ebe542/hexaroam/firmware/README.md

# Firmware

Current protocol status (2026-11-03): version 2 uses ACK/NACK, with 82 protocol tests, 75 register tests and all 21 no-servo UART scenarios confirmed by the owner. Full local verification passed 462 tests and all 17 checks; CI for this revision has not yet been reported. The dated implementation notes below retain earlier milestones. For current behavior, see the [protocol contract](../docs/servo-register-protocol.md).

Rust firmware for the central Pico and optional future servo-output expansion modules. The current program blinks the onboard LED and generates fixed servo pulses on GP0 and GP1 through one PIO state machine and DMA of Raspberry Pi Pico with RP2040, targeting `thumbv6m-none-eabi`. Operation with an attached servo is not verified.

See [development setup](../docs/development-setup.md) for prerequisites and [hardware references](../hardware/references/README.md) for archived datasheets.

## Firmware applications

Applications are independent Cargo packages under `apps/`; reusable libraries remain directly under `firmware/`.

| Application | Current scope |
| --- | --- |
| `apps/servo-controller` | Existing Pico servo-output application and manual hardware-test examples |
| [apps/calibration-station](apps/calibration-station/README.md) | Startup firmware, application-owned command/control library and a manual single-channel PIO/DMA test |

Station-specific request decoding and pulse-control policy live in `apps/calibration-station/src/command.rs` and `control.rs`. Its `src/lib.rs` exposes these modules for host tests, while `main.rs` owns Pico initialization. Shared protocol framing remains in `servo-protocol`. The station library tests run with an explicit host target through the shared tooling.

Use `python tools/dev.py build --app calibration-station` or `python tools/dev.py uf2 --app calibration-station` from the repository root. Without `--app`, these commands select `servo-controller`. Shared checks and documentation include both applications; see [development tools](../tools/README.md#application-selection).

The owner confirmed the station's UF2 upload, blinking LED and UART1 output. Local verification passed 854 tests and all 23 checks; hardware builds passed all 63 checks. The station now also has a [manual single-channel output test](apps/calibration-station/hardware_tests/README.md), confirmed on unloaded GP0 with UART1 phase messages; the main application still only performs startup logging and LED heartbeat. PC command handling and EEPROM access remain pending.

The calibration-station command/control library now includes a [request handler and protocol contract](apps/calibration-station/protocol.md), with 40 station host tests. The owner reported full local verification of 895 tests and all 24 checks passing. CI was subsequently reported green for this command/control revision. The application-owned PioPulseBackend adapter was then verified through the [controlled single-channel example](apps/calibration-station/hardware_tests/README.md#controlled-single-channel-output): the owner confirmed 1500/1700 us pulses, stop behavior, all five station hardware-build checks and 895 tests with all 24 verify checks passing. Normal-loop UART/PIO integration and CI for the adapter/test addition remain pending.

## EEPROM calibration storage

The [24xx256 EEPROM driver](eeprom/README.md) provides byte reads and page writes. The [shared storage layer](servo-storage/README.md) provides format validation, incremental scanning, write planning and bounded verified rotation. The [EEPROM adapters](servo-eeprom/README.md) expose a read-only controller path and a writable station path through CalibrationRead and CalibrationStorage.

The owner reported 186 storage tests, 46 adapter tests and full local verification of 837 tests with all 21 checks passing. CI was green for the preceding reader revision; CI for this writer revision is pending. Physical EEPROM tests, boot/protocol integration and station EEPROM integration remain pending. The normal Pico firmware has not been connected to this storage path.

## EEPROM hardware-test firmware

Separate [write/read and write-protection examples](../docs/eeprom-hardware-tests.md) are built for I2C1 GP18/GP19 at 400kHz and debug UART1 GP20. They use a configurable WP test setup and the final 128 EEPROM bytes. The owner reported all 63 hardware-build checks and full local verification of 837 tests with all 21 checks passing on 2026-11-08. Actual EEPROM execution remains pending; the normal Pico application is not connected to this storage path.

## Pico LED blink firmware

The onboard LED on GPIO25 alternates between on and off approximately every 500 ms. GPIO and clocks are initialized through the Pico board support package. The hardware timer supplies timestamps for nonblocking LED updates, allowing the main loop to service DMA continuously. The normal firmware now initializes UART1 logging and selects the bounded UART panic handler; see [logging](logging/README.md). Its main loop services servo DMA before the logger. The periodic alive message belongs to this demo, not a general runtime logging policy.

### Files

| File | Purpose |
| --- | --- |
| apps/servo-controller/Cargo.toml | Package metadata and dependencies |
| apps/servo-controller/Cargo.lock | Resolved dependency versions; commit this file |
| apps/servo-controller/.cargo/config.toml | Embedded target and linker flags |
| apps/servo-controller/memory.x | Flash, bootloader, and RAM layout |
| apps/servo-controller/build.rs | Makes the memory layout available to the linker |
| apps/servo-controller/src/main.rs | Board clock, GPIO, and timer initialization; starts the demo |
| apps/servo-controller/src/uart_logging.rs | Nonblocking HAL UART backend for the shared logger |
| apps/servo-controller/src/panic_uart.rs | Bounded direct UART1 panic output; selected only by uart_panic |
| logging/src/lib.rs | Hardware-independent buffered logging |
| logging/src/bounded_writer.rs | Direct formatted output with a shared attempt budget |
| apps/servo-controller/src/servo_demo.rs | Fixed plan construction, static buffer allocation, DMA servicing, and LED updates |
| servo-pio/src/output.rs | Prepared PIO output, fixed DMA transfer, and polling service |
| servo-pio/src/program.rs | Checked multi-channel PIO assembly |
| servo-pio/src/encoding.rs | Internal mask/counter encoding |
| servo-pio/src/buffer.rs | Complete encoded-plan storage |
| apps/servo-controller/src/drivers/servo_pio.rs | Historical per-channel driver; no longer compiled by main.rs |
| servo-signal/src/lib.rs | Hardware-independent limits and submission logic |
| servo-signal/src/tests.rs | Host unit tests using a test transport |
| ../rustfmt.toml | Repository-wide Rust formatting rules |

### Build

From the repository root:

```bash
cd firmware/apps/servo-controller
cargo check
cargo build
```

Run Cargo from this directory so its local `.cargo/config.toml` is loaded. `cargo check` checks code without producing a linked firmware image. `cargo build` produces the ELF executable at `target/thumbv6m-none-eabi/debug/servo-controller`, without a filename extension.

### Convert to UF2

Install the converter once on the development host, using the version exercised in this project:

```bash
cargo install elf2uf2-rs --version 2.2.0 --locked
elf2uf2-rs --help
```

This tool is installed for the host, separately from firmware dependencies. See its [versioned documentation](https://docs.rs/crate/elf2uf2-rs/2.2.0).

From `firmware/apps/servo-controller`:

```bash
elf2uf2-rs \
  target/thumbv6m-none-eabi/debug/servo-controller \
  target/thumbv6m-none-eabi/debug/servo-controller.uf2
```

### Transfer over USB

1. Disconnect the Pico.
2. Hold BOOTSEL while connecting it with a USB data cable.
3. Release BOOTSEL; the RPI-RP2 drive appears.
4. Copy the generated UF2 file onto that drive.
5. The Pico restarts automatically and the drive disappears.

On Windows, use File Explorer to copy the file. On Ubuntu, use the file manager to copy it to the mounted RPI-RP2 volume; the Ubuntu workflow has not yet been verified in this project.

The configured Cargo runner is `elf2uf2-rs`. From `firmware/apps/servo-controller`, run:

```bash
cargo run --locked
```

Cargo builds successfully before invoking the converter with the ELF path. The resulting UF2 is placed beside the ELF file. This command converts only; copying to RPI-RP2 remains manual. `cargo build` alone does not run the converter. A failed build can leave an older UF2 file present; transfer only after a successful build and conversion. No debug probe is configured.

### Verification record

On 2026-10-12, the project owner reported successful `cargo check`, `cargo build`, UF2 conversion, and USB transfer on Windows using Git Bash. The onboard LED was observed blinking on the physical Pico.

This confirms the basic build and hardware execution path. Exact signal timing, Ubuntu execution, and servo functionality are not verified. Clippy and formatter check results have not been reported.

### Version control

Commit source files, linker configuration, and Cargo.lock. Generated ELF and UF2 files remain under the ignored `target/` directory.

## Current fixed-plan PIO/DMA demo

`servo_demo::run()` uses PIO0 SM0 and DMA channel 0 for both GP0 (physical pin 1) and GP1 (physical pin 2). The configured plan has a 20,000-us period, a 1000-us High pulse on GP0, and a 2000-us High pulse on GP1. Both rising edges share one GPIO-mask update. This demo uses pulse widths directly; the angle library and ServoBank are not in its active command path.

PreparedOutput validates GPIO assignments and the integer divider for a 25 MHz PIO clock, installs the program, and sets the selected pins Low before enabling their output directions. start_fixed encodes the entire plan into a statically allocated OutputBuffer<6>. It writes the first complete entry into the FIFO, starts DMA for the remaining words, and then starts PIO. A static read-only slice keeps the encoded payload valid for all subsequent transfers. It cannot be updated in this fixed-plan experiment.

FixedOutput::service() polls DMA completion. Once complete, it retrieves the channel and TX handle and starts another transfer of the full plan. FIFO ordering keeps plans consecutive. There is no DMA completion interrupt yet. Call service frequently; blocking delays would risk underflow. The long final Low interval of the test plan provides rearm time, but a general worst-case latency guarantee has not yet been established.

The PIO program checks both words before applying each GPIO state. A missing word forces outputs Low, sets PIO IRQ flag 0, and enters a persistent loop. The demo does not yet expose fault status or implement controlled recovery. Dynamic plan updates, double-buffer switching, and application-level angle integration remain pending.

On 2026-10-17, the owner reported firmware execution and approximately 1 ms and 2 ms High durations with synchronous rising edges on the analog oscilloscope. The preceding full local check passed 114 tests, formatting checks, and the Pico build. A new period measurement, deliberate underflow tests, recovery, 18-channel timing, and attached-servo operation were not reported. Remote CI for this DMA integration is pending.

See the [PIO driver guide](servo-pio/README.md) for encoding and timing details. To reproduce the signal check, probe GP0 and GP1 against Pico GND, with servos disconnected.

## Separate hardware tests

The [hardware-test guide](apps/servo-controller/hardware_tests/README.md) describes independently selectable firmware for continuous fixed output and both underflow cases. Build all ELF and UF2 files with python tools/dev.py hardware-build from the repository root. Upload and evaluation remain manual. Tests are stored under hardware_tests and registered as Cargo example targets; the normal application does not need editing to select a fault experiment.

The owner reported a successful missing-entry experiment and immediate fault behavior in the missing-counter experiment, with no visible startup edges. The local check passed 121 unit tests and all hardware-test UF2 files were created. Exact period/fault timing and controlled recovery remain unverified. CI for this revision is pending.

## Two-buffer switching experiment

SwitchingOutput is a separate public driver that accepts complete replacement SignalPlan values with the startup period and output set. It uses one DMA channel and two exclusive static buffers. A prepared plan is selected after the current transfer completes; FIFO ordering keeps complete plans consecutive. submit_plan confirms acceptance only, not GPIO activation. The normal servo_demo remains fixed-plan.

The switching_signal_plans hardware test alternates the GP0/GP1 pulse assignments and checks Busy on an immediate second submission. On 2026-10-17 the owner reported expected operation, synchronous rising edges, and alternating High durations. Full verification passed 128 unit tests. See the [driver guide](servo-pio/README.md#two-buffer-signal-plan-replacement) and [hardware-test guide](apps/servo-controller/hardware_tests/README.md). Exact period/update timing, fault recovery, and 18-channel verification remain open; CI for this revision is pending.

## Persistent switching-output fault

SwitchingOutput detects and latches the reserved PIO underflow flag through is_faulted, submit_plan, and service. Once detected, new submissions return Faulted before Busy or validation, and service does not rearm DMA. Clearing the hardware flag does not resume PIO or clear the driver state. Existing DMA resources remain bound until an explicit restart safely aborts the transfer; service alone does not recover output. See [controlled restart](servo-pio/README.md#explicit-restart-after-a-fault).

On 2026-10-17 the owner reported all checks passing and faulted_signal_output running as expected. It checks fault precedence with a ready plan, persistence after hardware-flag clearing, and continued Low outputs during subsequent servicing. See the [hardware-test guide](apps/servo-controller/hardware_tests/README.md#persistent-driver-fault-test). The unit-test total remains 128; remote CI for this revision is pending.

## Historical per-channel PIO driver

The following sections describe the previous implementation retained in src/drivers. They are not the active DMA demo.

The application uses PIO0 state machine 0 with GP0 (physical Pico pin 1) and state machine 1 with GP1 (physical pin 2). ServoPio is generic over the PIO block, state machine index, and pin identifier. The associated P::PinFunction ties the GPIO function to the selected PIO block at compile time. Each channel owns its running state machine, private PioTransport adapter, limits, and pin. The PIO manager remains in main. This two-channel implementation is a learning step, not a finalized 18-channel design.

The module-level install_program function loads the eight-instruction program once. main creates a second handle with unsafe InstalledProgram::share before passing the handles to the two channel constructors. Sharing does not duplicate instructions in PIO memory. The safety condition is that the program must be uninstalled only once and only after all state machines using it have been uninitialized. This firmware never uninstalls it. Each constructor starts its channel separately; rising edges are not synchronized.

### Responsibilities

- `servo-signal` is a hardware-independent `no_std` library. PulseLimits validates inclusive application limits; submit_pulse validates requests and enforces a single pending update through PulseTransport.
- The private PioTransport implements the transport with the actual TX FIFO and converts microseconds to the PIO data word.
- The servo_pio module contains the PIO program and timing calculations. ServoPio initializes a channel from an installed program handle and owns its hardware resources.
- main selects the current experiment limits of 1000–2000 us and the initial pulse of 1500 us. These are test settings, not calibrated MZ996 limits.

The Pico package depends on the shared library through `path = "../servo-signal"`. See the [shared library guide](servo-signal/README.md) for API contracts and host test commands.

### Update semantics

A valid request is accepted only when the TX FIFO is empty. Exactly one complete 32-bit word is written. A pending request yields Busy without another write; requests outside the configured inclusive limits yield OutOfRange before the FIFO is accessed.

Ok means queued, not already active. At each period boundary, PIO uses PULL NOBLOCK and MOV X, OSR to adopt a pending word or retain the previous word. X retains the full last command; Y is the countdown register. No interrupt or DMA is required.

The policy requires a single writer through the private adapter. It prevents a backlog beyond one pending update, but does not overwrite that update. The application should retry its current desired target rather than queue rejected historical targets.

### PIO data and timing

The state machine runs at 1 MHz, using an integer divider derived from the system clock. The period is nominally 20,000 us. The low 16 bits contain the high-phase count and the high 16 bits contain the low-phase count; OUT shifts right.

The program occupies eight instructions (16 bytes). Labels and wrap directives occupy no instruction slots. There is no extra cycle for wrapping.

| Phase | Instructions accounted for | Cycles |
| --- | --- | --- |
| High | SET high; JMP Y-- loop | high count + 2 |
| Low | SET low; OUT; JMP Y-- loop; next PULL, MOV, OUT | low count + 6 |

Therefore high count = pulse width - 2 and low count = 20,000 - pulse width - 6. At 1500 us, the counts are 1498 and 18494. Encoding remains private to the PIO driver and must be reviewed with any program change.

The representable pulse range is 2–19,994 us for this program. This is a technical encoding range, not a servo operating range. Before configuring the state machine, the constructor rejects unsupported application limits with UnsupportedPulseLimits and an initial pulse outside those limits with InitialPulseOutOfRange. Clock-divider checks and the separate program installation can still panic; the constructor is not a fully fallible hardware initialization API.

GPIO is set low before enabling output direction. A validated initial data word is queued before starting PIO. Both channels initially output 1500 us for approximately one second. The application then requests -45, 0, and +45 degrees on GP0 and +45, 0, and -45 degrees on GP1 through separate Servo instances and synthetic calibrations. These map to 1000/1500/2000 us and 2000/1500/1000 us respectively. Commands cycle approximately once per second while the LED keeps blinking. Its demonstration loop uses expect on submission errors. Angle conversion and two-point calibration are implemented in servo-control. Physical servo calibration, output-disable controls, and multi-channel coordination are not implemented.

The dependencies remain rp-pico 0.9, rp2040-hal 0.10.2, and pio/pio-proc 0.2, with resolved versions recorded in Cargo.lock.

### Bench observations

2026-10-15, two-channel integration: the owner reported a successful local check with 68 passing tests, firmware execution with a blinking LED, and both pulse outputs following the agreed sequences. Rising edges were observed to be unsynchronized, as expected from separate state-machine starts. No new numerical timing or amplitude measurements were reported. Remote CI for this firmware revision has not yet been reported.

2026-10-13, initial fixed-pulse program: the owner observed approximately 19.8 ms period and 1.4 ms high time versus nominal 20 ms and 1.5 ms. That earlier program used separate startup counts and a different loop; its count corrections are not the current encoding.

2026-10-14, shared-library integration: the owner reported six passing host unit tests, a successful Pico build, and physical execution with apparently unchanged behavior of the three alternating pulse widths. The three widths had already been visually distinguished before extraction.

Instrument: Leader 1041, 40 MHz, two-channel analog oscilloscope. No servo was attached. Measurement uncertainty was not quantified and no measured amplitude was reported. These observations confirm basic operation, not precise timing accuracy, absence of short update glitches, or servo compatibility. Unit tests do not verify hardware FIFO behavior or ASM cycle timing. Initial configuration error paths and Clippy have not been specifically verified. The two-channel local check includes Rust formatting checks and the Pico build; Ubuntu hardware execution remains unverified.

For reproducing the signal check, connect the probes to GP0 and GP1 through the planned 180-ohm series resistors and their ground clips to Pico GND (for example physical pin 3). Keep the servo disconnected. Exact wiring and power details of the reported observations were not recorded.

## Angle library and historical integration

The library remains available, but the current fixed-plan DMA demo does not issue angle commands. The integration history below describes earlier firmware.

The [servo-control library](servo-control/README.md) provides an i32 centidegree Angle type, two-point calibration, and Servo angle commands through PulseOutput. On 2026-10-14 the owner reported a successful full local check with 21 control tests, 6 signal tests, 3 Python tests, formatting, and the existing Pico build. The library is now integrated into the Pico firmware: ServoPio implements PulseOutput and main owns a Servo configured with synthetic -45-degree / 1000-us and +45-degree / 2000-us calibration points. ServoPio still starts with an initial 1500-us pulse before the wrapper is constructed. Constructing Servo itself emits no command.

On 2026-10-14 the owner reported a successful full check, UF2 generation/upload, and firmware behavior as expected after integration. No servo was attached. This verifies the integrated command path without establishing physical joint angles, a measured servo calibration, or new precise timing measurements. The previous wrapper revision passed CI; a remote result for this integration is pending.

## UART logging and panic diagnostics

The [logging guide](logging/README.md) describes nonblocking Info, Debug, and Error output, whole-message rejection when the buffer is full, and bounded direct panic output. The [hardware-test guide](apps/servo-controller/hardware_tests/README.md#uart-connection-and-terminal) documents UART1 on GP20, the Waveshare TTL adapter, HTerm settings, and separate uart_diagnostics and uart_panic programs.

On 2026-10-17 the owner reported 17 passing logging tests and 145 passing tests in the full runner. Buffered output with LF-only line endings was received in HTerm. In uart_panic, the panic message appeared after approximately five seconds and the LED stayed on. These manual checks are additional to the unit tests. The owner subsequently confirmed simultaneous UART output and servo pulses in the regular demo, which now selects the UART panic handler. Early panic without UART initialization and a stalled UART have not been separately tested. The owner reported green CI for the earlier logging revision.

## Controlled signal-output restart

SwitchingOutput now offers explicit restart with a validated complete SignalPlan after a latched fault. It rejects healthy-state restart and invalid replacement plans, aborts its owned DMA channel with bounded polling, discards old FIFO contents, and starts the supplied plan from the beginning. An abort timeout leaves resources bound and the driver faulted. The normal application continues to use FixedOutput; its logging integration does not automatically switch it to this driver.

On 2026-10-17 the owner reported 149 passing unit tests and successful execution of restart_signal_output and restart_active_dma. Both showed initial pulses, a Low interval, successful restart, and expected LED phases. The second test additionally asserts that DMA is still active immediately before restart. See the [driver contract](servo-pio/README.md#explicit-restart-after-a-fault) and [hardware procedures](apps/servo-controller/hardware_tests/README.md#controlled-restart-tests). Forced abort-timeout verification remains pending, and CI for this recovery revision has not yet been reported.

## Calibration storage format

The [servo-storage library](servo-storage/README.md) provides hardware-independent calibration encoding/decoding, an interchangeable CRC-32 interface, journal-slot envelopes, newest-valid-record selection, and append/sector management through `JournalStorage`. On 2026-10-28 the owner reported 66 passing storage tests, followed by 238 passing tests and all 13 checks passing in the full local runner. The owner reported green CI for the combined journal-management revision. Selected read/write/erase failures and retries are simulated in host tests. The Pico linker now reserves the last 8 KiB for the journal; the flash backend, UART configuration and startup enforcement remain future work; no actual flash writes are performed. A valid record still requires completeness checks before normal operation.

### Reserved calibration flash

`apps/servo-controller/memory.x` excludes `0x101FE000..0x10200000` from firmware FLASH and exposes the journal boundaries as linker symbols. The two 4-KiB sectors contain no initialized firmware section. The owner reported the full 13-check verification passing after this change; read-only ELF inspection confirmed the boundaries and absence of overlapping segments. No hardware storage operation or upload was performed. See the [storage guide](servo-storage/README.md#pico-flash-reservation) for addresses, limits and the verification record.

### Read-only journal hardware test

The Pico now has a `JournalRead` backend in `apps/servo-controller/src/flash_journal.rs`; writing and erasing are not exposed by this reader. The [flash_journal_read procedure](apps/servo-controller/hardware_tests/README.md#read-only-calibration-journal-test) exercises the linker-reserved region separately from the normal servo demo. On 2026-10-28 the owner received `INFO Journal read OK: no valid record` and subsequently reported 244 passing tests and all 13 checks passing. This confirms the no-valid-record read path, not an erased-region check or persistence/write validation. The storage library has 72 host tests; the owner subsequently reported green CI for the read-only integration.

### RAM-execution preparation

The [RAM routine probe](apps/servo-controller/hardware_tests/README.md#ram-routine-probe) places a small non-inlined routine in `.data.ram_func`, using the existing startup copy into RAM. Debug ELF inspection verified its RAM execution address, flash load image and absence of helper calls in the probe body. On 2026-10-29 the owner received `INFO RAM routine OK` on the Pico and reported 244 passing tests and all 13 checks passing. XIP stayed enabled and flash contents were not modified by the running test. The owner subsequently reported green CI for the RAM probe. The next no-write XIP transition is recorded below; flash programming/erase tests remain future work.

### XIP transition preparation

The [flash_xip_cycle hardware test](apps/servo-controller/hardware_tests/README.md#xip-exit-and-restoration-test) prepares ROM function pointers and a RAM Boot2 copy, calls a RAM-resident transition with interrupts masked, leaves XIP and restores it before returning to normal flash execution. It performs no flash programming/erase, starts no second core or DMA and leaves servo output inactive. On 2026-10-29 the owner received `INFO XIP cycle OK` and reported 244 passing tests and all 13 checks passing. Debug ELF review found four indirect calls and no extra helper calls/flash literals in the 38-byte RAM routine. This verifies the standalone no-write transition; the storage writer, runtime exclusion and persistence remain future work. The owner subsequently reported green CI for the XIP-transition revision.

### Shared journal range validation

The [JournalLayout geometry helper](servo-storage/README.md#checked-journal-geometry) checks the journal extent and produces bounded whole-slot/whole-sector byte ranges. The Pico reader now uses it instead of its own slot arithmetic, while preserving linker-region validation and read-only access. On 2026-10-29 the owner reported 82 storage tests, 254 tests in total, all 13 checks passing and `INFO Journal read OK: no valid record` from the rebuilt hardware test. Flash programming and erase remain unimplemented. The owner subsequently reported green CI for this geometry/reader revision.

### Journal slot programming preparation

The standalone [flash_program_slot test](apps/servo-controller/hardware_tests/README.md#journal-slot-programming-test) writes a test pattern to an erased reserved slot through a RAM routine, restores XIP and checks every byte. On 2026-10-29 the owner received `INFO Journal slot program OK`, followed by `ERROR Journal slot 0 is not erased` after restarting. The owner reported 254 passing tests and all 13 checks passing. The pattern is not a valid calibration record; sector erasure, a Pico JournalStorage writer and runtime exclusion remain future work. The owner subsequently reported green CI for this programming revision. The preceding geometry/reader revision passed CI.

### Journal sector erase preparation

The [flash_erase_sector test](apps/servo-controller/hardware_tests/README.md#journal-sector-erase-test) erases reserved journal sector 0 from RAM, checks all 4096 bytes and verifies sector 1 is unchanged. The owner observed `INFO Journal sector erase OK` and `ERROR Journal sector 0 is already erased` after restart on 2026-10-29, with 269 passing tests, all 13 verification checks and all 33 hardware-build checks passing. The 58-byte RAM routine was reviewed using the generated map and disassembly. The test deliberately removes sector 0 contents; it is not the automatic journal writer. Backend integration and runtime exclusion remain future work. CI for this erase revision is pending.

### Pico calibration storage backend

[FlashJournalStorage](apps/servo-controller/src/flash_journal_storage.rs) now implements the existing JournalRead and JournalStorage contracts. It validates reserved ranges, requires program sources in RAM without an additional payload copy, checks erased slots, uses the reviewed RAM/ROM operations and verifies written/erased contents. The caller must uphold its unsafe exclusion contract; normal interrupt masking is internal.

On 2026-10-30 the owner confirmed backend read, program/repeat-rejection and erase hardware tests, followed by 275 passing tests and all 13 checks passing. All 37 hardware-build checks passed. See the [hardware procedures](apps/servo-controller/hardware_tests/README.md#flashjournalstorage-backend-tests) and updated [architecture maps](../docs/architecture/README.md). The normal fixed-plan servo demo is unchanged. Valid-record append/load across restart, sector rotation and service/startup integration remain future work. The owner subsequently reported green CI for this backend revision.

### Complete journal persistence test

On 2026-10-30 the owner confirmed [flash_journal_persistence](apps/servo-controller/hardware_tests/README.md#journal-persistence-test): append stored a valid synthetic eighteen-servo calibration record; load verified it immediately and after restart without rewriting. Both sequence 1 and all calibration values match the fixture. The owner reported 275 passing tests, all 13 verification checks and all 39 hardware-build checks passing. The normal servo demo remains unchanged, and the fixture is not a real robot calibration. Sector rotation, interrupted operations and runtime/service integration remain pending. CI for this persistence revision is pending; the preceding backend revision passed CI.

### Journal sector rotation on hardware

On 2026-10-30 the owner confirmed [flash_journal_rotation](apps/servo-controller/hardware_tests/README.md#journal-rotation-test): twenty-five records were appended/reloaded, both sectors were reclaimed through the existing journal policy, and previous-sector preservation was checked at every switch. Restart loaded sequence 25 and its complete fixture without further writes. The owner reported 275 passing tests, all 13 verification checks and all 41 hardware-build checks passing. The test deliberately clears both sectors during initial preparation. Interrupted-operation recovery, power-loss behavior and normal firmware/service integration remain future work. CI for this rotation revision is pending; the preceding persistence revision passed CI.

The rotation hardware test also reports sequence, sector and sector-local slot before each append and after verification. Its test-only automatic restart cycle verifies sequence 25 and appends marker 26, then prepares both sectors and reruns rotation on the following startup. The owner confirmed this behavior on 2026-10-30 and again reported 275 passing tests, all 13 verification checks and all 41 hardware-build checks passing. See the hardware-test guide for the current startup procedure. No manual repeat flag remains. CI for this combined rotation/progress/repeat revision is pending.

## Register-protocol framing

The [servo-protocol library](servo-protocol/README.md) implements hardware-independent header encoding, register-map plausibility checks, CRC-protected complete frames and incremental parsing with resynchronization and timeout events. On 2026-10-31 the owner reported 50 passing host tests after their expected failing phases. It is included in the development runner and combined Rustdoc task; the owner subsequently reported 326 passing tests and all 15 verification checks passing, plus all 8 documentation checks passing. CI for this protocol revision is pending. The register service, UART adapter and firmware-loop integration remain future work. See the [protocol draft](../docs/servo-register-protocol.md).

## Fixed register service and control

The [servo-registers library](servo-registers/README.md) implements protocol-version-2 ACK/NACK dispatch, Control WRITE/SET/CLR, target batches and backend-derived status. LastError was removed. The direct ServoBank backend and bounded FrameProcessor are host-tested; normal Pico application integration with real servo output and persisted calibration remains pending. See the package guide for the current 75-test breakdown.

## Register protocol integration tests

Seven [host integration tests](servo-registers/src/test_pipeline.rs) connect request bytes, parser, register service and encoded responses, including CRC rejection, resynchronization, timeout recovery and consecutive requests. The owner reported 48 package tests, 375 tests overall and all 17 verification checks passing on 2026-10-31. The owner subsequently confirmed green CI for this integration-test revision. These tests use a simulated output backend and do not exercise UART or change the normal Pico firmware.

## Target-angle register access

The [register service](servo-registers/README.md#target-angle-registers) now reads and writes consecutive i32 centidegree targets through OutputBackend. The shared test backend supports inactive preparation, active writes and atomic rejection; technical write failures latch Fault. On 2026-10-31 the owner reported 56 package tests, 383 tests overall and all 17 verification checks passing. The owner subsequently confirmed green CI for this target-register revision. The real ServoBank/PIO adapter and normal firmware integration remain future work.

## Target-register protocol tests

Four additional [byte-stream tests](servo-registers/src/test_pipeline.rs) verify full eighteen-target transfers, partial updates, atomic rejection of invalid batches and READ-boundary error recovery. The owner reported 60 package tests, 387 tests overall and all 17 verification checks passing on 2026-10-31. CI for this target-wire-test revision is pending. Tests retain the parser across requests and use a simulated output backend; ServoBank/PIO and UART integration remain future work.

## Preparing ServoBank targets

ServoBank now supports transactional prepare_targets without output and submit_prepared for a complete calibrated pulse batch. set_targets retains submission-before-commit behavior and can combine new targets with prepared values. The owner reported all 66 servo-control tests passing after observing ten new tests fail at their placeholders. The caller must ensure output is inactive during preparation; driver start/stop, automatic zero initialization and the register-service adapter remain future work. The owner subsequently confirmed 397 tests overall and all 17 verification checks passing for this combined revision; CI is pending. See the [servo-control guide](servo-control/README.md#preparing-targets-without-signal-output).

## Signal-plan lifecycle contract

The optional [SignalPlanLifecycle](servo-signal/src/signal_plan_lifecycle.rs) contract defines start with a complete initial plan, stop with confirmed Low outputs and no DMA buffer access, and logical output state. ServoSignalOutput forwards this contract with shared plan validation. The owner confirmed all 74 servo-control tests, 405 tests overall and all 17 verification checks passing on 2026-10-31 after observing eight new tests fail at placeholders. Only the simulated backend implements this lifecycle; regular PIO/DMA stop/start and the register-service adapter remain future work. No new hardware behavior is claimed. CI for this revision is pending.

## Regular PIO/DMA stop

SwitchingOutput now supports explicit stop with Low outputs, confirmed DMA abort and retained stopped resources. Repeated stop is harmless; servicing stopped output does nothing, pending replacements are discarded and ordinary submissions are rejected. Fault recovery remains explicit. On 2026-11-01 the owner confirmed the [stop hardware procedure](apps/servo-controller/hardware_tests/README.md#regular-output-stop-test), reran both restart_active_dma and restart_abort_timeout successfully, and reported 405 tests and all 17 verification checks passing. The internal hardware-test-only helper was subsequently feature-gated to remove a dead-code warning. Ordinary start after stop, a production SignalPlanLifecycle implementation and stop-specific timeout injection remain future work. CI for this revision is pending.

## Regular PIO/DMA startup after stop

SwitchingOutput now implements SignalPlanLifecycle and can start a complete validated plan from retained stopped resources. Invalid starts preserve stopped output; ordinary start rejects faults and does not clear them. On 2026-11-01 the owner confirmed [start_after_stop](apps/servo-controller/hardware_tests/README.md#regular-start-after-stop-test), including the Low pause and replacement signal widths, and reported 405 tests and all 17 verification checks passing. The preceding stop revision passed CI; CI for this startup revision is pending. The register-service adapter and normal firmware-loop integration remain future work.

## ServoBank lifecycle integration

ServoBank now conditionally exposes start_prepared, stop and state through PulseBankLifecycle. ServoSignalOutput implements the bridge to SignalPlanLifecycle, preserving target values and forwarding backend state/errors. On 2026-11-01 the owner confirmed 84 servo-control tests, 415 tests overall and all 17 verification checks passing after observing eight new tests fail at placeholders. These are PC results; the complete bank-to-PIO lifecycle hardware test was subsequently accepted as described below. The register-service backend adapter remains future work. The prior driver startup revision passed CI; The owner subsequently confirmed green CI for this bank-lifecycle revision. See the [servo-control guide](servo-control/README.md#servobank-lifecycle).

## ServoBank lifecycle hardware verification

On 2026-11-01 the owner accepted [servo_bank_lifecycle](apps/servo-controller/hardware_tests/README.md#servobank-lifecycle-hardware-test), confirming the principal Low -> 1/2 ms -> Low -> 1.5/2 ms sequence after all 47 hardware-build checks passed. The example uses unloaded GPIOs and a test-only running bootstrap followed by immediate stop. The owner subsequently reported 415 tests and all 17 verification checks passing for this hardware-example revision. CI is pending; no endurance-test result is claimed.

## Register service connected to ServoBank

The [direct bank backend](servo-registers/README.md#direct-servobank-backend) implements OutputBackend for ServoBank without another target store or state cache. It supports preparation while stopped, active batch submission, lifecycle operations and service forwarding through RegisterService. Uninitialized targets have an explicit state error. The owner confirmed 72 register-package tests, 427 tests overall and all 17 verification checks passing on 2026-11-01. These are PC integration tests with a recording output; UART, journal-driven calibration and the register-service-to-PIO hardware path remain future work. CI for this revision is pending.

## Byte transport and response buffering

ByteTransport and ResponseBuffer in servo-protocol provide nonblocking byte I/O contracts and bounded transmission of one owned encoded response. Backpressure/errors retain the unsent suffix; pending responses cannot be overwritten. On 2026-11-02 the owner reported all 62 protocol tests, 439 tests overall and all 17 verification checks passing after observing twelve new tests fail at placeholders. Only a simulated transport is tested; real UART reception/transmission and the application loop remain future work. CI for this revision is pending. See the [protocol transport guide](servo-protocol/README.md#nonblocking-byte-transport-and-response-buffer).

## Byte transport with register-frame processing

The combined revision includes ByteTransport, a bounded single-response buffer and FrameProcessor connecting transport bytes to the parser, register service and encoded replies. Output servicing continues during response backpressure; deferred timeouts retain complete requests. The owner reported 62 protocol-package tests, 84 register-package tests, 451 tests overall and all 17 checks passing on 2026-11-02. These are PC results with simulated transport/output; the Pico UART driver and physical end-to-end protocol path remain future work. CI for this combined revision is pending. See the [frame-processing guide](servo-registers/README.md#frame-processing-over-a-byte-transport).

## Protocol UART driver and loopback

The [UART byte transport](apps/servo-controller/src/uart_transport.rs) implements ByteTransport without blocking and reports receive errors explicitly. Shared hardware-test initialization now exposes UART0 separately from UART1 diagnostics. On 2026-11-02 the owner confirmed [uart_loopback](apps/servo-controller/hardware_tests/README.md#protocol-uart-byte-transport-loopback): the two expected messages prove the test verified all 1024 bytes over the GP16/GP17 jumper. Full verification reported 451 tests and all 17 checks passing. The FrameProcessor is not connected to UART yet; the normal Pico firmware is unchanged. CI for this revision is pending.

## UART register hardware verification

On 2026-11-03 the owner confirmed all 21 protocol-version-2 [UART register scenarios](apps/servo-controller/hardware_tests/README.md#uart-register-requestresponse-test) on real hardware. The no-servo example uses UART0 GP16/GP17 for binary ACK/NACK, with diagnostics on UART1 GP20. Full local verification passed 462 tests and all 17 checks. CI for the current revision has not yet been reported. Real protocol-driven servo output, calibration transfer and watchdog/restart integration remain future work.
## Calibration-station UART runtime

The normal station application now connects UART0 on GP16/GP17 at 115200 baud to COBS/CRC32 framing, the station handler and CalibrationControl/PioPulseBackend on GP0. UART1 GP20 remains debug-only. main.rs initializes board resources; app.rs assembles hardware and continuously services the bounded frame processor, logging and LED heartbeat. Startup leaves output inactive without a prepared pulse. Receive-idle timeout is initially 100 ms and is applied only after observing empty reception.

The owner confirmed all 13 [station UART scenarios](apps/calibration-station/hardware_tests/suites/README.md), then reported 909 tests with zero failures and all 24 verification checks passing. The 54 station host tests include 14 frame-processor tests. Earlier adapter examples confirmed pulses separately. The owner subsequently confirmed the slow full-chain UART scope suite: one scenario passed with correct observed pulses, including stop and restart. Physical servo operation and EEPROM integration remain pending. CI for this revision is pending.

## PC calibration-document model

The [JSON document guide](../docs/calibration-data.md) describes the PC-side model in tools/hexaroam_tools/calibration_data.py. It preserves the existing two-point angle/pulse representation, supports incomplete drafts and requires complete channel coverage before future export. This introduces no firmware or EEPROM write operation. The owner reported 933 passing tests and all 24 local verification checks; CI for the data-model addition is pending.

## PC calibration console

The [interactive console](../docs/calibration-console.md) now combines validated calibration documents, fresh two-point sessions and the synchronous station UART client in the installable hexaroam_tools package. The owner confirmed the six-operation hardware client check and the synthetic interactive capture/save procedure. Actual servo measurement and EEPROM export/programming remain pending. CI for this combined PC-tool revision is pending.
