ebe542/hexaroam/tools/README.md

# Development tools

Use Python 3.10 or newer. The development runner uses only the standard library; the optional UART hardware runner requires pySerial. From the repository root:

| Command | Task |
| --- | --- |
| `python tools/dev.py install` | Install Rust components, the Pico target and elf2uf2-rs for the active toolchain |
| `python tools/dev.py doc` | Generate combined HTML documentation for all eleven Rust packages |
| `python tools/dev.py test` | Python tooling tests and host tests for all registered Rust libraries |
| `python tools/dev.py fmt` | Format all registered Rust packages; modifies source files |
| `python tools/dev.py check` | Check formatting and run cargo check for all registered Rust packages; no unit tests or linked firmware image |
| `python tools/dev.py build` | Build servo-controller ELF by default; select another application with --app; no UF2 conversion |
| `python tools/dev.py verify` | Full verification: Python tests, registered Rust formatting/host tests, and builds of both firmware applications |
| `python tools/dev.py hardware-build` | Build all registered Pico hardware tests with ELF, UF2, linker map and disassembly; no execution or upload |
| `python tools/dev.py uf2` | Build and convert firmware with the Cargo runner; no automatic upload |

On Ubuntu use python3 if python is unavailable. Cargo must be on PATH. check and verify require rustfmt and thumbv6m-none-eabi. build requires the embedded target. uf2 additionally requires elf2uf2-rs.

## Application selection

Two independent Pico binaries live under `firmware/apps/`: `servo-controller` and [calibration-station](../firmware/apps/calibration-station/README.md). Shared libraries remain directly under `firmware/`.

From the repository root:

```bash
python tools/dev.py build --app calibration-station
python tools/dev.py uf2 --app calibration-station
python tools/dev.py hardware-build --app calibration-station
python tools/dev.py hardware-build --app servo-controller
```

`build` and `uf2` default to `servo-controller`. `hardware-build` defaults to both applications and skips those without hardware-test sources. The calibration station provides the [single-channel output test](../firmware/apps/calibration-station/hardware_tests/README.md). A detected source must also be registered as an example in the application's Cargo.toml, with the `hardware-tests` feature available; source detection does not validate Cargo registration.

`fmt`, `check`, `verify` and `doc` cover both applications and reject `--app`. Shared library tests run once per registered library. The calibration station also has an application-owned library: `test` and `verify` run its tests with `cargo test --lib --locked --target host-tuple`, so its local Pico target does not select the embedded architecture for PC tests. Board/runtime dependencies are target-specific. Station documentation is generated from its library, while the controller still documents its binary. `test` and `install` also reject `--app`; tool installation remains shared.

UF2 output for the station is `firmware/apps/calibration-station/target/thumbv6m-none-eabi/debug/calibration-station.uf2`. The runner converts firmware without uploading it.

The owner reported 854 tests with zero failures and all 23 verify checks passing, plus all 63 hardware-build checks passing. The station's upload, blinking LED and UART1 startup message were confirmed on the Pico. CI was subsequently reported green for this application/tooling revision. The later single-channel station hardware test has separate verification notes in its guide.

## Python package setup

Reusable PC modules live in the regular [hexaroam_tools package](hexaroam_tools/__init__.py). Install it in the selected environment before running project tests or tools:

```bash
python -m pip install -e .
```

For serial hardware tools and the calibration console use `python -m pip install -e ".[hardware]"`. The editor and terminal should use the same interpreter. Imports use the package name rather than runtime sys.path changes or editor-only path configuration. CI installs the local package before tests and includes pyproject.toml in its workflow path filters.

## Output and totals

The runner resolves directories from its own path and launches commands without a shell. It displays merged stdout/stderr line by line and captures the same text for summary parsing. Child Python output uses UTF-8 and unbuffered mode; child colors are enabled for interactive terminals and GitHub Actions. NO_COLOR explicitly disables colors; redirected non-CI output stays plain. Rust test-harness colors are explicitly enabled when appropriate. Captured text retains ANSI colors; only the parser input is stripped of ANSI control sequences.

All independent task steps run even after failures. The final overview lists each step and its process status. A nonzero child exit code causes a nonzero overall exit code, regardless of later successes or parsed test counts. Missing/unlaunchable commands are reported as failed steps.

Only Cargo test commands and Python unittest commands contribute test counts. Formatting, builds, and UF2 conversion do not. The total sums passed, failed, skipped/ignored, and filtered-out cases separately; filtered-out cases were not executed.

Each test process must contain exactly one recognizable summary. Compilation errors, unsupported categories, and ambiguous/missing summaries produce "Test count: unknown". If any group is unknown, only a "Known subtotal" is shown, explicitly marked incomplete. An unknown count alone does not override a successful process exit code.

The parser handles the currently used Rust libtest and Python unittest text formats. It does not use unstable Rust JSON output. New output formats require parser updates and tests. Benchmarks and unittest expected-failure categories are not supported. Counts are never hard-coded.

The uf2 task uses cargo run: conversion remains dependent on a successful build inside Cargo. The runner itself does not install tools or flash hardware.

## Tests

```bash
python -m unittest discover -s tools -p "test_*.py" -v
```

Python tests mock process execution, so they do not launch Cargo recursively. The runner's test/verify tasks discover both test_dev.py and test_result_parser.py. Coverage includes command capture, failure handling, aggregate process status, test totals, unknown summaries, and parser fixtures.

The owner previously reported the 15 parser tests passing and successful local/CI runs before this integration. The new runner integration and added tests have not been executed by the assistant; local and remote verification are pending.

## Workflow

```bash
python tools/dev.py verify
```

If formatting fails, run fmt, review git diff, then rerun verify. GitHub Actions calls the same test/verify tasks on its configured Windows/Ubuntu runners. No workflow modification is needed for the new test discovery.

See [development setup](../docs/development-setup.md) and [firmware instructions](../firmware/README.md).

The runner also colors its own step results and overall status: only PASS/PASSED is green and FAIL/FAILED is red; brackets, command text, counts, and headers stay plain. NO_COLOR and plain redirected output disable these colors. Numeric totals remain plain text.

The servo-pio encoder package is included in test, fmt, check, and verify. The owner reported 102 passing tests in the full local check after adding its nine encoding tests. CI uses the same task definitions; the workflow file requires no change for this package. The previous full check task is now named verify. check only checks Rust formatting and compilation; it does not run tests or link the Pico firmware. Cargo may still compile dependencies and execute build scripts as required by cargo check.

## Hardware-test builds

From the repository root:

```bash
python tools/dev.py hardware-build
```

By default this considers both firmware applications. For each application with a direct `hardware_tests/*.rs` source file, it runs `cargo build --locked --examples --features hardware-tests --message-format=json-render-diagnostics`. Applications without such sources are skipped before Cargo is invoked; the `[SKIP]` message appears immediately and again in the Summary, without adding a check or unit-test skip count. Cargo discovers the registered example targets in Cargo.toml, including those stored under hardware_tests. Adding another registered hardware test does not require listing its name in dev.py.

The task produces ELF executables under firmware/apps/servo-controller/target/thumbv6m-none-eabi/debug/examples. It requires the Pico Rust target, elf2uf2-rs and llvm-tools-preview in the active Rust toolchain. It does not execute tests or add them to unit-test totals. Hardware-test programs are not built or executed by test, check, or verify; hardware-build remains explicit.

To build and convert one selected hardware test to UF2, run from firmware/apps/servo-controller:

```bash
cargo run --locked --example underflow_missing_counter --features hardware-tests
```

The configured Cargo runner performs conversion only; transfer to the Pico and evaluation remain manual. hardware-build reads Cargo compiler-artifact messages and invokes elf2uf2-rs directly for each reported example executable, including unchanged/fresh artifacts. UF2 files are written beside their ELF files. A failed build skips all conversions; a conversion failure keeps the task failed even if later conversions succeed. No executable artifacts after a successful build are treated as an error. Existing UF2 files can remain after a failed run; use only results from a fully successful run.

The owner reported a full local check with 121 passing unit tests and successful creation of the hardware-test UF2 files. Seven runner tests cover Cargo artifact discovery, cached artifacts, build-failure conversion suppression, per-artifact conversion, conversion failure propagation, missing artifacts, and diagnostic display. See the [manual hardware-test guide](../firmware/apps/servo-controller/hardware_tests/README.md) for setup and expected signals. Remote CI for this revision is pending.

## Linker maps and disassembly

Install the additional Rust component once (Windows and Ubuntu):

```bash
rustup component add llvm-tools-preview
```

`python tools/dev.py hardware-build` now produces `<example>.map` and `<example>.disasm` beside each ELF and UF2 in the target examples directory. The map records linker placement; the disassembly contains section headers, symbols and disassembled executable sections, with demangled names. Generated files remain under ignored target directories. These files support manual review; their generation does not automatically validate RAM-only execution.

After the initial all-example build discovers Cargo artifacts, the runner invokes `cargo rustc` once per example with a separate linker map destination. Each uses a temporary unique map path to force relinking, including when previous reports have been removed. Dependencies still use Cargo's cache. LLVM is found under the active `rustc --print sysroot`; cargo-binutils is not required. Disassembly is written directly to a temporary file, not printed to the terminal. After successful generation, reports replace the previous files, then UF2 conversion uses the newly linked ELF.

Missing LLVM tools, failed relinking, unexpected ELF output, missing/empty maps or disassembly, and conversion errors fail the overall task. A failed report step skips UF2 conversion for that example; other examples are still processed. Existing outputs may remain after failure and must not be treated as current. Only use a fully successful run. Normal build/check/verify tasks retain their existing behavior and do not require LLVM tools. Automated tests mock Cargo and LLVM; the owner runs verification and real hardware builds.

## Install development tools

After the [Windows or Ubuntu prerequisites](../docs/development-setup.md) are available, run:

```bash
python tools/dev.py install
```

The command installs rustfmt, clippy and llvm-tools-preview for the active Rust toolchain, the thumbv6m-none-eabi target, and elf2uf2-rs version 2.2.0 with its packaged lockfile. Commands run from firmware/apps/servo-controller to respect the same rustup overrides as hardware builds. The converter explicitly targets the host architecture, not the Pico. Existing matching installations can be reused without forcing reinstallation. It does not install or update Rust itself or change the default toolchain.

Python 3.10+, Rustup with a working Rust/Cargo toolchain, and host build prerequisites must already be installed and available on PATH. Windows requires the MSVC C++ build tools and Windows SDK; Ubuntu requires the documented build-essential setup. Run as your normal user; the task does not invoke sudo or an OS package manager, modify PATH, install editor extensions, or flash hardware. Downloads require network access. Cargo's bin directory must be on PATH for later UF2 commands.

All three installation steps appear in the summary. Independent steps are attempted even after a failure, and any failure makes the overall task fail. Installation does not count as unit tests. The new tests mock all commands; actual installation and verification are performed by the owner.

## Combined Rust documentation

Run from the repository root:

```bash
python tools/dev.py doc
```

The task documents servo-signal, servo-control, servo-pio, logging, servo-storage, servo-protocol, servo-registers and the Pico binary using cargo doc --locked --no-deps --document-private-items. All packages use the thumbv6m-none-eabi target, so embedded-only PIO code is included. Cargo/Rustdoc and the embedded target are required; no extra Python package, cargo-modules or Graphviz installation is needed.

After all eight commands succeed, an overview links the generated crate pages at:

```text
target/rustdoc/thumbv6m-none-eabi/doc/index.html
```

Open this file manually in a browser. The task does not automatically open windows. The shared output contains the project's package documentation, with module navigation, types, trait implementations and implementors. Dependency documentation is omitted; some external links therefore lead outside the generated pages. This is navigable API documentation, not an automatically generated architecture graph. Only compiled library/binary modules for the selected target and default features are included; hardware-test examples and modules used only by those examples are excluded.

Commands run sequentially in their package directories with a shared target directory. Rustdoc output is cumulative. A failed package does not prevent the remaining commands, but suppresses overview generation and fails the task. Missing expected crate pages also fail overview generation. Old generated files may remain after a failure: use only a successful run and regenerate after changes. Generated output is ignored by Git. The task does not execute doctests, host tests, hardware programs or firmware uploads and is separate from verify. Tests mock Cargo; real generation and browser review remain with the owner.

## Protocol package integration

servo-protocol is included in test, fmt, check, verify and the shared doc output. Its 50 owner-reported host tests cover header, validation, complete-frame codec and incremental parsing without UART hardware. The protocol is not added to the normal Pico binary or hardware examples yet. The runner's package-inclusion test and documentation tests are updated for seven packages. The owner reported 326 passing tests and all 15 verification checks passing, plus all 8 documentation checks passing. No tests were run by the assistant; CI for this protocol revision is pending.

## Register-service integration

servo-registers is included in test/fmt/check/verify and shared Rustdoc output. Its 41 owner-reported host tests exercise fixed registers, ControlRegister and dispatch through a simulated output backend. The documentation task now includes eight Rust packages. Runner inclusion is covered by test_register_tasks.py and the documentation tests are updated accordingly. The owner confirmed all 17 verification checks and all 9 shared documentation checks passing, including the 41 register-service tests. No tests were run by the assistant; CI for this addition is pending. The normal Pico build and hardware examples do not use this service yet.

## UART hardware suites

Run these commands from the repository root. Create a virtual environment once:

```bash
python -m venv .venv
```

Activate it in Windows Git Bash:

```bash
source .venv/Scripts/activate
```

Or on Ubuntu:

```bash
source .venv/bin/activate
```

Install the optional hardware dependencies into the active environment:

```bash
python -m pip install -e ".[hardware]"
```

Flash the matching `uart_registers` hardware-test firmware first. Use a 3.3-V TTL adapter: Pico GP16 (TX) to adapter RX, GP17 (RX) to adapter TX, and common GND. Remove the GP16-to-GP17 loopback jumper. Close HTerm or any other application using the serial port before starting the runner.

Run all scenarios (replace the port with your actual device):

```bash
python tools/uart_test.py --port COM5 --suite uart_registers
```

On Ubuntu, for example:

```bash
python tools/uart_test.py --port /dev/ttyUSB0 --suite uart_registers
```

Bare suite names, with or without `.json`, resolve in `firmware/apps/servo-controller/hardware_tests/suites/`, independently of the working directory. Explicit relative paths resolve from the current working directory. Select a single scenario or supply a different suite path:

```bash
python tools/uart_test.py --port COM5 --suite uart_registers --case read_status
python tools/uart_test.py --port COM5 --suite ./other-tests/custom.json
```

For steps expecting a reply, `observe_ms` is the maximum wait for the complete expected bytes. After a correct complete reply the runner observes another 20 ms for trailing bytes, then proceeds. A response completing near the timeout still receives the full 20-ms settling window. Steps expecting no response retain their entire `observe_ms` observation period (currently 200 ms); those pauses also allow the firmware's receive-idle timeout to recover incomplete candidates. Bytes arriving after the settling window may be detected before a later step, but are not guaranteed to be attributed to their original response. This shorter observation policy has not yet been verified on hardware.

Repeat `--case` to select multiple scenarios. Execution stops at the first failure; the summary distinguishes passed, failed and not-completed scenarios. Exit codes are 0 for success, 1 for a failed hardware check, 2 for configuration or serial errors, and 130 for interruption.

These tests communicate with real hardware and are started manually; `dev.py verify` and CI do not execute them. See the [test vectors and verification record](../docs/uart-register-test-vectors.md).

## Bounded polling in UART suites

A step can optionally specify `retry_rx_hex` (one exact permitted intermediate response), `max_attempts` (at least 2) and `retry_delay_ms` (nonnegative). The final response remains `expected_rx_hex`; each attempt uses the same request and per-attempt response timeout. Only a complete permitted intermediate response triggers another request. Both final and intermediate replies receive the normal 20-ms settling window to detect extra bytes. Unknown replies, missing/incomplete replies, transport errors and attempt exhaustion fail the step. Ordinary steps default to one attempt. A no-reply step cannot enable retries.

The [calibration persistence suite](../docs/uart-calibration-persistence.md) uses this for READ Status: retry on exact Busy, finish on Success, fail on storage-error status. It does not automatically repeat calibration WRITEs. Run the matching flash-writing firmware and reset before the complete suite:

```bash
python tools/uart_test.py --port COM6 --suite uart_calibration_persistence
```

On 2026-11-04 the owner reported the complete three-case calibration suite passing on real hardware after restart, using COM6 and the five-second response timeout. This verifies the suite run but does not establish that a Busy intermediate reply was observed. No simulated serial tests have been added.

## UART throughput benchmark

See [benchmark setup, commands and limitations](../docs/uart-benchmark.md). The benchmark uses the COBS command protocol and an 18-servo bank with a simulated pulse sink on real Pico hardware. It measures no physical PIO/DMA output. The owner completed the documented sink18 COBS measurements at all three rates; the earlier register-protocol timeout remains unresolved. The new explicit `--fixture pio2` mode reuses uart_commands firmware for real two-channel PIO/DMA, with optional `--rate` and expected Busy counting; the owner verified a 60-second paced run (1486 ACK, no Busy) and a 60-second overload run (3000 ACK, 7021 expected Busy, no other errors) and confirmed correct pulses. See the benchmark guide for scope limits and pending CI.

## COBS command hardware suites

Use `python tools/uart_test.py --port COM6 --suite uart_commands` with the matching firmware. The optional suite field `"framing": "cobs_crc32"` selects COBS/CRC32; omitted framing retains the register protocol. See [setup, scenarios, limits and separate oscilloscope suite](../docs/uart-command-tests.md). The owner reported all 23 command-suite cases and the separate scope case passing on real hardware, including correct signal observations, on 2026-11-06. These are manual hardware checks, not CI tests.

## EEPROM driver integration

`firmware/eeprom` is included in test, fmt, check, verify and doc. Its Cargo.lock is committed so CI can use `--locked`. The existing workflow already invokes the shared test/verify tasks and needs no package-specific change. The documentation task's expected package inventory in `test_doc.py` includes the EEPROM crate.

The owner reported 697 passing tests and all 19 verification checks passing after adding the 32 EEPROM driver tests. These are PC tests; the driver has not been exercised against a physical EEPROM. See the [EEPROM guide](../firmware/eeprom/README.md) for API, write completion and verification limits. The owner subsequently reported CI green for the driver revision.

## EEPROM calibration storage integration

`firmware/servo-eeprom` is included in test, fmt, check, verify and doc with a committed Cargo.lock. The documentation inventory and its test include eleven Rust packages. Existing CI uses the shared test/verify tasks without a workflow change.

The owner reported CI green for the original reader revision. The current writer revision passed 837 tests and all 21 local verification checks, including 186 storage tests and 46 adapter tests. The [storage adapter guide](../firmware/servo-eeprom/README.md) explains the end-to-end PC coverage, retry behavior and remaining hardware checks. CI for this writer revision is pending.

## Calibration-station UART suite

The [station suite procedure](../firmware/apps/calibration-station/hardware_tests/suites/README.md) targets the normal calibration-station application. Use an explicit suite path from the repository root:

```bash
python tools/uart_test.py --port COM8 --suite firmware/apps/calibration-station/hardware_tests/suites/uart_calibration_station.json
```

A suite may define a nonempty fixture_checks list using the same step objects as its scenarios. This replaces the default fixed-layout fixture preflight and supports the station's ten-byte status response without adding an application-specific branch. Existing suites without that field retain their previous fixture checks. Bare suite-name lookup still defaults to servo-controller.

The owner confirmed all 13 station UART scenarios and full verification of 909 tests with all 24 checks. The separate scope suite was subsequently confirmed: one scenario passed and the owner observed correct pulses on unloaded GP0. Use the same suite path with filename uart_calibration_station_scope.json after restarting the Pico. The current Windows setup uses COM8 for UART0 protocol and COM7 for UART1 debug. No physical servo test is claimed. CI for this framing/runtime/suite revision is pending.

## Calibration data model

[calibration_data.py](hexaroam_tools/calibration_data.py) provides frozen ServoCalibration and CalibrationData models plus JSON/file loading and saving. It uses only the Python standard library and has no UART or hardware dependency. See the [format and bench workflow](../docs/calibration-data.md) for schema version 1, units, validation, drafts and completeness checks.

The data model's 24 tests are discovered automatically by the existing test/verify tasks. The owner reported 933 tests with zero failures and all 24 verification checks passing. These results cover the original data-model step. The subsequently implemented [interactive console](../docs/calibration-console.md) also includes measurement sessions and the UART client; binary export and EEPROM programming remain pending. CI for this data-model addition is pending.

## Interactive calibration console

The installed command `hexaroam-calibrate` connects the PC data model, two-point session and UART client. See the [complete console guide](../docs/calibration-console.md) for installation, arguments, commands, error handling and the synthetic hardware smoke check.

```bash
hexaroam-calibrate --port COM8 --file local-data/calibration/servos.json --servo-count 18 --servo-id 0
```

The owner confirmed the six-operation client hardware check and a successful interactive capture/save using fictional angles on an unloaded GPIO. Pure Python coverage comprises 24 document tests, 16 session tests and ten angle-conversion tests. The most recent separately quantified full verification was 949 tests and all 24 checks before the angle-conversion additions; the subsequent console procedure was reported successful. CI for the combined PC-tool revision is pending.
