ebe542/hexaroam/configs/README.md

# Robot configurations

Store versioned geometry, joint mappings, calibration, and motion limits. A schema will be chosen with the first implementation. Associate each configuration with its hardware revision; do not commit credentials here.
