ebe542/hexaroam/simulation/README.md

# Simulation

Add robot models and experiments as kinematics development begins. Use the same joint identities and target conventions as hardware. Record imported model provenance. Simulation does not verify power, signal timing, or actual servo feedback.
