ebe542/hexaroam/software/README.md

# Robot software

Implement motion, sensors, navigation, and behavior incrementally. Rust is planned for kinematics and motion; Python for later AI and experiments. Keep hardware access behind interfaces and ROS integration optional.
