ebe542/hexaroam/hardware/mechanics/README.md

# Mechanics

Store CAD sources, printable files, assembly instructions, and revision notes here. Identify imported designs and modified parts. Record print settings and fit checks for each built revision.
