ebe542/hexaroam/firmware/servo-storage/README.md

# Calibration data format

`hexaroam-servo-storage` is a hardware-independent, `no_std` library for encoding and decoding servo calibration records. It reuses `Calibration` from `hexaroam-servo-control`; it does not access flash, UART, DMA or servo outputs.

## Medium-independent calibration storage

`CalibrationRead<const N: usize>` and `CalibrationStorage<const N: usize>` in [calibration_storage.rs](src/calibration_storage.rs) define the application-facing storage boundary:

- `load()` returns `Result<Option<[Calibration; N]>, Error>`: a complete validated dataset, no valid complete dataset, or a storage error. Missing data must not authorize servo output.
- `save(&[Calibration; N])` saves a complete dataset and requires readback verification before success. Unchanged data must not cause another write.
- Servo IDs are array indices. The interface exposes no slot index, sequence number, sector, byte address or erase operation.
- The implementation owns encoding, integrity checks, sequence selection, rotation and any erasure required by its medium. A failed save may have partially modified storage.

The operating controller uses the read-only EepromCalibrationReader. The separate station uses EepromCalibrationStorage, which implements both CalibrationRead and CalibrationStorage. See the [EEPROM adapters](../servo-eeprom/README.md); both delegate to shared algorithms in this crate and the lower-level [EEPROM driver](../eeprom/README.md).

The existing JournalStorage, two-sector layout and journal functions below remain the earlier flash-oriented implementation. JournalRead itself only requires a complete slot read and is reused by the EEPROM adapter. These lower-level contracts are not the medium-independent application API. The binary format still permits missing entries; the application contract requires a complete array. No new active/validity flag was added.

## Slot layout and incremental loading

`SlotLayout` describes a nonempty region with a start address aligned to SLOT_SIZE, a configurable slot count and a checked storage capacity. It detects range arithmetic overflow and invalid indices without assuming erase sectors. The EEPROM adapter uses 64 slots of 512 bytes starting at zero; the older JournalLayout remains for the flash implementation.

`load_calibrations<N, SLOTS, S>()` accepts JournalRead and Checksum. It scans slots individually and records valid sequence numbers to reject duplicates, including duplicate older sequences. It retains one slot buffer and the newest decoded candidate instead of buffering all slot images. Storage errors abort; invalid records are skipped.

The newest format/CRC-valid record is selected before checking completeness. Missing entries in that record return IncompleteCalibration with the first missing Servo ID; no older complete record is substituted. No valid record returns None. Zero slots and zero servos are rejected before storage access. The loader returns only complete calibrations; physical slot and sequence metadata remain internal to the storage path.

The original reader revision passed 124 storage tests and CI. The owner now reports 186 storage tests, 46 adapter tests and full local verification of 837 tests with all 21 checks passing. Hardware verification and application integration remain pending; CI for the writer revision is pending.

## Verified writes and bounded rotation

scan_calibrations exposes LocatedRecord metadata for storage management; load_calibrations delegates scanning and separately checks completeness. plan_calibration_write compares complete datasets, handles unchanged data, and chooses the next slot/sequence without I/O.

SlotWrite extends JournalRead with byte-range overwrite, without an erase operation. Its backend validates the requested range, changes no bytes outside it and waits for write completion; errors may leave partial changes. write_calibration_slot performs one attempt: encode, invalidate identifier, verify invalidation, write body, restore identifier, then compare a complete readback. Format constants remain in journal_slot.rs.

save_calibrations requires at least two slots. It protects the original newest valid slot and permits at most three different targets. Only invalidation/readback mismatches permit retry; bus/encoding errors abort. Retry scans do not apply the unchanged-data shortcut, skip protected/attempted slots, and allocate a sequence greater than both the scan maximum and the previous attempt. The u64 sequence never wraps. An incomplete latest dataset may be replaced by a complete one.

A failed save can leave a new valid record, so it does not promise rollback or that the next load returns the original record. For example, padding is ignored by decoding but checked during exact write verification. The caller must treat save errors as errors and verify the medium before returning it to use. The EEPROM adapters expose the shared logic through CalibrationRead and CalibrationStorage.

The 62 new core tests comprise 14 incremental scan, 15 write-planning, 11 single-attempt and 22 save-management tests, increasing the package total from 124 to 186.

## Version 1 representation

All multibyte values are little endian. The record has no implicit padding.

| Field | Size | Representation |
| --- | --- | --- |
| Identifier and version | 2 bytes | `48 01` hexadecimal |
| Payload length | 2 bytes | `u16`, bytes occupied by entries |
| Entries | 20 bytes each | Servo ID `u32`, lower angle `i32`, lower pulse `u32`, upper angle `i32`, upper pulse `u32` |
| CRC | 4 bytes | CRC-32/ISO-HDLC over header and payload |

Angles are hundredths of a degree; pulse widths are microseconds. Eighteen entries occupy 368 bytes including header and CRC. An empty record occupies eight bytes. Flash-slot padding is outside the format and must not be passed to `decode()`.

## API and validation

`encode()` accepts an array of optional calibrations and an output byte slice. Array indices are Servo IDs. It writes present entries in ascending ID order and returns the encoded length; bytes beyond that length remain unchanged. Payloads exceeding the 16-bit length field and insufficient output space are rejected.

`decode()` accepts one exact record and returns an array of optional calibrations. Input entry order is arbitrary. It checks identifier/version, exact length, entry-size divisibility, CRC, unknown and duplicate IDs, and each entry through `Calibration::new()`. No partial result is returned on failure.

`None` means an absent or invalidated calibration. A partial or empty configuration is a valid storage record, but does not authorize robot operation. The later startup layer must require every configured servo to have a valid calibration. Format validation does not establish physical joint limits or compatibility with a particular signal backend.

## Checksum interface

`Checksum` allows interchangeable implementations. Each call starts a complete independent CRC-32/ISO-HDLC calculation: polynomial `0x04C11DB7`, initial value `0xFFFFFFFF`, reflected input/output, final XOR `0xFFFFFFFF`. The stored result is little endian. `SoftwareCrc32` is provided; a Pico hardware adapter is not yet implemented.

## Journal slot representation

`encode_slot()` and `decode_slot()` wrap the existing calibration record in a fixed 512-byte slot. All multibyte fields remain little endian and are serialized explicitly, without Rust structure padding.

| Offset | Field | Size |
| --- | --- | --- |
| 0 | Journal identifier/version: `4A 01` hexadecimal | 2 bytes |
| 2 | Length of embedded calibration record, including its header and CRC | 2 bytes, `u16` |
| 4 | Sequence number | 8 bytes, `u64` |
| 12 | Embedded calibration record | Variable |
| 12 + embedded length | Journal CRC over journal header and embedded record | 4 bytes |
| After journal CRC | Padding | Remaining bytes |

Eighteen calibrations occupy 384 bytes including both envelopes and CRCs. The maximum embedded record length is 496 bytes. The outer CRC protects the sequence number as well as the complete inner record; the inner format remains independently usable.

`encode_slot()` builds a local candidate, fills unused bytes with `0xFF`, and leaves the caller's buffer unchanged on error. `decode_slot()` reports a completely erased slot as `SlotError::Empty`. Other slots must pass identifier, length, outer CRC and inner-record validation. Padding is ignored when decoding; that does not make a partially programmed slot free for reuse.

`JournalRecord` returns the sequence and optional calibrations. An empty or partial calibration record remains valid journal content, so a later reader must not resurrect an older complete configuration after intentional invalidation. The slot codec can represent `u64::MAX`; the journal writer rejects sequence wraparound.

These functions encode and validate bytes only. They neither program flash pages nor establish an atomic write-completion mechanism. Newest-record selection and duplicate-sequence detection are implemented below. Slot selection and sector switching are implemented by the storage-independent writer below; actual flash operations remain future work.

## Journal search

`find_latest()` accepts a slice of fixed-size slot images and returns `Result<Option<LocatedRecord<N>>, ScanError>`. It examines all supplied slots and selects the valid record with the highest sequence number, regardless of physical address or sector. `LocatedRecord` includes the slot index and decoded record. Slot images are read-only; no storage driver is involved.

Erased and invalid slots are skipped. No valid record returns `Ok(None)`, which must not authorize normal operation. A found record returns `Ok(Some(...))`; the later startup layer still needs to require every configured calibration to be present. A newer empty or partial configuration remains authoritative and must not be replaced by an older complete one.

Any duplicate sequence number among valid records returns `ScanError::DuplicateSequence`, including duplicates older than the newest record. Invalid records do not participate in duplicate detection. `u64::MAX` can be selected without incrementing it; the writer rejects further appends after that sequence.

The current search re-decodes previous slots for duplicate detection rather than allocating a sequence-number table. Its work is quadratic in the slot count; the planned journal has only sixteen slots. CRC adapters must start an independent computation on every call.

Host tests cover both sector/address orders, missing and invalid records, duplicate sequences, partial/empty invalidation, corrupted sequence numbers, invalid inner records, maximum sequence and a simulated incomplete header write. Write-management tests below simulate selected interrupted operations. Actual interrupted flash-program/erase recovery still requires hardware checks.

## Journal storage and append

`JournalRead` provides complete-slot reading. `JournalStorage: JournalRead` adds programming an erased slot and erasing one sector; read-only backends need not expose writes. Geometry is two sectors with eight 512-byte slots each. Backend errors may leave a slot partially programmed or a sector partially erased. The real backend is responsible for the platform execution conditions; this trait alone does not make flash writes safe.

`append()` reads all sixteen slots before selecting a destination. A read error aborts the operation; it is not treated as an invalid record. The newest valid record determines the active sector and next sequence. With no valid record, initialization uses sector0 and sequence1; no claim of globally unique numbering after complete data loss is made. Duplicate valid sequences and sequence overflow prevent writes. The candidate is encoded before any erase/program call, so an oversized record cannot trigger a sector erase.

Within the active sector, the writer chooses the slot after the last occupied slot. Any byte other than `0xFF`, including padding-only changes, marks a slot occupied. Erased holes before the last occupied slot are not reused. If the active sector is full, the writer switches to the other sector and erases it only if it is not completely erased. The sector containing the latest valid record is retained; it is only reclaimed when a later switch needs it.

After programming, the writer reads back and compares all 512 bytes, including padding, against the encoded candidate. Only an exact match returns `LocatedRecord`. Read/write/erase errors are returned as `JournalError::Storage`; a mismatch returns `VerificationFailed`. Every retry starts from a fresh storage scan, so a partial failed write is not blindly overwritten. An error is not a rollback guarantee: a complete record may already be present if writing succeeded but readback failed. Future UART/service callers must treat that outcome as uncertain and reload before assuming which state is durable.

The implementation currently holds an 8-KiB journal image plus two 512-byte buffers in `append()`. Nested encoding and decoding use additional stack space; this is not a measured total stack bound. Embedded stack use must be reviewed before Pico integration.

The sixteen writer tests cover first append, sequence progression, occupied-slot skipping, active-sector selection, partial invalidation, both sector-switch directions, avoiding unnecessary erases, duplicate/overflow rejection, scan/readback errors, a partial write and retry, a partial erase failure, full-buffer readback mismatch including padding, oversized records and the final available sequence. These are simulations, not an exhaustive power-loss campaign or hardware verification. Startup/service-mode enforcement and Pico multicore/interrupt/DMA coordination are not implemented here. The Pico linker reservation is documented below.

## Save only changed calibrations

`save_if_changed()` loads the newest valid record and compares its decoded calibration array with the requested values. Identical data returns that LocatedRecord without writing, erasing or advancing the sequence, including at u64::MAX and when both sectors are full. A matching older record is insufficient if the newest record differs.

Changed or absent data delegates to `append()`, preserving its rotation, error handling and readback verification. `append()` continues to explicitly create a new record even for equal values. Read/scan failures abort `save_if_changed()` without modification. The equality path still reads storage; it avoids flash programming and erasure, not reads. For changed data, the current wrapper reads once through load and again inside append; no concurrent journal writer is supported.

On 2026-11-04 the owner reported all ten new save-if-changed host tests passing and full local verification with **499 tests and all 17 checks passing**. These tests inspect returned slot/sequence, unchanged slot bytes and the absence of write/erase calls for identical data. The register package now connects this function to FrameProcessor through its host-tested persistence coordinator; physical UART/flash retry behavior remains future work. CI for this step has not yet been reported.

## Verification and remaining work

On 2026-10-28 the owner reported 66 passing storage tests: five CRC/adapter tests, eighteen calibration-format tests, thirteen journal-slot tests, fourteen journal-search tests and sixteen writer tests. The full local runner subsequently reported 238 passing tests and all 13 checks passing. Envelope fixtures are constructed independently of the corresponding envelope encoder. The owner subsequently reported green CI for the combined search/write-management revision. These results describe the journal-management revision. The subsequent read-only Pico integration is recorded below; embedded writes and erases remain unimplemented.

From the repository root:

```bash
cargo fmt --manifest-path firmware/servo-storage/Cargo.toml
cargo test --manifest-path firmware/servo-storage/Cargo.toml --lib --locked
```

Next steps are additional recovery scenarios as needed and a separate Pico flash driver. The Pico linker now reserves two 4-KiB sectors with eight 512-byte slots each; a read-only Pico backend is available; flash programming and erase are not implemented. Service access, persistent invalidation and boot-mode enforcement are not implemented by this library.

## Pico flash reservation

The Pico [memory.x](../apps/servo-controller/memory.x) reserves the final 8 KiB of its 2-MiB flash for the journal. Firmware FLASH length excludes that region; the existing 256-byte BOOT2 area is unchanged.

| Region | Memory-mapped address | Flash-relative offset | Size |
| --- | --- | --- | --- |
| Journal sector0 | `0x101FE000` | `0x001FE000` | 4096 bytes |
| Journal sector1 | `0x101FF000` | `0x001FF000` | 4096 bytes |
| Journal end, exclusive | `0x10200000` | `0x00200000` | - |

Linker symbols `__calibration_start` and `__calibration_end` expose these boundaries. Assertions check adjacency to firmware, 4-KiB start alignment, two-sector size and the end of flash. No initialized data section is assigned to CALIBRATION. This reserves space against firmware growth at link time; it does not prevent a full-chip erase, programming other firmware, or explicit writes to those addresses.

On 2026-10-28 the owner reported 238 passing tests and all 13 checks passing after the linker change, including the Pico build. Read-only inspection of that debug ELF confirmed both boundary symbols and no load-image or runtime segment overlapping the journal. The highest flash load-image end was `0x10015C50` (exclusive); this is a build-specific observation, not a fixed firmware size. No UF2 upload, persistence check or flash operation was performed for this reservation. The owner subsequently reported green CI for the reservation change.

## Read-only loading and Pico integration

`load()` requires only `JournalRead`, reads all sixteen slots and calls `find_latest()`. A storage read error aborts loading instead of returning an earlier record. Six host tests cover a read-only backend, absent records, latest-record selection, intentional invalidation, corrupt records, duplicate sequences and a read failure after an earlier valid record.

The Pico [FlashJournalReader](../apps/servo-controller/src/flash_journal.rs) obtains addresses from the linker symbols, checks region size/alignment and flash bounds, rejects invalid slot indices, and copies each slot into caller-owned RAM. It implements `JournalRead` only. Its unsafe constructor requires normal readable 2-MiB XIP flash and no flash programming/erase or XIP reconfiguration by any core or handler for the reader's entire lifetime. Address checks do not establish synchronization; a future writer must account for the reader's lifetime.

The standalone [flash_journal_read hardware test](../apps/servo-controller/hardware_tests/flash_journal_read.rs) loads for eighteen configured servos using SoftwareCrc32, checks rejection of index SLOT_COUNT, and reports one result through UART1. It starts no servo output and performs no flash programming or erase. The normal fixed-plan demo is unchanged.

On 2026-10-28 the owner reported 72 passing storage tests, successful hardware-test execution with `INFO Journal read OK: no valid record`, and a full local verification of 244 passing tests and all 13 checks passing. The message confirms completed reading/search with no accepted record; it does not prove that all bytes are erased. LED state was not separately reported. The owner subsequently reported green CI for the read-only integration. Loading a known valid flash record, physical read-error handling, persistence, writes and erases have not been hardware-tested.

## Preparation for embedded writes

The separate [RAM-execution hardware probe](../apps/servo-controller/hardware_tests/README.md#ram-routine-probe) was verified on 2026-10-29 by ELF inspection and the owner-observed `INFO RAM routine OK`. The full local runner remained at 244 passing tests and 13/13 checks passing. This preparation does not implement JournalStorage on the Pico: XIP remained enabled, and no flash was erased or programmed. The subsequent standalone no-write XIP transition is recorded below. Embedded storage writes, general runtime exclusion and persistence tests remain to be implemented and checked.

The [XIP transition test](../apps/servo-controller/hardware_tests/README.md#xip-exit-and-restoration-test) subsequently passed on 2026-10-29 with owner-observed `INFO XIP cycle OK`, 244 passing tests and 13/13 local checks. The test prepares all ROM pointers and its Boot2 RAM copy before leaving XIP, restores XIP before returning, and checks a mapped flash word afterward. No flash programming/erase occurred and JournalStorage is still not implemented on the Pico. Multicore/DMA exclusion is a standalone-test condition, not an implemented service-mode policy. The owner subsequently reported green CI for the XIP-transition revision.

## Checked journal geometry

`JournalLayout` validates a sector-aligned journal start and the complete journal extent against a storage-device size, using checked addition to reject address overflow. It returns `StorageRange` values for complete slots and sectors. Constants derive a 4096-byte SECTOR_SIZE and 8192-byte JOURNAL_SIZE from the existing geometry. Offsets are relative to the storage device, not memory-mapped XIP addresses. A valid layout does not by itself prove a linker reservation or grant exclusive access.

`slot_range()` and `sector_range()` reject out-of-range indices before multiplication, including usize::MAX. Every returned slot is exactly 512 bytes and every returned sector exactly 4096 bytes. The constructor's checked region end bounds all valid index calculations. Ten host tests cover aligned regions, exact-end acceptance, misalignment, insufficient storage, region-end overflow, first/last slots and sectors, and invalid indices.

The Pico reader now constructs JournalLayout from the validated linker region and uses slot_range for reads. Only the Pico layer adds XIP base `0x10000000`; the layout retains flash-relative offsets. The existing UnknownSlot error contract and read-only lifetime restrictions are unchanged.

On 2026-10-29 the owner reported 82 passing storage tests, then 254 passing tests and all 13 checks passing in the full local runner. The rebuilt flash_journal_read program again produced `INFO Journal read OK: no valid record`. This confirms the integrated read path with checked geometry; no flash program/erase or persistent-write test was performed. The owner subsequently reported green CI for this geometry/reader revision.

## Pico slot programming preparation

The separate [flash_program_slot hardware test](../apps/servo-controller/hardware_tests/README.md#journal-slot-programming-test) now exercises a RAM-resident ROM programming sequence for one erased 512-byte slot in the reserved journal. The test checks the linker bounds, erased target, RAM buffers and function-pointer addresses before disabling XIP, then compares all 512 bytes after restoration. Its test pattern is not a valid journal record. No erase operation or Pico JournalStorage writer is implemented yet.

On 2026-10-29, the owner observed `INFO Journal slot program OK` and, after a restart, `ERROR Journal slot 0 is not erased`. This verifies one complete immediate readback and rejection of repeat programming after reset. It does not verify a valid calibration record across reset, sector erasure, interrupted programming, or safe integration with running IRQ/core1/DMA users. The owner reported 254 passing tests and all 13 checks passing; The owner subsequently reported green CI for this programming revision. The preceding geometry/reader revision passed CI.

## Pico sector erase preparation

The [flash_erase_sector hardware test](../apps/servo-controller/hardware_tests/README.md#journal-sector-erase-test) now exercises a RAM-resident ROM erase of reserved sector 0. It validates the target, skips already-erased sectors, restores XIP, checks all 4096 erased bytes and compares sector 1 against a complete RAM snapshot. It is explicitly destructive to sector 0 and is separate from the journal's automatic sector selection.

On 2026-10-29 the owner observed `INFO Journal sector erase OK` followed by `ERROR Journal sector 0 is already erased` after restart, and reported 269 passing tests, all 13 verification checks and all 33 hardware-build checks passing. Map/disassembly review confirmed the RAM-only wrapper with five prepared indirect calls. A Pico JournalStorage backend, valid-record persistence across restart, interrupted-write/erase recovery and runtime exclusion remain unimplemented or unverified. CI for this erase revision is pending.

## Pico JournalStorage backend

[FlashJournalStorage](../apps/servo-controller/src/flash_journal_storage.rs) now implements JournalRead and JournalStorage for the two reserved Pico sectors. JournalLayout and linker checks bound access. write_slot delegates to program_slot, which rejects flash/non-RAM sources, checks the entire slot is erased, prepares ROM pointers and a RAM Boot2 copy, programs under masked normal interrupts, and verifies all bytes after XIP restoration. It uses the existing source buffer without a second 512-byte payload copy. erase_sector delegates to a bounded, verified sector erase; an already-erased sector succeeds without another erase. Sector selection, records, CRC and sequence management remain in the storage-independent journal.

The unsafe constructor's lifetime/execution contract must be upheld by the application. FlashJournalReader cannot coexist with this backend. Its read path needs no RAM-resident code because XIP stays active. Write/erase critical routines execute in RAM/ROM. Safe runtime coordination with another core, active DMA or unmasked exception flash access is not implemented by this backend.

The [backend hardware procedures](../apps/servo-controller/hardware_tests/README.md#flashjournalstorage-backend-tests) record successful reading, programming/rejection and erase tests on 2026-10-30. The owner reported 275 passing tests, all 13 verification checks and all 37 hardware-build checks passing. These tests use raw patterns, not valid persisted calibration records; end-to-end append/load, journal rotation and failure recovery on real flash are still pending. The owner subsequently reported green CI for this backend revision.

## Valid-record persistence on Pico

The [flash_journal_persistence procedure](../apps/servo-controller/hardware_tests/README.md#journal-persistence-test) now exercises append and load through FlashJournalStorage with a complete synthetic eighteen-servo fixture. On 2026-10-30 the owner received `INFO Journal persistence OK: record written`, then `INFO Journal persistence OK: existing record` after an orderly restart without another upload. The test verifies sequence 1 and every calibration; the initial reload also verifies the located slot. When the expected valid record exists it does not write again, and an unexpected valid record aborts without modification.

The owner reported 275 passing tests, all 13 verification checks and all 39 hardware-build checks passing. This verifies normal end-to-end persistence and successful CRC validation, not hardware corruption injection, sector rotation, interrupted programming/erase or power-loss recovery. Normal firmware startup and service-mode enforcement remain separate integration work. The owner subsequently reported green CI for this persistence revision. The preceding backend revision was reported green in CI.

## Sector rotation on Pico

The [flash_journal_rotation procedure](../apps/servo-controller/hardware_tests/README.md#journal-rotation-test) now exercises twenty-five append/load operations through the Pico backend. At switches 9, 17 and 25 it verifies that the previous sector is unchanged and unused slots in the new target sector are erased. Reclaiming old records is exercised in both directions at 17 and 25. Sequence, located slot and all eighteen calibration values are checked after each append/reload.

On 2026-10-30 the owner observed `INFO Journal rotation OK: sequence 25 written`, followed by `INFO Journal rotation OK: existing sequence 25` after restart without another upload. The second path performs no writes. The owner reported 275 passing tests, all 13 verification checks and all 41 hardware-build checks passing. Test preparation deliberately clears both sectors, accepting only the known initial fixture or no valid record; unexpected valid records abort unchanged. This confirms normal rotation and restart persistence, not interrupted-operation or power-loss recovery. CI for this rotation revision is pending. The preceding persistence revision passed CI.

The rotation hardware test also reports sequence, sector and sector-local slot before each append and after verification. Its test-only automatic restart cycle verifies sequence 25 and appends marker 26, then prepares both sectors and reruns rotation on the following startup. The owner confirmed this behavior on 2026-10-30 and again reported 275 passing tests, all 13 verification checks and all 41 hardware-build checks passing. See the hardware-test guide for the current startup procedure. No manual repeat flag remains. CI for this combined rotation/progress/repeat revision is pending.

The owner subsequently confirmed the register-layer persistence coordinator with eight integration tests and full local verification of 515 tests and all 17 checks on 2026-11-04. It calls save_if_changed() only after response-buffer readiness and reports the result to the register service. These simulated integration results do not replace the later combined UART/flash hardware test.
