ebe542/hexaroam/hardware/ATTRIBUTION.md

# Hardware attribution

Initial mechanical reference: https://github.com/ggldnl/Hexapod-Hardware

Upstream license: CERN-OHL-W-2.0. No upstream Hexapod design files are included yet.

For each imported set, record the upstream commit, original paths, license files and notices, import date, and local modifications. Preserve applicable upstream licensing when distributing derived hardware files.

## Raspberry Pi documentation

The unmodified Pico and RP2040 reference PDFs are licensed under CC BY-ND 4.0, separately from HexaRoam's MIT License. See the [reference inventory](references/README.md) for copyright attribution, official sources, versions, and checksums.
