ebe542/hexaroam/docs/architecture/interfaces.md

# Traits and implementations

[Architecture maps](README.md) · [Software layers](software-layers.md)

Generic parameters are omitted from the diagrams for readability. A dashed triangle arrow points from an implementation to its trait. A labelled dashed arrow means a consumer uses a trait. The tables link to the exact definitions; test doubles and ordinary derived traits such as Debug are omitted.

## Multi-servo command path

```mermaid
classDiagram
    class PulseBankOutput {
        <<trait>>
        submit_pulses()
        service()
    }
    class SignalPlanOutput {
        <<trait>>
        submit_plan()
        service()
    }
    class ServoBank
    class ServoSignalOutput
    class SwitchingOutput
    PulseBankOutput <|.. ServoSignalOutput
    SignalPlanOutput <|.. SwitchingOutput
    ServoBank ..> PulseBankOutput : uses
    ServoSignalOutput ..> SignalPlanOutput : uses
```

| Trait | Defined in | Concrete implementation | Consumer |
| --- | --- | --- | --- |
| PulseBankOutput | [servo-control/servo_bank.rs](../../firmware/servo-control/src/servo_bank.rs) | [ServoSignalOutput](../../firmware/servo-control/src/servo_signal_output.rs) | ServoBank |
| SignalPlanOutput | [servo-signal/signal_plan_output.rs](../../firmware/servo-signal/src/signal_plan_output.rs) | [SwitchingOutput](../../firmware/servo-pio/src/switching_output.rs) | ServoSignalOutput |

PulseBankOutput receives a complete slice of pulse widths in ServoId order. SignalPlanOutput receives a reference to a complete SignalPlan. These contracts distinguish angle control from GPIO mapping and the hardware backend. FixedOutput has inherent start/service behavior but does not implement SignalPlanOutput. PreparedOutput prepares hardware resources; it is not another trait implementation in this chain.

## Storage and CRC

```mermaid
classDiagram
    class JournalRead {
        <<trait>>
        read_slot()
    }
    class JournalStorage {
        <<trait>>
        write_slot()
        erase_sector()
    }
    class Checksum {
        <<trait>>
        checksum()
    }
    class FlashJournalReader
    class FlashJournalStorage
    class SoftwareCrc32
    JournalRead <|-- JournalStorage : extends
    JournalRead <|.. FlashJournalReader
    JournalRead <|.. FlashJournalStorage
    JournalStorage <|.. FlashJournalStorage
    Checksum <|.. SoftwareCrc32
```

| Contract | Implementation and use | Source |
| --- | --- | --- |
| JournalRead | FlashJournalReader and FlashJournalStorage implement reading; load consumes a JournalRead backend | [storage.rs](../../firmware/servo-storage/src/storage.rs), [flash_journal.rs](../../firmware/apps/servo-controller/src/flash_journal.rs), [journal.rs](../../firmware/servo-storage/src/journal.rs) |
| JournalStorage extends JournalRead | FlashJournalStorage implements the Pico backend; append consumes this contract | [storage.rs](../../firmware/servo-storage/src/storage.rs), [flash_journal_storage.rs](../../firmware/apps/servo-controller/src/flash_journal_storage.rs), [journal.rs](../../firmware/servo-storage/src/journal.rs) |
| Checksum | SoftwareCrc32 implements independent CRC-32/ISO-HDLC calculations; format, slots and journal operations accept the abstraction | [crc32.rs](../../firmware/servo-storage/src/crc32.rs), [format.rs](../../firmware/servo-storage/src/format.rs), [journal_slot.rs](../../firmware/servo-storage/src/journal_slot.rs) |

The RAM programming/erase functions are unsafe free functions. They do not implement JournalStorage themselves; FlashJournalStorage implements the trait and invokes them after validation. JournalLayout is a concrete geometry helper, not a storage trait. A Pico hardware CRC implementation is not present.

## Logging and panic output

```mermaid
classDiagram
    class ByteOutput {
        <<trait>>
        try_write()
    }
    class Logger
    class BoundedWriter
    class UartLogOutput
    class PanicUartOutput
    ByteOutput <|.. UartLogOutput
    ByteOutput <|.. PanicUartOutput
    Logger ..> ByteOutput : uses
    BoundedWriter ..> ByteOutput : uses
```

| Contract or type | Role | Source |
| --- | --- | --- |
| ByteOutput | Immediately returns accepted/full/error for a byte | [logging/lib.rs](../../firmware/logging/src/lib.rs) |
| UartLogOutput implements ByteOutput | Pico UART backend for the normal buffered Logger path | [uart_logging.rs](../../firmware/apps/servo-controller/src/uart_logging.rs) |
| PanicUartOutput implements ByteOutput | Private direct UART backend used by the panic handler | [panic_uart.rs](../../firmware/apps/servo-controller/src/panic_uart.rs) |
| BoundedWriter implements core::fmt::Write | Formats diagnostic text with a bounded byte-output attempt budget | [bounded_writer.rs](../../firmware/logging/src/bounded_writer.rs) |

Logger queues whole messages and drains them through `service(byte_budget)`. Panic formatting uses a separate bounded direct-output path rather than relying on the application loop. The ByteOutput contract itself is nonblocking in both cases. Several isolated flash tests deliberately use panic_halt instead of the UART panic handler.

## Earlier single-servo path

```mermaid
classDiagram
    class ServoChannel {
        <<trait>>
    }
    class PulseOutput {
        <<trait>>
    }
    class PulseTransport {
        <<trait>>
    }
    class Servo
    class ServoPio
    class PioTransport
    ServoChannel <|.. Servo
    PulseOutput <|.. ServoPio
    PulseTransport <|.. PioTransport
    Servo ..> PulseOutput : uses
    ServoPio --> PioTransport : owns
```

[Servo and its traits](../../firmware/servo-control/src/servo.rs) remain in servo-control. The earlier [ServoPio/PioTransport driver](../../firmware/apps/servo-controller/src/drivers/servo_pio.rs) implements PulseOutput and PulseTransport respectively, using [submit_pulse](../../firmware/servo-signal/src/lib.rs). That driver file is retained in the repository but is not included by the current Pico main module tree. This is a historical single-output path, not the current multi-servo DMA backend. ServoBank does not contain a collection of Servo objects; it owns its own calibrations and a PulseBankOutput backend.

## HAL boundary

The private [SignalPlanDmaSource](../../firmware/servo-pio/src/signal_plan_dma_source.rs) implements the HAL's unsafe ReadTarget trait for a checked range in an owned static buffer. The transfer owns this source until completion or confirmed abort. This external trait boundary supports DMA memory safety; it is not an application command interface. Hardware types in servo-pio are compiled for ARM bare-metal targets, which is why the combined Rustdoc task selects thumbv6m-none-eabi.

## Register-service output backend

```mermaid
classDiagram
    class OutputBackend {
        <<trait>>
        start()
        stop()
        state()
        target(id)
        set_targets(targets)
    }
    class FakeOutput
    class ControlRegister
    class RegisterService
    class ServoBank
    OutputBackend <|.. FakeOutput
    OutputBackend <|.. ServoBank
    ControlRegister ..> OutputBackend : uses
    RegisterService --> ControlRegister : owns
```

[OutputBackend](../../firmware/servo-registers/src/output.rs) is the application-level start/stop/state and target-access contract consumed by [ControlRegister](../../firmware/servo-registers/src/control.rs). The shared [FakeOutput](../../firmware/servo-registers/src/test_support.rs) implements it in tests, and [servo_bank_backend.rs](../../firmware/servo-registers/src/servo_bank_backend.rs) implements it directly for lifecycle-capable ServoBank backends. It must report reliable Active/Inactive state after errors; invalid initial targets must leave output unchanged. ServoBank implements this trait without an additional wrapper; FixedOutput and SwitchingOutput remain lower-level drivers. [RegisterService](../../firmware/servo-registers/src/service.rs) owns ControlRegister and maps it to Control/Status and consecutive target-angle registers, returning ACK/NACK with the original register index. LastError was removed in protocol version 2. Target values use the existing Angle, ServoId and ServoTarget types from servo-control. Reads return backend-owned accepted targets; batch writes must preserve them on failure. Inactive writes prepare targets, while active writes submit them for later signal-plan activation. These host-tested types are not wired into the normal Pico binary.

## Optional signal-plan lifecycle

```mermaid
classDiagram
    class SignalPlanOutput {
        <<trait>>
        submit_plan()
        service()
    }
    class SignalPlanLifecycle {
        <<trait>>
        start_plan()
        stop()
        state()
    }
    class ServoSignalOutput {
        start_pulses()
        stop()
        state()
    }
    class SwitchingOutput
    SignalPlanOutput <|-- SignalPlanLifecycle : extends
    SignalPlanLifecycle <|.. SwitchingOutput
    ServoSignalOutput ..> SignalPlanLifecycle : optional backend bound
```

[SignalPlanLifecycle](../../firmware/servo-signal/src/signal_plan_lifecycle.rs) is an optional extension with a separate LifecycleError. [ServoSignalOutput](../../firmware/servo-control/src/servo_signal_output.rs) exposes lifecycle methods only for matching backends, sharing complete plan validation with ordinary submission. State is delegated rather than duplicated. SwitchingOutput now implements this extension with regular start after confirmed stop, bounded DMA shutdown and a separate OutputLifecycleError. Ordinary start rejects latched faults; explicit fault recovery remains separate. The owner confirmed the regular stop/start hardware procedures on 2026-11-01. PulseBankOutput and the register-service OutputBackend remain separate contracts, connected by the direct ServoBank implementation below.

## ServoBank lifecycle bridge

```mermaid
classDiagram
    class PulseBankOutput {
        <<trait>>
    }
    class PulseBankLifecycle {
        <<trait>>
        start_pulses()
        stop()
        state()
    }
    class ServoBank {
        start_prepared()
        stop()
        state()
    }
    class ServoSignalOutput
    class SignalPlanLifecycle {
        <<trait>>
    }
    class SwitchingOutput
    PulseBankOutput <|-- PulseBankLifecycle : extends
    PulseBankLifecycle <|.. ServoSignalOutput
    ServoBank ..> PulseBankLifecycle : optional backend bound
    ServoSignalOutput ..> SignalPlanLifecycle : uses
    SignalPlanLifecycle <|.. SwitchingOutput
```

[PulseBankLifecycle](../../firmware/servo-control/src/servo_bank.rs) connects complete calibrated startup batches to the lower signal-plan lifecycle. ServoBank validates all prepared targets before starting, preserves them on stop and delegates state without caching it. [ServoSignalOutput](../../firmware/servo-control/src/servo_signal_output.rs) implements the trait for lifecycle-capable signal-plan backends. Startup and stop retain a separate lifecycle error type; stop errors are wrapped at this trait boundary. ServoBank now also implements the register-service OutputBackend directly. The bank-to-PIO lifecycle hardware test was accepted separately; the path from the register service to real PIO remains unverified.

## Register-service bank ownership

RegisterService owns ControlRegister, which owns its OutputBackend. With ServoBank as that backend, target reads and writes use the existing bank storage and validation; stopped writes prepare targets and active writes submit complete batches. RegisterService::service forwards through every owner to the underlying output service. ServoBankBackendError distinguishes lifecycle failures from submission failures. No additional output state is cached, and uninitialized targets are reported as InvalidState rather than a technical Fault. The current PC tests use a recording pulse backend. UART, journal-driven calibration and asynchronous fault reporting remain separate integration work.

## Protocol byte transport

```mermaid
classDiagram
    class ByteTransport {
        <<trait>>
        try_read()
        try_write()
    }
    class ResponseBuffer {
        queue()
        service()
        remaining()
    }
    class UartTransport
    ResponseBuffer ..> ByteTransport : bounded transmit only
    ByteTransport <|.. UartTransport
```

[ByteTransport](../../firmware/servo-protocol/src/transport.rs) defines nonblocking byte operations. [ResponseBuffer](../../firmware/servo-protocol/src/response_buffer.rs) owns one copied encoded response and uses try_write to service its unsent suffix with a byte budget. It does not read, parse frames or access the register service. [UartTransport](../../firmware/apps/servo-controller/src/uart_transport.rs) now implements it over an exclusively owned, enabled HAL UART; UART0 loopback was confirmed on hardware. FrameProcessor integration with that UART is verified by the no-servo UART register hardware suite; normal-application integration remains pending. This is independent of the logging ByteOutput contract, whose message-drop policy is not used for protocol responses.

## Frame-processing ownership

```mermaid
classDiagram
    class FrameProcessor {
        poll()
        on_receive_timeout()
    }
    class RegisterService
    class StreamParser
    class ResponseBuffer
    class ByteTransport {
        <<trait>>
    }
    FrameProcessor --> RegisterService : owns and services
    FrameProcessor --> StreamParser : owns
    FrameProcessor --> ResponseBuffer : owns
    FrameProcessor ..> ByteTransport : borrowed per poll
```

[FrameProcessor](../../firmware/servo-registers/src/frame_processor.rs) coordinates the existing contracts without owning UART hardware. It services the register backend on every poll, transmits pending response bytes and processes requests only when response storage is available. Deferred receive timeouts preserve complete buffered requests. PC tests use a simulated transport and register backend. The uart_registers hardware example now connects the concrete Pico UART to FrameProcessor and RegisterService with a no-servo test backend; the owner verified all 21 version-2 UART scenarios on 2026-11-03, including ACK/NACK and discarded-header behavior.

UartTransport maps empty receive FIFO and full transmit FIFO to nonblocking results. It exposes Overrun, Break, Parity and Framing as receive errors instead of delivering the faulty entry to the parser. The application remains responsible for deciding how to recover an incomplete frame after such errors. The current hardware test does not inject these errors.

## Medium-independent calibration storage and EEPROM access

| Contract | Current implementation / role | Source |
| --- | --- | --- |
| `CalibrationRead<N>` | EepromCalibrationReader implements complete validated loading; an intact but incomplete newest record returns an error instead of falling back. | [calibration_storage.rs](../../firmware/servo-storage/src/calibration_storage.rs) |
| `CalibrationStorage<N>: CalibrationRead<N>` | EepromCalibrationStorage implements the station-side save contract with unchanged-data suppression and verified bounded rotation. | [calibration_storage.rs](../../firmware/servo-storage/src/calibration_storage.rs) |
| `embedded_hal::i2c::I2c` | Bus supplied to `Eeprom<I>`; no concrete Pico I2C integration yet. | [EEPROM driver](../../firmware/eeprom/src/lib.rs) |
| `embedded_hal::delay::DelayNs` | Caller-supplied delays between write-readiness retries. | [EEPROM driver](../../firmware/eeprom/src/lib.rs) |

The EEPROM driver accesses bytes, not calibration objects or journal slots. SlotLayout, scan_calibrations and load_calibrations provide checked addressing and incremental validation/selection. plan_calibration_write, write_calibration_slot and save_calibrations provide bounded verified persistence through SlotWrite. Existing flash-oriented JournalRead/JournalStorage contracts remain separate. The operating robot reads calibration only at startup; a separate station writes the detached EEPROM. See the [driver guide](../../firmware/eeprom/README.md) and [storage contracts](../../firmware/servo-storage/README.md#medium-independent-calibration-storage).

The [EEPROM reader adapter](../../firmware/servo-eeprom/README.md) owns an Eeprom and checksum implementation. Its internal EepromSlots implements JournalRead using SlotLayout; its public EepromCalibrationReader implements CalibrationRead by delegating to load_calibrations. The default is 64 slots of 512 bytes, starting at address zero. No additional validity flag was introduced.

EepromSlotWriter implements JournalRead and SlotWrite with an owned DelayNs implementation. EepromCalibrationStorage owns this writer and checksum and implements both CalibrationRead and CalibrationStorage for the separate station. Its load/save errors retain the shared algorithm errors and underlying device errors. The controller retains its read-only type. No runtime calibration protocol command was added.

The owner reported 837 passing tests and all 21 local verification checks passing, including 186 storage and 46 adapter tests. Hardware EEPROM access, boot integration and the station application remain pending. CI was green for the preceding reader revision; CI for this writer revision is pending.
