ebe542/hexaroam/docs/architecture/software-layers.md

# Software layers

[Architecture maps](README.md) · [Traits and implementations](interfaces.md)

## Angle command to servo signal

This path is implemented and exercised by the separate [servo_bank_angles hardware test](../../firmware/apps/servo-controller/hardware_tests/servo_bank_angles.rs). Its calibrations are synthetic; the signal test does not establish measured servo positions. The normal firmware follows the shorter fixed-plan path below.

```mermaid
flowchart TD
    Test["Hardware-test application: servo_bank_angles"]
    subgraph Control["servo-control: hardware-independent angle control"]
        Bank["ServoBank: validate the complete request"]
        Calibration["Calibration: Angle to pulse width"]
        Adapter["ServoSignalOutput: servo order to GPIO mapping"]
    end
    subgraph Signal["servo-signal: hardware-independent signal description"]
        Plan["SignalPlan: GPIO masks and interval durations"]
    end
    subgraph Backend["servo-pio: RP2040 output backend"]
        Switching["SwitchingOutput: accept and switch whole plans"]
        Encoding["PIO-specific encoding and owned RAM buffers"]
        DMA["DMA: transfer plan words to TX FIFO"]
        PIO["One PIO state machine: execute GPIO timing"]
    end
    Pins["Configured GPIOs: servo command signals"]
    Test -->|"ServoTarget slice: ID and Angle"| Bank
    Bank --> Calibration
    Calibration -->|"complete pulse-width batch"| Adapter
    Adapter --> Plan
    Plan -->|"SignalPlanOutput contract"| Switching
    Switching --> Encoding
    Encoding --> DMA
    DMA --> PIO
    PIO --> Pins
```

| Responsibility | Owner | Source |
| --- | --- | --- |
| Integer angle representation, in hundredths of a degree | Angle | [angle.rs](../../firmware/servo-control/src/angle.rs) |
| Two-point angle-to-pulse conversion and angle bounds | Calibration | [calibration.rs](../../firmware/servo-control/src/calibration.rs) |
| Servo IDs, complete-request validation, retained accepted targets | ServoBank | [servo_bank.rs](../../firmware/servo-control/src/servo_bank.rs) |
| GPIO assignment, signal limits and frame period | ServoSignalOutput | [servo_signal_output.rs](../../firmware/servo-control/src/servo_signal_output.rs) |
| Generic GPIO masks and durations, independent of PIO instructions | SignalPlan | [signal_plan.rs](../../firmware/servo-signal/src/signal_plan.rs) |
| PIO counter encoding and buffer representation | servo-pio internals | [encoding.rs](../../firmware/servo-pio/src/encoding.rs), [buffer.rs](../../firmware/servo-pio/src/buffer.rs) |
| Pending plan, DMA ownership, frame handover and persistent fault | SwitchingOutput | [switching_output.rs](../../firmware/servo-pio/src/switching_output.rs) |
| PIO assembly and timing | PIO program | [program.rs](../../firmware/servo-pio/src/program.rs) |

A nonempty ServoBank::set_targets request must produce a complete candidate, combining requested values with previously prepared or submitted targets. Without preparation, the first nonempty request must initialize every configured servo. prepare_targets allows incremental initialization without output; its caller must ensure output is inactive. submit_prepared converts and submits the complete stored target set without changing it. set_targets validates the whole candidate and commits it only if the backend accepts the complete pulse batch. These are software acceptance records, not position feedback or proof that a frame has already been activated.

The application must keep calling `bank.service()`. It delegates through ServoSignalOutput to SwitchingOutput; PIO provides timing while CPU servicing manages transfers and plan replacement. On underflow the PIO path goes Low, the driver latches the fault, and recovery requires an explicit restart. Protocol acknowledgement semantics are not implemented yet.

## What normal firmware currently runs

```mermaid
flowchart LR
    Main["Pico main"] --> Demo["servo_demo: construct one fixed SignalPlan"]
    Demo --> Prepared["PreparedOutput: configure pins and state machine"]
    Prepared --> Fixed["FixedOutput: service repeated DMA transfers"]
    Fixed --> HW["DMA to PIO to GP0 and GP1"]
    Demo --> Logger["Logger and UartLogOutput"]
    Logger --> UART["UART1 TX on GP20"]
```

[main.rs](../../firmware/apps/servo-controller/src/main.rs) starts [servo_demo.rs](../../firmware/apps/servo-controller/src/servo_demo.rs). The demo constructs a fixed two-channel pulse plan and starts FixedOutput. It does not construct ServoBank, load calibration from flash, or receive a command protocol. PreparedOutput is the resource-preparation step used before starting an output driver, not a new application control layer. FixedOutput is not an implementation of SignalPlanOutput.

## Calibration persistence

```mermaid
flowchart TD
    subgraph Storage["servo-storage: independent of the storage device"]
        Load["load and find_latest"]
        Append["append: sequence, slot selection and sector rotation"]
        Format["Calibration format, journal envelope and Checksum"]
        Layout["JournalLayout: bounded slot and sector ranges"]
    end
    Read["FlashJournalReader: JournalRead implementation"]
    RAM["Separate RAM program and erase routines"]
    ROM["RP2040 ROM calls and RAM Boot2 restoration"]
    Flash["Reserved QSPI flash: two 4-KiB sectors"]
    Backend["FlashJournalStorage: JournalRead and JournalStorage"]
    Load -->|"read_slot"| Backend
    Backend --> Layout
    Backend -->|"mapped reads with XIP enabled"| Flash
    Read --> Layout
    Read -->|"mapped reads with XIP enabled"| Flash
    Append --> Format
    Load --> Format
    Append -->|"append, reload and rotation verified in hardware tests"| Backend
    Backend -->|"checked program and erase"| RAM
    RAM --> ROM
    ROM -->|"program or erase"| Flash
```

The [storage library](../../firmware/servo-storage/README.md) already implements encoding, CRC validation, latest-record selection and append/sector rotation over storage traits. The [Pico reader](../../firmware/apps/servo-controller/src/flash_journal.rs) implements JournalRead. Separate [RAM routines](../../firmware/apps/servo-controller/src/flash_xip.rs) and manual hardware tests exercise slot programming and sector erasure. The [FlashJournalStorage backend](../../firmware/apps/servo-controller/src/flash_journal_storage.rs) now implements JournalRead and JournalStorage around those routines. Its isolated read/program/erase tests passed. The separate [flash_journal_persistence test](../../firmware/apps/servo-controller/hardware_tests/flash_journal_persistence.rs) now verifies append/load of a valid synthetic eighteen-servo record and loading it after restart without rewriting. The separate [flash_journal_rotation test](../../firmware/apps/servo-controller/hardware_tests/flash_journal_rotation.rs) verifies twenty-five appends, sector switches at sequences 9/17/25, preservation of the previous sector and loading sequence 25 after restart. Its updated test-only restart cycle appends completion marker 26 after verifying sequence 25; the next startup verifies marker 26 and repeats the destructive test preparation. The owner confirmed the automatic-repeat cycle and progress output on hardware on 2026-10-30. Interrupted-operation and power-loss recovery remain unverified on hardware. FlashJournalReader remains as a separate read-only type, but the flash_journal_read test now uses FlashJournalStorage.

A missing valid record is `Ok(None)`; that does not authorize normal operation. Loading a complete configuration, startup-mode enforcement, service invalidation and UART configuration transfer still need integration. A FlashJournalReader must not remain alive during program/erase or XIP reconfiguration.

## Package boundaries and future robot layers

| Cargo package | Architectural role |
| --- | --- |
| hexaroam-servo-control | Angle, calibration, single-servo commands, transactional bank and GPIO-mapping adapter |
| hexaroam-servo-signal | Generic pulse limits, signal plans and output contracts |
| hexaroam-servo-pio | RP2040-specific encoding, output resources, buffers, DMA/PIO and recovery |
| hexaroam-servo-storage | Calibration serialization, CRC abstraction, journal and storage geometry |
| hexaroam-logging | Buffered logging and bounded formatting over a byte-output contract |
| hexaroam-servo-protocol | Header/frame codec, register-map plausibility and stream parsing with CRC/resynchronization |
| hexaroam-servo-registers | Fixed and target register dispatch, ACK/NACK, control transitions and output-backend contract |
| servo-controller | Board setup, concrete UART/flash access, normal demo and separately registered hardware tests |

Behavior, navigation, gait generation, inverse kinematics remain future layers. Protocol framing and register handling are host-tested; UART integration passed the version-2 no-servo hardware suite. Protocol-to-real-PIO and normal-firmware integration remain pending. They are not additional implemented boxes in the current command path. The [project design](../architecture.md) describes their intended roles.

## Host-tested register-control path

```mermaid
flowchart TD
    Bytes["Bytes supplied by PC tests"] --> Parser["StreamParser: servo-protocol"]
    Parser --> Request["ParsedFrame: CRC-valid frame and header-validation result"]
    Request --> Service["RegisterService: servo-registers"]
    Service --> Control["ControlRegister: enable, target access and latched fault"]
    Control --> Backend["OutputBackend contract"]
    Backend --> Fake["Shared simulated output: host tests only"]
    Service --> Reply["ACK or NACK Frame"]
    Reply --> Codec["Frame encoder: servo-protocol"]
    Backend --> Bank["ServoBank adapter: host-tested"]
    Bank -.->|"protocol hardware integration pending"| Hardware["Real servo output"]
```

Eleven host integration tests now connect request bytes, the incremental parser, register handling and encoded ACK/NACK responses. They cover normal reads/control changes, NACK responses and discarded implausible headers, CRC rejection, resynchronization, timeout recovery and consecutive requests. The recovery tests retain the same parser instance; actual UART timing is not tested. The service consumes already checked frames and revalidates access/payload lengths. Status reflects the control component and its backend's current logical output state, not servo positions. Control preserves accepted requests on technical errors while Fault remains latched. The direct ServoBank adapter is host-tested separately; this pipeline uses FakeOutput. The normal Pico fixed-plan demo is unchanged. See the [register-service guide](../../firmware/servo-registers/README.md).

Target-register READ/WRITE uses the same backend boundary and the Angle/ServoId/ServoTarget types from servo-control. Eight target-register service tests use the simulated backend. Four additional byte-stream tests now cover complete eighteen-target transfers, partial updates, atomic rejection and discarded READ-boundary requests and recovery. The direct ServoBank adapter has separate host coverage. See the [target-register guide](../../firmware/servo-registers/README.md#target-angle-registers).

ServoBank preparation and submission are now separate host-tested operations (66 owner-reported servo-control tests). They do not implement output-driver start/stop or the OutputBackend adapter. Zero-degree initialization and real lifecycle integration remain future work. The owner subsequently reported 397 tests overall and all 17 verification checks passing for the combined revision; CI is pending.

## Optional lifecycle contract

SignalPlanLifecycle extends SignalPlanOutput with complete-plan startup, explicit stop and logical state. ServoSignalOutput conditionally exposes start_pulses/stop/state for such backends. Startup and ordinary submission share plan validation; lifecycle errors retain their own associated type. The owner confirmed 74 servo-control tests, 405 tests overall and all 17 verification checks passing. SwitchingOutput now also implements the lifecycle contract; its stop/start hardware tests are described below. The register-service backend adapter remains future work. See the [interface map](interfaces.md#optional-signal-plan-lifecycle).

## Confirmed hardware stop

SwitchingOutput now has inherent stop/state methods backed by exclusive running or stopped DMA resources. Successful stop leaves assigned pins Low, confirms DMA shutdown and discards pending replacements; timeout retains the transfer and its source buffer. service and submission explicitly handle stopped output. The owner confirmed the stop hardware test and both existing fault-restart tests on 2026-11-01, with 405 unit tests and all 17 verification checks passing. Regular start after stop and the production SignalPlanLifecycle trait implementation are now available and hardware-tested; the register-service adapter is not connected. See the [driver guide](../../firmware/servo-pio/README.md#regular-output-stop).

The owner confirmed start_after_stop on 2026-11-01: initial 1 ms/2 ms pulses, a Low pause and subsequent 2 ms/1 ms pulses with the expected success message. Complete plans are validated before stopped resources are moved; FIFO and DMA are prepared before PIO is enabled. The full verification reported 405 tests and all 17 checks passing. CI for this startup revision is pending. See the [startup procedure](../../firmware/apps/servo-controller/hardware_tests/README.md#regular-start-after-stop-test).

## ServoBank lifecycle integration

For PulseBankLifecycle backends, ServoBank now starts the complete prepared target set, stops without clearing targets and reports backend state directly. ServoSignalOutput implements the optional trait over SignalPlanLifecycle. Pulse conversion is shared across ordinary submission and startup while retaining distinct error types. The owner reported 84 servo-control tests, 415 tests overall and all 17 verification checks passing on 2026-11-01. The full bank/adapter/PIO lifecycle chain was subsequently accepted in the separate hardware test below; lower-level driver lifecycle tests were verified separately. The register-service OutputBackend adapter and zero-degree initialization remain future work. The owner subsequently confirmed green CI for this bank-lifecycle revision. See the [trait map](interfaces.md#servobank-lifecycle-bridge).

The owner accepted the [ServoBank lifecycle hardware test](../../firmware/apps/servo-controller/hardware_tests/README.md#servobank-lifecycle-hardware-test) on 2026-11-01 after all 47 hardware-build checks passed and further starts followed the expected signal sequence. The test uses unloaded GPIOs and synthetic calibration; no repeated-cycle endurance or inactive-from-boot behavior is established. The register-service backend adapter remains future work.

## Register service connected to ServoBank

The direct OutputBackend implementation in servo-registers now connects RegisterService -> ControlRegister -> ServoBank -> PulseBankOutput/PulseBankLifecycle. Inactive writes prepare targets; active writes submit calibrated complete batches. Startup validates all prepared targets, stop retains them and state is delegated. RegisterService::service reaches the bank-owned output independently of request handling. Twelve PC tests use the real bank with a recording output; the owner reported 72 register-package tests, 427 tests overall and all 17 verification checks passing on 2026-11-01. The register-service-to-PIO hardware path, UART, journal integration and asynchronous fault reporting remain pending. See the [backend guide](../../firmware/servo-registers/README.md#direct-servobank-backend).

## Byte transport and bounded response transmission

servo-protocol now exposes ByteTransport for nonblocking byte I/O and ResponseBuffer for one copied encoded response with retained transmission progress. These are independent of UART registers and of the register-service ownership chain. The owner reported 62 protocol-package tests, 439 tests overall and all 17 verification checks passing on 2026-11-02. Tests exercise a simulated transmitter, including backpressure and errors. The receive/scheduling layer, actual UART driver and timeout timing remain unimplemented. No receive-to-register-to-UART loop is claimed. See the [transport guide](../../firmware/servo-protocol/README.md#nonblocking-byte-transport-and-response-buffer).

## Integrated frame-processing loop

FrameProcessor in servo-registers owns StreamParser, RegisterService and ResponseBuffer while borrowing ByteTransport per poll. It services output before transport work, retains pending responses under backpressure and drains complete requests before clearing a timed-out incomplete remainder. Newly queued responses transmit on a later poll. The owner reported 84 register-package tests, 62 protocol-package tests, 451 tests overall and all 17 verification checks passing on 2026-11-02. Byte-level tests use a simulated register backend; direct ServoBank integration has separate coverage. Actual UART I/O, clock-based timeout detection and the normal Pico firmware loop remain future work. See the [processor guide](../../firmware/servo-registers/README.md#frame-processing-over-a-byte-transport).

## Concrete protocol UART transport

UartTransport in pico/src implements ByteTransport over an exclusively owned HAL UART. It maps empty/full FIFOs to nonblocking results and reports receive errors without delivering the faulty byte. A separate manual UART0 loopback uses GP16/GP17, with diagnostics on UART1/GP20. The owner confirmed both success messages after 1024 matching bytes and reported 451 tests and all 17 verification checks passing on 2026-11-02. FrameProcessor integration, physical request/response tests and runtime timeout/error policy remain future work. The normal Pico demo and final hardware pin map are unchanged.

## Physical UART register reads

The uart_registers manual example now connects UartTransport -> FrameProcessor -> RegisterService -> NoServoOutput, with binary replies returned over UART0. On 2026-11-02 the owner confirmed Version=1, Status=0 and ServoCount=0 responses with their exact CRC bytes in HTerm, then reported 451 tests and all 17 verification checks passing. The example has no calibrated servo backend; protocol-driven PIO output and journal integration remain separate work. Damaged-frame and timeout recovery have not yet been verified on this physical link. See the [procedure and wire vectors](../../firmware/apps/servo-controller/hardware_tests/README.md#uart-register-requestresponse-test).

## Current protocol verification (2026-11-03)

The owner reported protocol version 2 passing 82 protocol host tests, 75 register host tests and all 21 no-servo UART hardware scenarios. Full local verification passed 462 tests and all 17 checks. ACK/NACK replace READ replies and LastError; the master waits for each response. The older dated implementation notes above describe their respective earlier stages, not the current total or remaining UART work. CI for the current revision has not yet been reported. See the [current contract](../servo-register-protocol.md).
