ebe542/hexaroam/hardware/bom/README.md

# Bill of materials

Maintain a BOM per built revision, including quantity, part identifier, specification, and alternatives. Record verified requirements rather than assuming all reference components will be retained.
