ebe542/hexaroam/hardware/electronics/pico-servo-system/bom.csv

Reference | Quantity | Value | Assembly | Initial population | Footprint
D2 | 1 | 1N5819 | / | Fit
J1 | 1 | PICO 5V IN | / | Fit
J2 | 1 | PORT A: 0..5 | / | Fit | Connector_IDC:IDC-Header_2x06_P2.54mm_Vertical
J3 | 1 | PORT B: 6..11 | / | Fit | Connector_IDC:IDC-Header_2x06_P2.54mm_Vertical
J4 | 1 | PORT C: 12..17 | / | Fit | Connector_IDC:IDC-Header_2x06_P2.54mm_Vertical
J5 | 1 | UART 3V3 TTL | / | Fit
J6 | 1 | EXPANSION | / | Fit
TP1 | 1 | VSYS | / | Fit
TP2 | 1 | USB VBUS | / | Fit
TP3 | 1 | GP0 | / | Fit
TP4 | 1 | GP1 | / | Fit
TP5 | 1 | GND | / | Fit
U1 | 1 | Raspberry Pi Pico | / | Fit | Module:RaspberryPi_Pico_Common_Unspecified
C1 | 1 | 100nF | / | Fit | Capacitor_THT:C_Disc_D5.0mm_W2.5mm_P5.00mm
R1 | 1 | 2k | / | Fit | Resistor_THT:R_Axial_DIN0207_L6.3mm_D2.5mm_P7.62mm_Horizontal
R2 | 1 | 2k | / | Fit | Resistor_THT:R_Axial_DIN0207_L6.3mm_D2.5mm_P7.62mm_Horizontal
U2 | 1 | 24LC256-I/P | / | Fit | Package_DIP:DIP-8_W7.62mm
C100 | 1 | 470uF / 35V | /Six-channel output module/ | Fit
C101 | 1 | 100nF | /Six-channel output module/ | Fit
C102 | 1 | 100nF | /Six-channel output module/ | DNP - reserved
C103 | 1 | 100nF | /Six-channel output module/ | DNP - reserved
C104 | 1 | 100nF | /Six-channel output module/ | DNP - reserved
C105 | 1 | 100nF | /Six-channel output module/ | DNP - reserved
C106 | 1 | 100nF | /Six-channel output module/ | DNP - reserved
J101 | 1 | SIGNAL INPUT | /Six-channel output module/ | Fit | Connector_IDC:IDC-Header_2x06_P2.54mm_Vertical
J102 | 1 | SERVO POWER IN | /Six-channel output module/ | Fit
J110 | 1 | SERVO 0 | /Six-channel output module/ | Fit
J111 | 1 | SERVO 1 | /Six-channel output module/ | DNP - reserved
J112 | 1 | SERVO 2 | /Six-channel output module/ | DNP - reserved
J113 | 1 | SERVO 3 | /Six-channel output module/ | DNP - reserved
J114 | 1 | SERVO 4 | /Six-channel output module/ | DNP - reserved
J115 | 1 | SERVO 5 | /Six-channel output module/ | DNP - reserved
Q101 | 1 | BC547B | /Six-channel output module/ | Fit | Package_TO_SOT_THT:TO-92_Inline
Q102 | 1 | BC547B | /Six-channel output module/ | Fit | Package_TO_SOT_THT:TO-92_Inline
Q103 | 1 | BC547B | /Six-channel output module/ | DNP - reserved | Package_TO_SOT_THT:TO-92_Inline
Q104 | 1 | BC547B | /Six-channel output module/ | DNP - reserved | Package_TO_SOT_THT:TO-92_Inline
Q105 | 1 | BC547B | /Six-channel output module/ | DNP - reserved | Package_TO_SOT_THT:TO-92_Inline
Q106 | 1 | BC547B | /Six-channel output module/ | DNP - reserved | Package_TO_SOT_THT:TO-92_Inline
Q107 | 1 | BC547B | /Six-channel output module/ | DNP - reserved | Package_TO_SOT_THT:TO-92_Inline
Q108 | 1 | BC547B | /Six-channel output module/ | DNP - reserved | Package_TO_SOT_THT:TO-92_Inline
Q109 | 1 | BC547B | /Six-channel output module/ | DNP - reserved | Package_TO_SOT_THT:TO-92_Inline
Q110 | 1 | BC547B | /Six-channel output module/ | DNP - reserved | Package_TO_SOT_THT:TO-92_Inline
Q111 | 1 | BC547B | /Six-channel output module/ | DNP - reserved | Package_TO_SOT_THT:TO-92_Inline
Q112 | 1 | BC547B | /Six-channel output module/ | DNP - reserved | Package_TO_SOT_THT:TO-92_Inline
R101 | 1 | 4.7k | /Six-channel output module/ | Fit
R102 | 1 | 1k | /Six-channel output module/ | Fit
R103 | 1 | 4.7k | /Six-channel output module/ | Fit
R104 | 1 | 1k | /Six-channel output module/ | Fit
R105 | 1 | 100k | /Six-channel output module/ | Fit
R106 | 1 | 180 | /Six-channel output module/ | Fit
R107 | 1 | 100k | /Six-channel output module/ | Fit
R111 | 1 | 4.7k | /Six-channel output module/ | DNP - reserved
R112 | 1 | 1k | /Six-channel output module/ | DNP - reserved
R113 | 1 | 4.7k | /Six-channel output module/ | DNP - reserved
R114 | 1 | 1k | /Six-channel output module/ | DNP - reserved
R115 | 1 | 100k | /Six-channel output module/ | DNP - reserved
R116 | 1 | 180 | /Six-channel output module/ | DNP - reserved
R117 | 1 | 100k | /Six-channel output module/ | DNP - reserved
R121 | 1 | 4.7k | /Six-channel output module/ | DNP - reserved
R122 | 1 | 1k | /Six-channel output module/ | DNP - reserved
R123 | 1 | 4.7k | /Six-channel output module/ | DNP - reserved
R124 | 1 | 1k | /Six-channel output module/ | DNP - reserved
R125 | 1 | 100k | /Six-channel output module/ | DNP - reserved
R126 | 1 | 180 | /Six-channel output module/ | DNP - reserved
R127 | 1 | 100k | /Six-channel output module/ | DNP - reserved
R131 | 1 | 4.7k | /Six-channel output module/ | DNP - reserved
R132 | 1 | 1k | /Six-channel output module/ | DNP - reserved
R133 | 1 | 4.7k | /Six-channel output module/ | DNP - reserved
R134 | 1 | 1k | /Six-channel output module/ | DNP - reserved
R135 | 1 | 100k | /Six-channel output module/ | DNP - reserved
R136 | 1 | 180 | /Six-channel output module/ | DNP - reserved
R137 | 1 | 100k | /Six-channel output module/ | DNP - reserved
R141 | 1 | 4.7k | /Six-channel output module/ | DNP - reserved
R142 | 1 | 1k | /Six-channel output module/ | DNP - reserved
R143 | 1 | 4.7k | /Six-channel output module/ | DNP - reserved
R144 | 1 | 1k | /Six-channel output module/ | DNP - reserved
R145 | 1 | 100k | /Six-channel output module/ | DNP - reserved
R146 | 1 | 180 | /Six-channel output module/ | DNP - reserved
R147 | 1 | 100k | /Six-channel output module/ | DNP - reserved
R151 | 1 | 4.7k | /Six-channel output module/ | DNP - reserved
R152 | 1 | 1k | /Six-channel output module/ | DNP - reserved
R153 | 1 | 4.7k | /Six-channel output module/ | DNP - reserved
R154 | 1 | 1k | /Six-channel output module/ | DNP - reserved
R155 | 1 | 100k | /Six-channel output module/ | DNP - reserved
R156 | 1 | 180 | /Six-channel output module/ | DNP - reserved
R157 | 1 | 100k | /Six-channel output module/ | DNP - reserved
TP101 | 1 | SERVO 0 SIGNAL | /Six-channel output module/ | Fit
TP102 | 1 | LOCAL GND | /Six-channel output module/ | Fit
C201 | 1 | 1000uF / 25V | /ONE-SERVO protected supply/ | Fit
C202 | 1 | 100nF / >=25V | /ONE-SERVO protected supply/ | Fit
C203 | 1 | 100nF / >=25V | /ONE-SERVO protected supply/ | Fit
D201 | 1 | SR540 | /ONE-SERVO protected supply/ | Fit
D202 | 1 | 1N5822 | /ONE-SERVO protected supply/ | Fit
F201 | 1 | T2.5A provisional | /ONE-SERVO protected supply/ | Fit
J201 | 1 | SERVO PSU IN | /ONE-SERVO protected supply/ | Fit
J202 | 1 | POWER OUT | /ONE-SERVO protected supply/ | Fit
Q201 | 1 | IRLZ44NPBF | /ONE-SERVO protected supply/ | Fit | Package_TO_SOT_THT:TO-220-3_Vertical
R201 | 1 | 330 / 1% | /ONE-SERVO protected supply/ | Fit
R202 | 1 | 13.7k / 1% | /ONE-SERVO protected supply/ | Fit
R203 | 1 | 10k / 1% | /ONE-SERVO protected supply/ | Fit
R204 | 1 | 270k / 1% | /ONE-SERVO protected supply/ | Fit
R205 | 1 | 2.2k / 1% | /ONE-SERVO protected supply/ | Fit
R206 | 1 | 100 / 1% | /ONE-SERVO protected supply/ | Fit
R207 | 1 | 100k / 1% | /ONE-SERVO protected supply/ | Fit
R208 | 1 | 2.2 / HS25 25W 1% | /ONE-SERVO protected supply/ | Fit / off-board on heatsink
SW201 | 1 | 5A / 12V DC min. | /ONE-SERVO protected supply/ | Fit
TP201 | 1 | SERVO VS | /ONE-SERVO protected supply/ | Fit
TP202 | 1 | GND | /ONE-SERVO protected supply/ | Fit
TP203 | 1 | VREF | /ONE-SERVO protected supply/ | Fit
TP204 | 1 | SENSE | /ONE-SERVO protected supply/ | Fit
TP205 | 1 | GATE | /ONE-SERVO protected supply/ | Fit
TP206 | 1 | DRAIN | /ONE-SERVO protected supply/ | Fit
U201 | 1 | TL431CZ (ST) | /ONE-SERVO protected supply/ | Fit | Package_TO_SOT_THT:TO-92_Inline
U202 | 1 | LM393 DIP | /ONE-SERVO protected supply/ | Fit | Package_DIP:DIP-8_W7.62mm
MECH-SOCKETS | 2 | 1x20 female socket, 2.54mm, Pico mounting | Off-schematic | Fit / mechanical proposal
MECH-CABLE | 1 | 12-way 1:1 ribbon cable, initially short | Off-schematic | Fit / mechanical proposal
MECH-IDC-SOCKET | 2 | 2x6 keyed female IDC cable socket, mating to J2/J101 | Off-schematic | Fit / mechanical proposal
MECH-BASE | 1 | 100x160mm individual-pad perfboard, controller envelope | Off-schematic | Fit / mechanical proposal
MECH-OUTPUT | 1 | 100x160mm individual-pad perfboard, output-module envelope | Off-schematic | Fit / mechanical proposal
MECH-POWER | 1 | 100x160mm perfboard reserve; final placement TBD; external heatsink not included | Off-schematic | Fit / mechanical proposal
MECH-WIRE | 1 | Power wiring and strain relief, rating to be sized | Off-schematic | Fit / mechanical proposal
MECH-HEATSINK | 1 | <=1.5 K/W open-air heatsink candidate; e.g. SK 08 100 SA; mounting review required | Off-schematic | Required / mechanical qualification pending
MECH-THERMAL | 1 | Resistor mounting screws and thermal compound; keep wiring clear of hot parts | Off-schematic | Required / mechanical qualification pending
MECH-DIP8 | 1 | DIP-8 socket for U202 | Off-schematic | Optional
MECH-SETUP-R | 1 | 1k >=0.25W setup resistor; not fitted in normal circuit | Off-schematic | Required / commissioning tool
MECH-EEPROM-SOCKET | 1 | DIP-8 socket for removable U2; 7.62mm row spacing | Off-schematic | Fit / mechanical proposal
