ebe542/hexaroam/hardware/electronics/pico-baseboard-re200-lf/pin-map.csv

ref | pin | hole | column | row | x_mm | y_mm | net | drill_mm
D2 | 1 | C16-R08 | 16 | 8 | 41.99 | 20.85 | /PICO_VSYS | 1.0
D2 | 2 | C20-R08 | 20 | 8 | 52.15 | 20.85 | /PICO_EXT_5V | 1.0
J1 | 1 | C12-R04 | 12 | 4 | 31.83 | 10.69 | /PICO_EXT_5V | 1.3
J1 | 2 | C10-R04 | 10 | 4 | 26.75 | 10.69 | GND | 1.3
J2 | 1 | C53-R04 | 53 | 4 | 135.97 | 10.69 | /SERVO0_3V3 | 1.0
J2 | 2 | C54-R04 | 54 | 4 | 138.51 | 10.69 | GND | 1.0
J2 | 3 | C53-R05 | 53 | 5 | 135.97 | 13.23 | /SERVO1_3V3 | 1.0
J2 | 4 | C54-R05 | 54 | 5 | 138.51 | 13.23 | GND | 1.0
J2 | 5 | C53-R06 | 53 | 6 | 135.97 | 15.77 | /SERVO2_3V3 | 1.0
J2 | 6 | C54-R06 | 54 | 6 | 138.51 | 15.77 | GND | 1.0
J2 | 7 | C53-R07 | 53 | 7 | 135.97 | 18.31 | /SERVO3_3V3 | 1.0
J2 | 8 | C54-R07 | 54 | 7 | 138.51 | 18.31 | GND | 1.0
J2 | 9 | C53-R08 | 53 | 8 | 135.97 | 20.85 | /SERVO4_3V3 | 1.0
J2 | 10 | C54-R08 | 54 | 8 | 138.51 | 20.85 | GND | 1.0
J2 | 11 | C53-R09 | 53 | 9 | 135.97 | 23.39 | /SERVO5_3V3 | 1.0
J2 | 12 | C54-R09 | 54 | 9 | 138.51 | 23.39 | GND | 1.0
J3 | 1 | C53-R15 | 53 | 15 | 135.97 | 38.63 | /SERVO6_3V3 | 1.0
J3 | 2 | C54-R15 | 54 | 15 | 138.51 | 38.63 | GND | 1.0
J3 | 3 | C53-R16 | 53 | 16 | 135.97 | 41.17 | /SERVO7_3V3 | 1.0
J3 | 4 | C54-R16 | 54 | 16 | 138.51 | 41.17 | GND | 1.0
J3 | 5 | C53-R17 | 53 | 17 | 135.97 | 43.71 | /SERVO8_3V3 | 1.0
J3 | 6 | C54-R17 | 54 | 17 | 138.51 | 43.71 | GND | 1.0
J3 | 7 | C53-R18 | 53 | 18 | 135.97 | 46.25 | /SERVO9_3V3 | 1.0
J3 | 8 | C54-R18 | 54 | 18 | 138.51 | 46.25 | GND | 1.0
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
U1 | 36 | C05-R14 | 5 | 14 | 14.05 | 36.09 | /PICO_3V3 | 1.0
U1 | 37 | C04-R14 | 4 | 14 | 11.51 | 36.09 |  | 1.0
U1 | 38 | C03-R14 | 3 | 14 | 8.97 | 36.09 | GND | 1.0
U1 | 39 | C02-R14 | 2 | 14 | 6.43 | 36.09 | /PICO_VSYS | 1.0
U1 | 40 | C01-R14 | 1 | 14 | 3.89 | 36.09 | /USB_VBUS | 1.0
