ebe542/hexaroam/hardware/electronics/servo-power-re200-lf/pin-map.csv

ref | pin | hole | column | row | x_mm | y_mm | net | drill_mm | dnp | anchor | channel
J201 | 1 | C04-R06 | 4 | 6 | 11.51 | 15.77 | /ONE-SERVO protected supply/PSU_POS | 1.3 | False | False
J201 | 2 | C06-R06 | 6 | 6 | 16.59 | 15.77 | GND | 1.3 | False | False
SW201 | 1 | C24-R04 | 24 | 4 | 62.31 | 10.69 | /ONE-SERVO protected supply/FUSED_POS | 1.3 | False | False
SW201 | 2 | C26-R04 | 26 | 4 | 67.39 | 10.69 | /ONE-SERVO protected supply/SWITCHED_POS | 1.3 | False | False
J202 | 1 | C52-R05 | 52 | 5 | 133.43 | 13.23 | /SERVO_VS | 1.3 | False | False
J202 | 2 | C54-R05 | 54 | 5 | 138.51 | 13.23 | GND | 1.3 | False | False
R208 | 1 | C52-R13 | 52 | 13 | 133.43 | 33.55 | /SERVO_VS | 1.3 | False | False
R208 | 2 | C54-R13 | 54 | 13 | 138.51 | 33.55 | /ONE-SERVO protected supply/DUMP_DRAIN | 1.3 | False | False
F201 | 1 | C10-R07 | 10 | 7 | 26.75 | 18.31 | /ONE-SERVO protected supply/PSU_POS | 1.5 | False | False
F201 | 2 | C19-R07 | 19 | 7 | 49.61 | 18.31 | /ONE-SERVO protected supply/FUSED_POS | 1.5 | False | False
D201 | 1 | C35-R07 | 35 | 7 | 90.25 | 18.31 | /SERVO_VS | 1.5 | False | False
D201 | 2 | C29-R07 | 29 | 7 | 75.01 | 18.31 | /ONE-SERVO protected supply/SWITCHED_POS | 1.5 | False | False
D202 | 1 | C47-R15 | 47 | 15 | 120.73 | 38.63 | /SERVO_VS | 1.5 | False | False
D202 | 2 | C47-R21 | 47 | 21 | 120.73 | 53.87 | /ONE-SERVO protected supply/DUMP_DRAIN | 1.5 | False | False
C201 | 1 | C38-R09 | 38 | 9 | 97.87 | 23.39 | /SERVO_VS | 1.0 | False | False
C201 | 2 | C40-R09 | 40 | 9 | 102.95 | 23.39 | GND | 1.0 | False | False
C202 | 1 | C38-R13 | 38 | 13 | 97.87 | 33.55 | /SERVO_VS | 1.0 | False | False
C202 | 2 | C39-R13 | 39 | 13 | 100.41 | 33.55 | GND | 1.0 | False | False
C203 | 1 | C33-R16 | 33 | 16 | 85.17 | 41.17 | /SERVO_VS | 1.0 | False | False
C203 | 2 | C34-R16 | 34 | 16 | 87.71 | 41.17 | GND | 1.0 | False | False
U202 | 1 | C29-R18 | 29 | 18 | 75.01 | 46.25 | /ONE-SERVO protected supply/DUMP_OUT | 1.0 | False | False
U202 | 2 | C29-R19 | 29 | 19 | 75.01 | 48.79 | /ONE-SERVO protected supply/VREF | 1.0 | False | False
U202 | 3 | C29-R20 | 29 | 20 | 75.01 | 51.33 | /ONE-SERVO protected supply/SENSE | 1.0 | False | False
U202 | 4 | C29-R21 | 29 | 21 | 75.01 | 53.87 | GND | 1.0 | False | False
U202 | 5 | C32-R21 | 32 | 21 | 82.63 | 53.87 | GND | 1.0 | False | False
U202 | 6 | C32-R20 | 32 | 20 | 82.63 | 51.33 | /ONE-SERVO protected supply/VREF | 1.0 | False | False
U202 | 7 | C32-R19 | 32 | 19 | 82.63 | 48.79 |  | 1.0 | False | False
U202 | 8 | C32-R18 | 32 | 18 | 82.63 | 46.25 | /SERVO_VS | 1.0 | False | False
U201 | 1 | C20-R23 | 20 | 23 | 52.15 | 58.95 | /ONE-SERVO protected supply/VREF | 1.0 | False | False
U201 | 2 | C21-R23 | 21 | 23 | 54.69 | 58.95 | GND | 1.0 | False | False
U201 | 3 | C22-R23 | 22 | 23 | 57.23 | 58.95 | /ONE-SERVO protected supply/VREF | 1.0 | False | False
Q201 | 1 | C41-R19 | 41 | 19 | 105.49 | 48.79 | /ONE-SERVO protected supply/DUMP_GATE | 1.3 | False | False
Q201 | 2 | C42-R19 | 42 | 19 | 108.03 | 48.79 | /ONE-SERVO protected supply/DUMP_DRAIN | 1.3 | False | False
Q201 | 3 | C43-R19 | 43 | 19 | 110.57 | 48.79 | GND | 1.3 | False | False
R201 | 1 | C22-R16 | 22 | 16 | 57.23 | 41.17 | /SERVO_VS | 1.0 | False | False
R201 | 2 | C22-R20 | 22 | 20 | 57.23 | 51.33 | /ONE-SERVO protected supply/VREF | 1.0 | False | False
R202 | 1 | C26-R25 | 26 | 25 | 67.39 | 64.03 | /SERVO_VS | 1.0 | False | False
R202 | 2 | C26-R29 | 26 | 29 | 67.39 | 74.19 | /ONE-SERVO protected supply/SENSE | 1.0 | False | False
R203 | 1 | C26-R33 | 26 | 33 | 67.39 | 84.35 | /ONE-SERVO protected supply/SENSE | 1.0 | False | False
R203 | 2 | C26-R37 | 26 | 37 | 67.39 | 94.51 | GND | 1.0 | False | False
R204 | 1 | C29-R26 | 29 | 26 | 75.01 | 66.57 | /ONE-SERVO protected supply/SENSE | 1.0 | False | False
R204 | 2 | C33-R26 | 33 | 26 | 85.17 | 66.57 | /ONE-SERVO protected supply/DUMP_OUT | 1.0 | False | False
R205 | 1 | C29-R11 | 29 | 11 | 75.01 | 28.47 | /SERVO_VS | 1.0 | False | False
R205 | 2 | C29-R15 | 29 | 15 | 75.01 | 38.63 | /ONE-SERVO protected supply/DUMP_OUT | 1.0 | False | False
R206 | 1 | C35-R19 | 35 | 19 | 90.25 | 48.79 | /ONE-SERVO protected supply/DUMP_OUT | 1.0 | False | False
R206 | 2 | C39-R19 | 39 | 19 | 100.41 | 48.79 | /ONE-SERVO protected supply/DUMP_GATE | 1.0 | False | False
R207 | 1 | C41-R24 | 41 | 24 | 105.49 | 61.49 | /ONE-SERVO protected supply/DUMP_GATE | 1.0 | False | False
R207 | 2 | C41-R28 | 41 | 28 | 105.49 | 71.65 | GND | 1.0 | False | False
TP201 | 1 | C41-R05 | 41 | 5 | 105.49 | 13.23 | /SERVO_VS | 1.0 | False | False
TP202 | 1 | C43-R10 | 43 | 10 | 110.57 | 25.93 | GND | 1.0 | False | False
TP203 | 1 | C18-R25 | 18 | 25 | 47.07 | 64.03 | /ONE-SERVO protected supply/VREF | 1.0 | False | False
TP204 | 1 | C28-R30 | 28 | 30 | 72.47 | 76.73 | /ONE-SERVO protected supply/SENSE | 1.0 | False | False
TP205 | 1 | C39-R22 | 39 | 22 | 100.41 | 56.41 | /ONE-SERVO protected supply/DUMP_GATE | 1.0 | False | False
TP206 | 1 | C49-R24 | 49 | 24 | 125.81 | 61.49 | /ONE-SERVO protected supply/DUMP_DRAIN | 1.0 | False | False
BV | 1 | C43-R08 | 43 | 8 | 110.57 | 20.85 | /SERVO_VS | 1.0 | False | True
BG | 1 | C43-R12 | 43 | 12 | 110.57 | 31.01 | GND | 1.0 | False | True
BD | 1 | C45-R20 | 45 | 20 | 115.65 | 51.33 | /ONE-SERVO protected supply/DUMP_DRAIN | 1.0 | False | True
GS | 1 | C43-R23 | 43 | 23 | 110.57 | 58.95 | GND | 1.0 | False | True
