ebe542/hexaroam/docs/development-setup.md

# Development setup

This guide covers Windows with Git Bash and Ubuntu with Bash. The selected board is Raspberry Pi Pico with RP2040. It documents the development environment. The initial Pico dependencies, linker configuration, and USB transfer workflow are documented in the [firmware guide](../firmware/README.md); debugging remains a later step.

## Verification status

As of 2026-10-12:

- The project owner confirmed Rust and Cargo are available on Windows, with stable MSVC active, rustfmt and Clippy installed, and rust-analyzer installed in VS Code.
- The owner confirmed that Rust formatting settings were added.
- The owner confirmed installation of `thumbv6m-none-eabi` alongside the Windows host target.
- The owner reported successful firmware checks, a linked build, UF2 conversion, and physical LED blinking on the Pico.
- elf2uf2-rs 2.2.0 was installed and used for conversion.
- On 2026-10-13, the owner confirmed execution of the fixed PIO pulse firmware and an analog oscilloscope observation. See the firmware guide for readings and limitations.
- Cargo now has `runner = "elf2uf2-rs"`; `cargo run --locked` builds and converts to UF2 without automatically flashing the board.
- Host-side build scripts and installation of the UF2 converter succeeded. No separate Windows application test has been performed.
- Ubuntu instructions have not been executed for this project.

Reported Windows versions (an observation, not a project version requirement):

```text
rustc 1.99.0 (b940084d7 2026-09-28)
cargo 1.99.0 (5f94df478 2026-08-27)
```

No project toolchain version is pinned yet. Record the versions used when reporting build results.

## Windows: Git Bash

### Install Rust

1. Install Git for Windows and VS Code if needed.
2. Download the appropriate `rustup-init.exe` from the [official Rust installation page](https://rust-lang.org/tools/install/).
3. Run the installer and select the standard installation using the stable MSVC toolchain. On an x64 Windows host the toolchain is `stable-x86_64-pc-windows-msvc`.
4. If prerequisites are missing, follow the installer prompts or the [MSVC prerequisites guide](https://rust-lang.github.io/rustup/installation/windows-msvc.html). Windows host executables require the MSVC C++ build tools and Windows SDK. The Visual Studio installer workload is “Desktop development with C++”.
5. Restart Git Bash. If VS Code still uses the old PATH, close all VS Code windows and reopen it.

Git Bash is the shell; it does not require switching Rust to the GNU toolchain.

Check availability in a new Git Bash terminal:

```bash
rustup --version
rustc --version
cargo --version
rustup show
```

Expect stable MSVC to be active. These commands confirm tool availability, not successful linking.

### VS Code terminal

Select Git Bash as the default terminal profile, or merge this entry into the existing workspace settings:

```json
{
  "terminal.integrated.defaultProfile.windows": "Git Bash"
}
```

## Ubuntu: Bash

Install basic host build and download tools:

```bash
sudo apt update
sudo apt install build-essential curl ca-certificates git
```

Install Rust using the command from the [official installation page](https://rust-lang.org/tools/install/):

```bash
curl --proto '=https' --tlsv1.2 -sSf https://sh.rustup.rs | sh
```

Select the standard installation. Run rustup as your normal user, not with sudo.

Open a new terminal, or load the environment into the current Bash session:

```bash
source "$HOME/.cargo/env"
```

Check availability:

```bash
rustup --version
rustc --version
cargo --version
rustup show
```

Expect an active stable Linux toolchain matching the machine architecture. On an x64 machine the host is `x86_64-unknown-linux-gnu`; ARM64 hosts use a different target.

Install VS Code using its [official Linux installation instructions](https://code.visualstudio.com/docs/setup/linux). Use Bash on Ubuntu; the Windows terminal-profile setting does not select an Ubuntu shell.

This guide does not configure WSL USB access or Linux debug-probe permissions. Those depend on the later flashing/debugging workflow.

## Shared Rust components

Check what is installed:

```bash
rustup component list --installed
```

If rustfmt or Clippy is missing:

```bash
rustup component add rustfmt clippy
```

- rustup manages toolchains, components, and targets.
- rustc compiles Rust.
- Cargo manages packages, dependencies, and builds.
- rustfmt formats source code.
- Clippy provides additional code diagnostics.

## VS Code: rust-analyzer and formatting

Install the extension with ID `rust-lang.rust-analyzer` from the Extensions view. See the [rust-analyzer editor installation guide](https://rust-analyzer.github.io/book/editor_features.html#vs-code).

Merge this language block into the existing `.vscode/settings.json`; do not replace unrelated settings:

```json
{
  "[rust]": {
    "editor.defaultFormatter": "rust-lang.rust-analyzer",
    "editor.formatOnSave": true
  }
}
```

The surrounding braces illustrate a settings object. When merging, keep only one top-level object and separate entries with commas.

The existing TOML formatter may be retained for future Cargo.toml files. Workspace settings are currently ignored by Git and must be configured locally on each machine.

The firmware Cargo package is nested under `firmware/apps/servo-controller`. When opening the repository root in VS Code, merge these top-level settings into the local workspace settings:

```json
{
  "rust-analyzer.linkedProjects": ["firmware/apps/servo-controller/Cargo.toml"],
  "rust-analyzer.cargo.allTargets": false
}
```

The explicit manifest path resolves workspace discovery. Disabling all-target checks avoids checking test targets for this bare-metal binary. After saving, run "rust-analyzer: Restart server" from the Command Palette. Alternatively, open `firmware/apps/servo-controller` directly; the linkedProjects path above is intended for opening the repository root.

The repository `rustfmt.toml` sets `max_width = 80`, `fn_call_width = 40`, and `chain_width = 40`. These settings also apply to formatting on save.

## Raspberry Pi Pico target

For the RP2040 Cortex-M0+ cores, install:

```bash
rustup target add thumbv6m-none-eabi
rustup target list --installed
```

Expect `thumbv6m-none-eabi` plus the host target. The host target remains installed.

The embedded target supplies the Rust target libraries; it does not create firmware, install a board support package, or configure flashing. Bare-metal firmware will use `no_std`, with the runtime, memory layout, and hardware access discussed before implementation. See [rustup cross-compilation](https://rust-lang.github.io/rustup/cross-compilation.html).

No C/C++ Pico SDK is required for the Rust HAL approach. See the [firmware guide](../firmware/README.md) and `firmware/apps/servo-controller/Cargo.lock` for the implemented workflow and resolved dependency versions.

## Shared signal library tests

From the repository root:

```bash
cd firmware/servo-signal
cargo test --lib
```

Run the sibling library tests from its own directory to use the host target, separately from the Pico configuration. The owner reported six passing tests on Windows on 2026-10-14, a successful embedded build, and apparently unchanged output on the Pico. Ubuntu execution remains unverified. See the [library guide](../firmware/servo-signal/README.md) for coverage and the [firmware guide](../firmware/README.md) for hardware limitations.

## Next steps

1. Review and commit the shared signal library, its six host tests, and the Pico integration.
2. Select a servo and document its electrical requirements.
3. Agree on wiring and signal parameters before implementing servo control.

The project owner performs implementation, builds, tests, and commits. Setup command output and hardware results should be reported separately from documentation review.

## Shared development commands

Use Python 3.10 or newer to run `python tools/dev.py verify` from the repository root. On Ubuntu the interpreter may be named python3. No additional Python packages are needed. This checks formatting for the Rust packages registered in tools/dev.py, runs Python and Rust host unit tests, and builds the Pico firmware. `python tools/dev.py check` only checks Rust formatting and runs cargo check; `python tools/dev.py build` builds the Pico ELF. GitHub Actions uses test and verify. See the [task runner guide](../tools/README.md) for formatting, UF2 conversion, and separate hardware-test builds. Verification of this task split is pending.

## Combined project-tool installation

Once Python 3.10+, Rustup/Rust/Cargo and the operating-system build prerequisites above are installed, run from the repository root:

```bash
python tools/dev.py install
```

On Ubuntu use python3 if needed. This installs the project's Rust components (rustfmt, clippy, llvm-tools-preview), the Pico target and the pinned host elf2uf2-rs converter. It uses the active toolchain without updating Rust or changing the default. See the [installation task](../tools/README.md#install-development-tools) for scope and failure handling. Then run `python tools/dev.py verify` and, for the manual firmware programs, `python tools/dev.py hardware-build`. Neither command uploads firmware.
