ebe542/hexaroam/hardware/electronics/pico-baseboard-re200-lf/assembly-guide.pdf

# Pico baseboard: component placement

Component side; uncoated face toward you; USB to the left. Coordinates are C(column)-R(row).

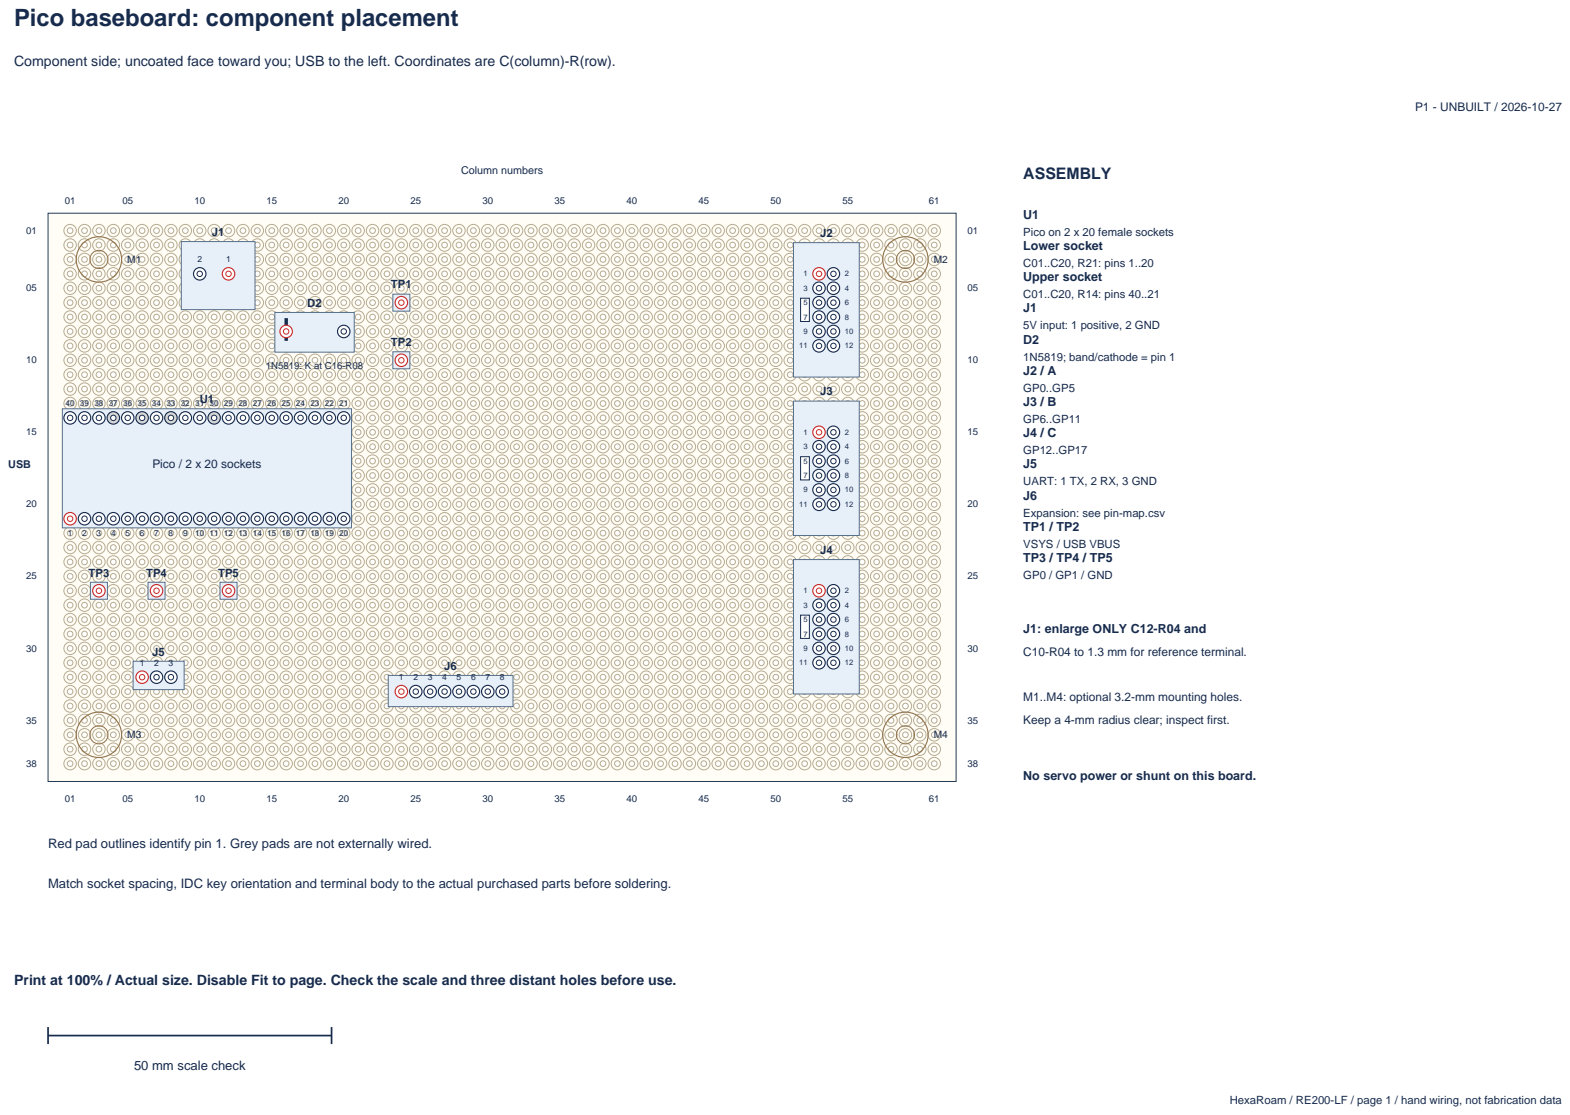
[picture p1: page 1]

J1: enlarge ONLY C12-R04 and
C10-R04 to 1.3 mm for reference terminal.

M1..M4: optional 3.2-mm mounting holes.
Keep a 4-mm radius clear; inspect first.

No servo power or shunt on this board.

Red pad outlines identify pin 1. Grey pads are not externally wired.

Match socket spacing, IDC key orientation and terminal body to the actual purchased parts before soldering.

Print at 100% / Actual size. Disable Fit to page. Check the scale and three distant holes before use.

HexaRoam / RE200-LF / page 1 / hand wiring, not fabrication data

# Pico baseboard: solder-side reference

MIRRORED horizontally from component view. USB is now on the right. Hole IDs do not change.

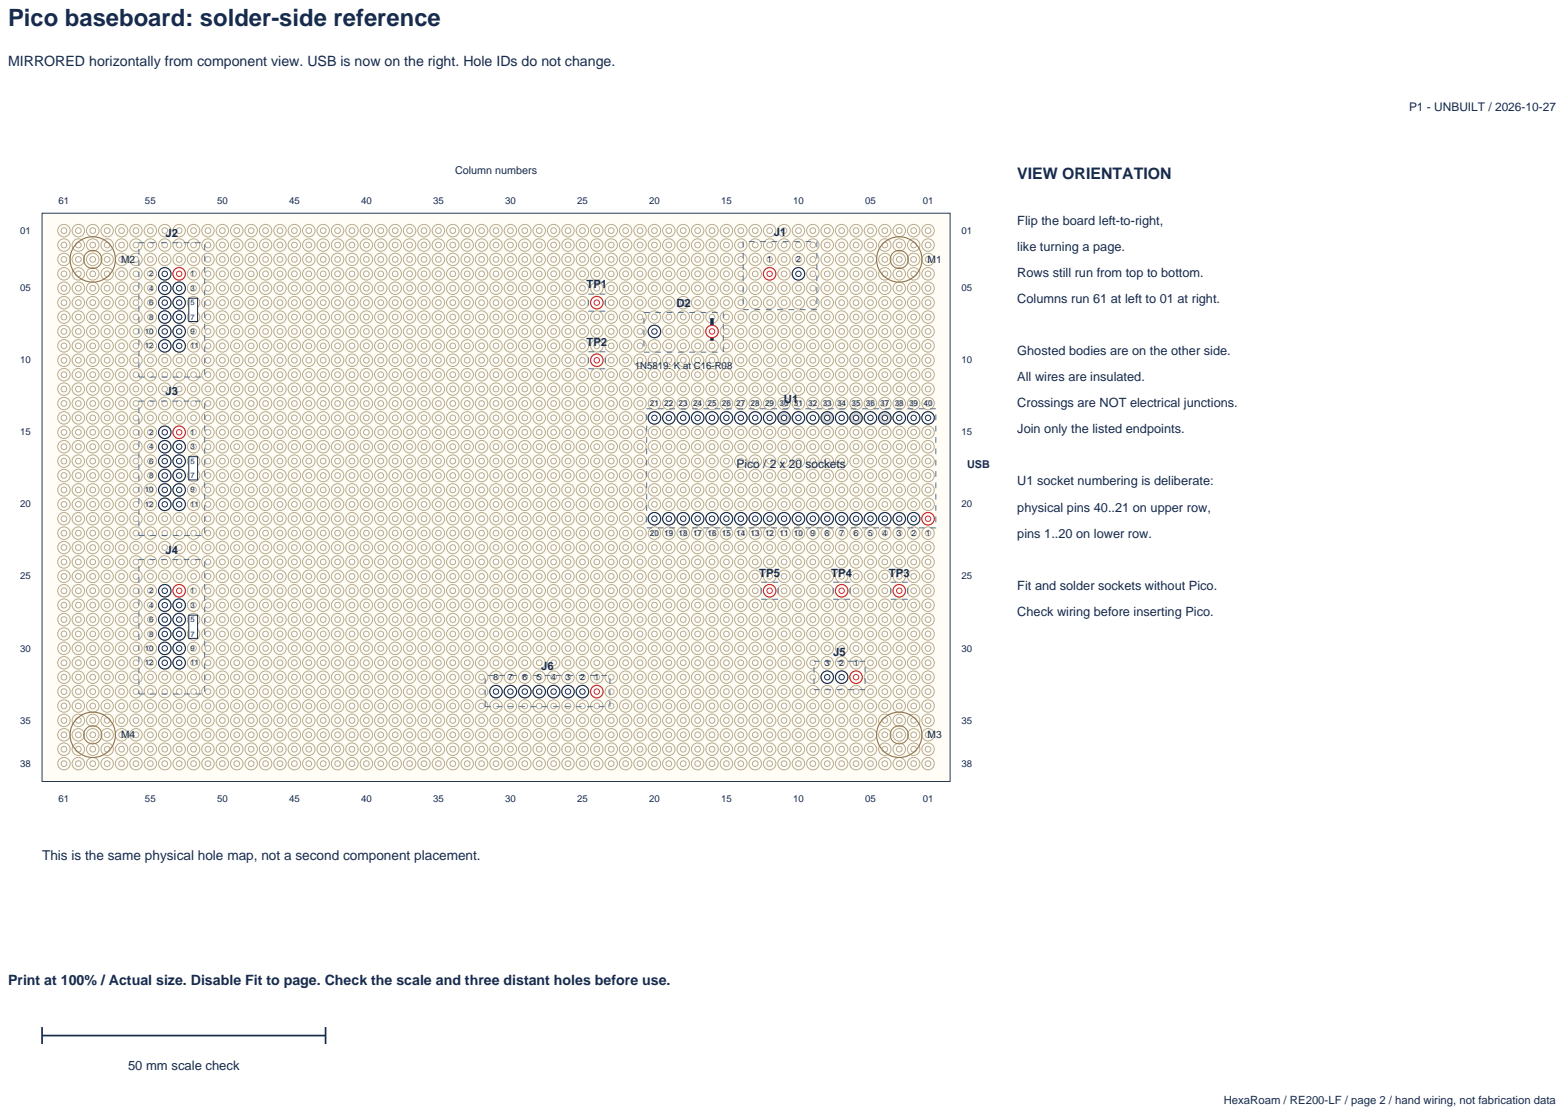
[picture p2: page 2]

Flip the board left-to-right,
like turning a page.
Rows still run from top to bottom.
Columns run 61 at left to 01 at right.

Ghosted bodies are on the other side.
All wires are insulated.
Crossings are NOT electrical junctions.
Join only the listed endpoints.

U1 socket numbering is deliberate:
physical pins 40..21 on upper row,
pins 1..20 on lower row.

Fit and solder sockets without Pico.
Check wiring before inserting Pico.

This is the same physical hole map, not a second component placement.

Print at 100% / Actual size. Disable Fit to page. Check the scale and three distant holes before use.

HexaRoam / RE200-LF / page 2 / hand wiring, not fabrication data

# Solder-side wiring: Ground and Pico supply

Mirrored view. Lines show endpoint connections; choose a practical insulated-wire route on the real board.

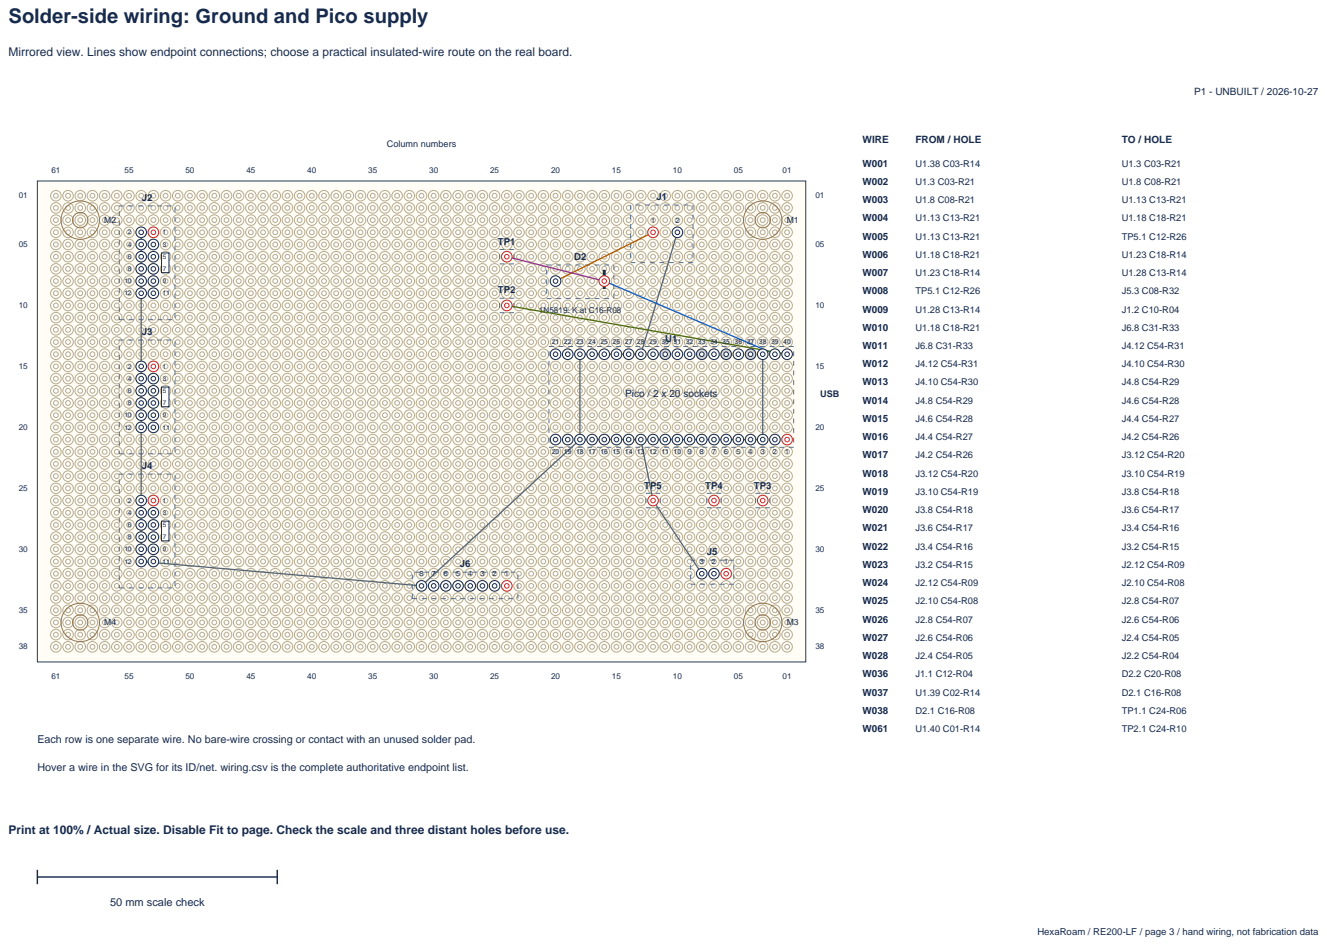
[picture p3: page 3]

Each row is one separate wire. No bare-wire crossing or contact with an unused solder pad.

Hover a wire in the SVG for its ID/net. wiring.csv is the complete authoritative endpoint list.

Print at 100% / Actual size. Disable Fit to page. Check the scale and three distant holes before use.

HexaRoam / RE200-LF / page 3 / hand wiring, not fabrication data

# Solder-side wiring: Port A / GP0..GP5

Mirrored view. Lines show endpoint connections; choose a practical insulated-wire route on the real board.

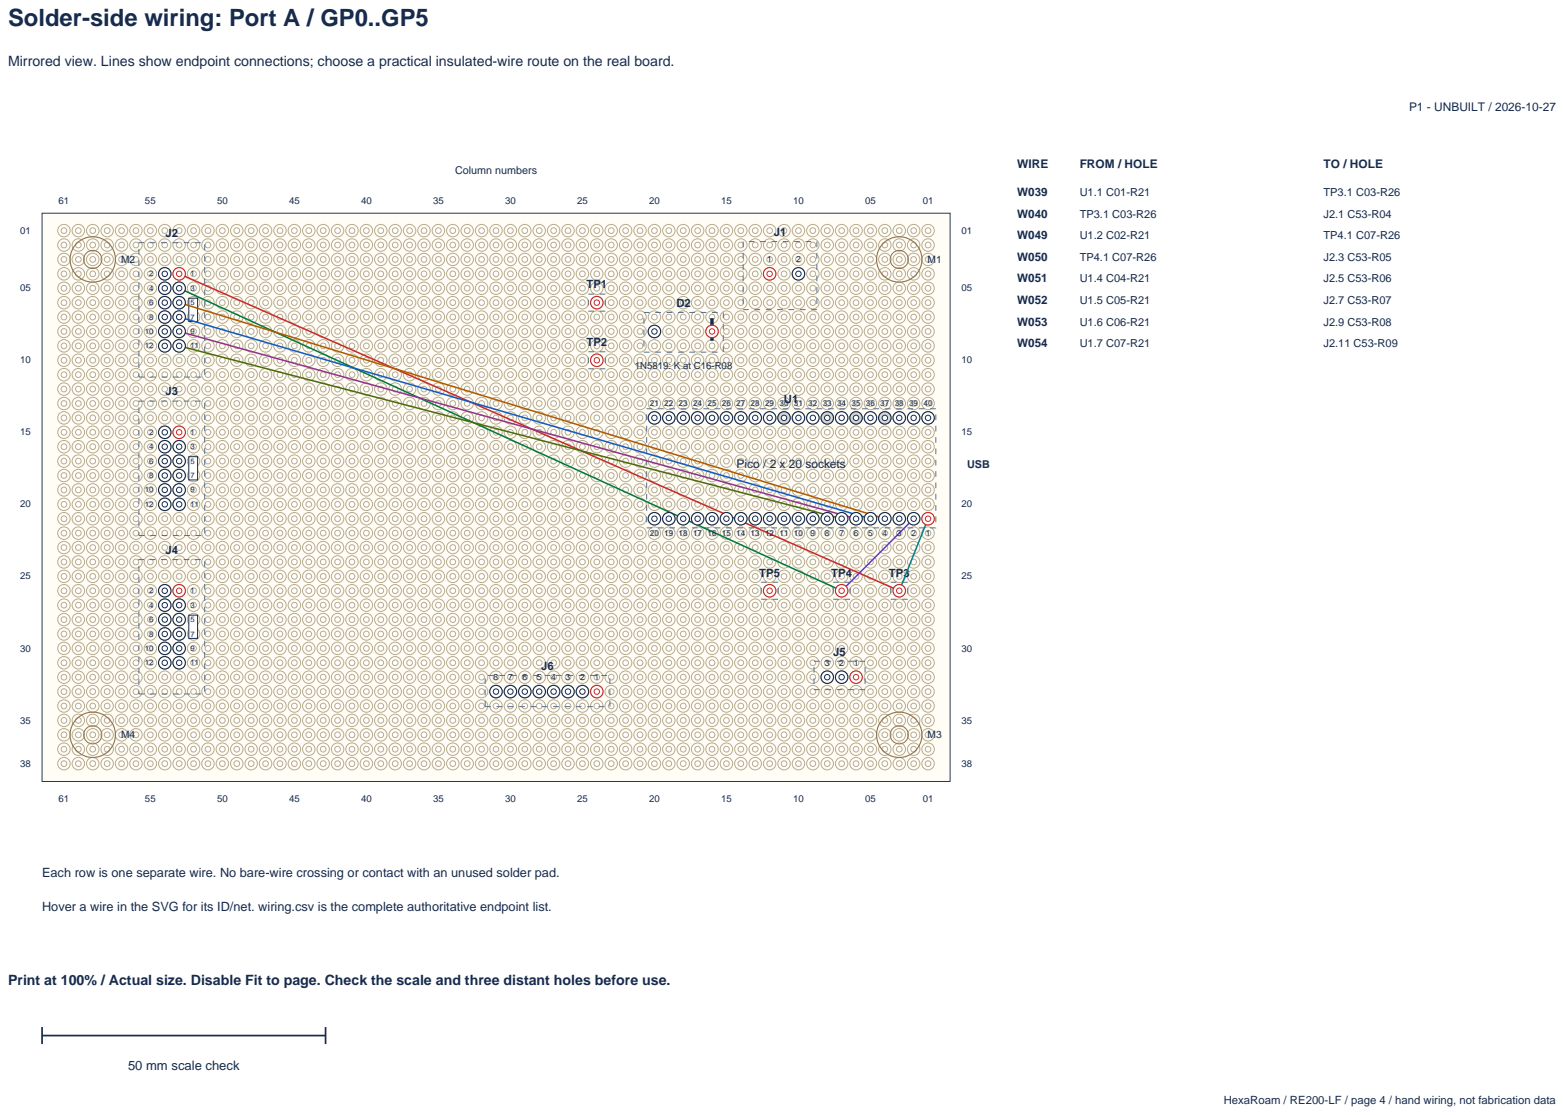
[picture p4: page 4]

Each row is one separate wire. No bare-wire crossing or contact with an unused solder pad.

Hover a wire in the SVG for its ID/net. wiring.csv is the complete authoritative endpoint list.

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

HexaRoam / RE200-LF / page 4 / hand wiring, not fabrication data

# Solder-side wiring: Port B / GP6..GP11

Mirrored view. Lines show endpoint connections; choose a practical insulated-wire route on the real board.

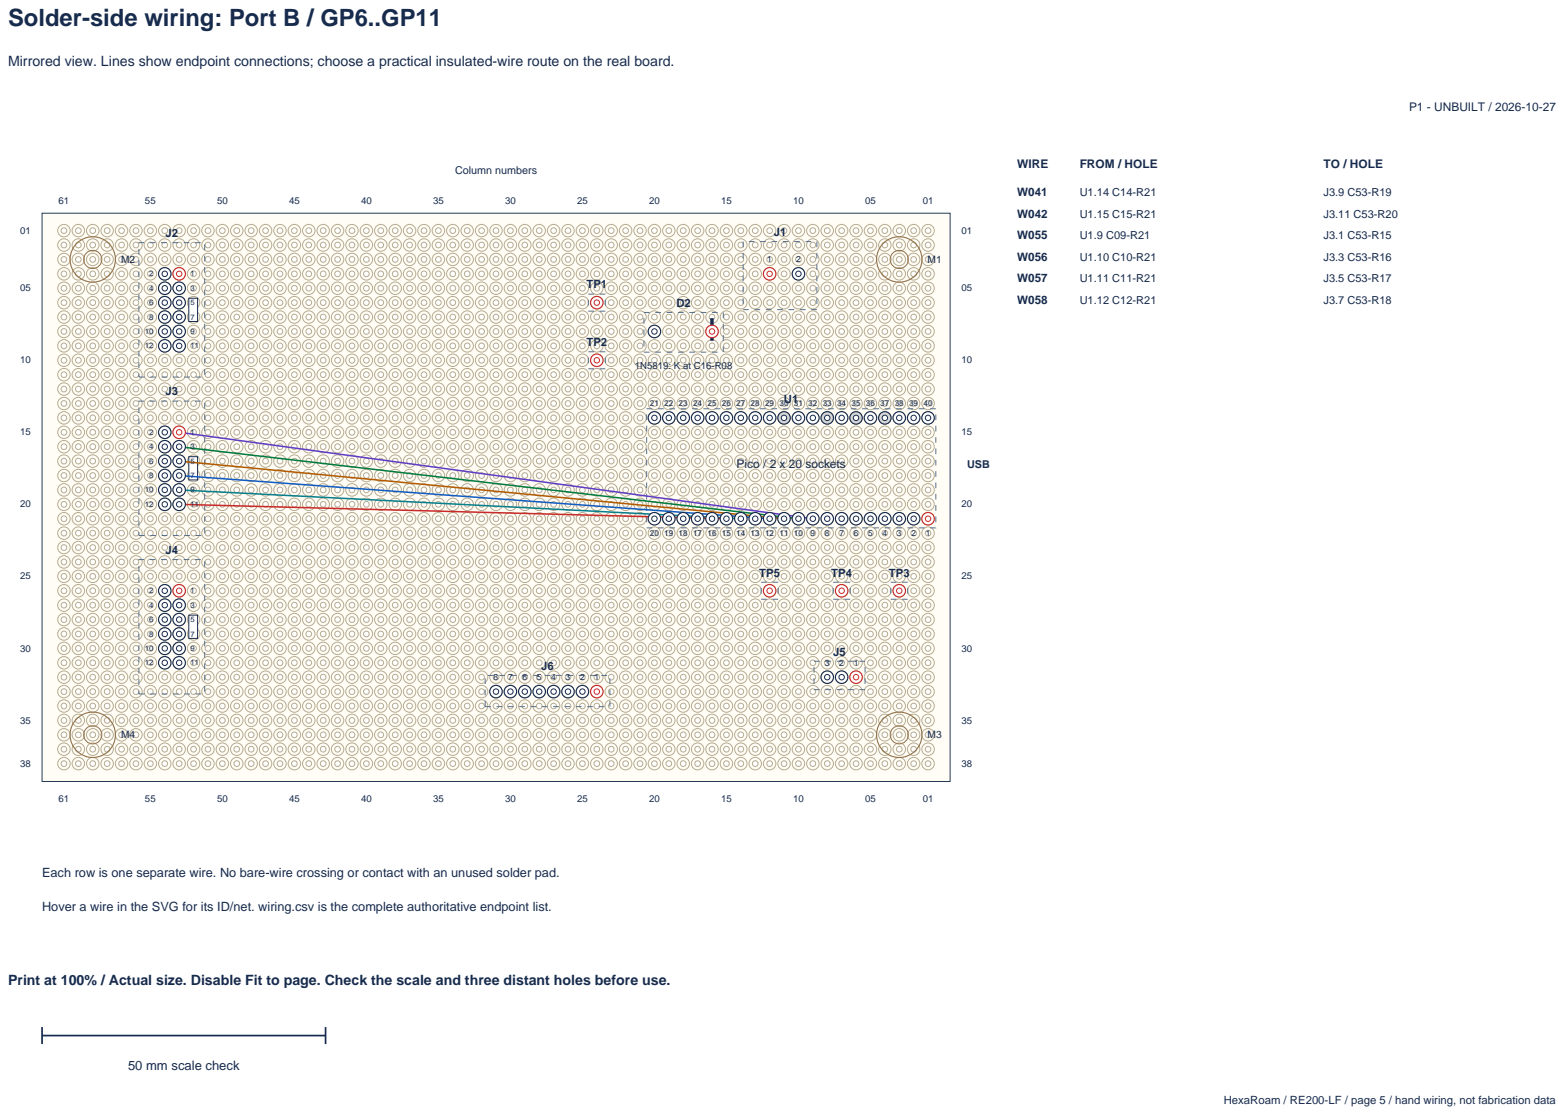
[picture p5: page 5]

Each row is one separate wire. No bare-wire crossing or contact with an unused solder pad.

Hover a wire in the SVG for its ID/net. wiring.csv is the complete authoritative endpoint list.

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

HexaRoam / RE200-LF / page 5 / hand wiring, not fabrication data

# Solder-side wiring: Port C / GP12..GP17

Mirrored view. Lines show endpoint connections; choose a practical insulated-wire route on the real board.

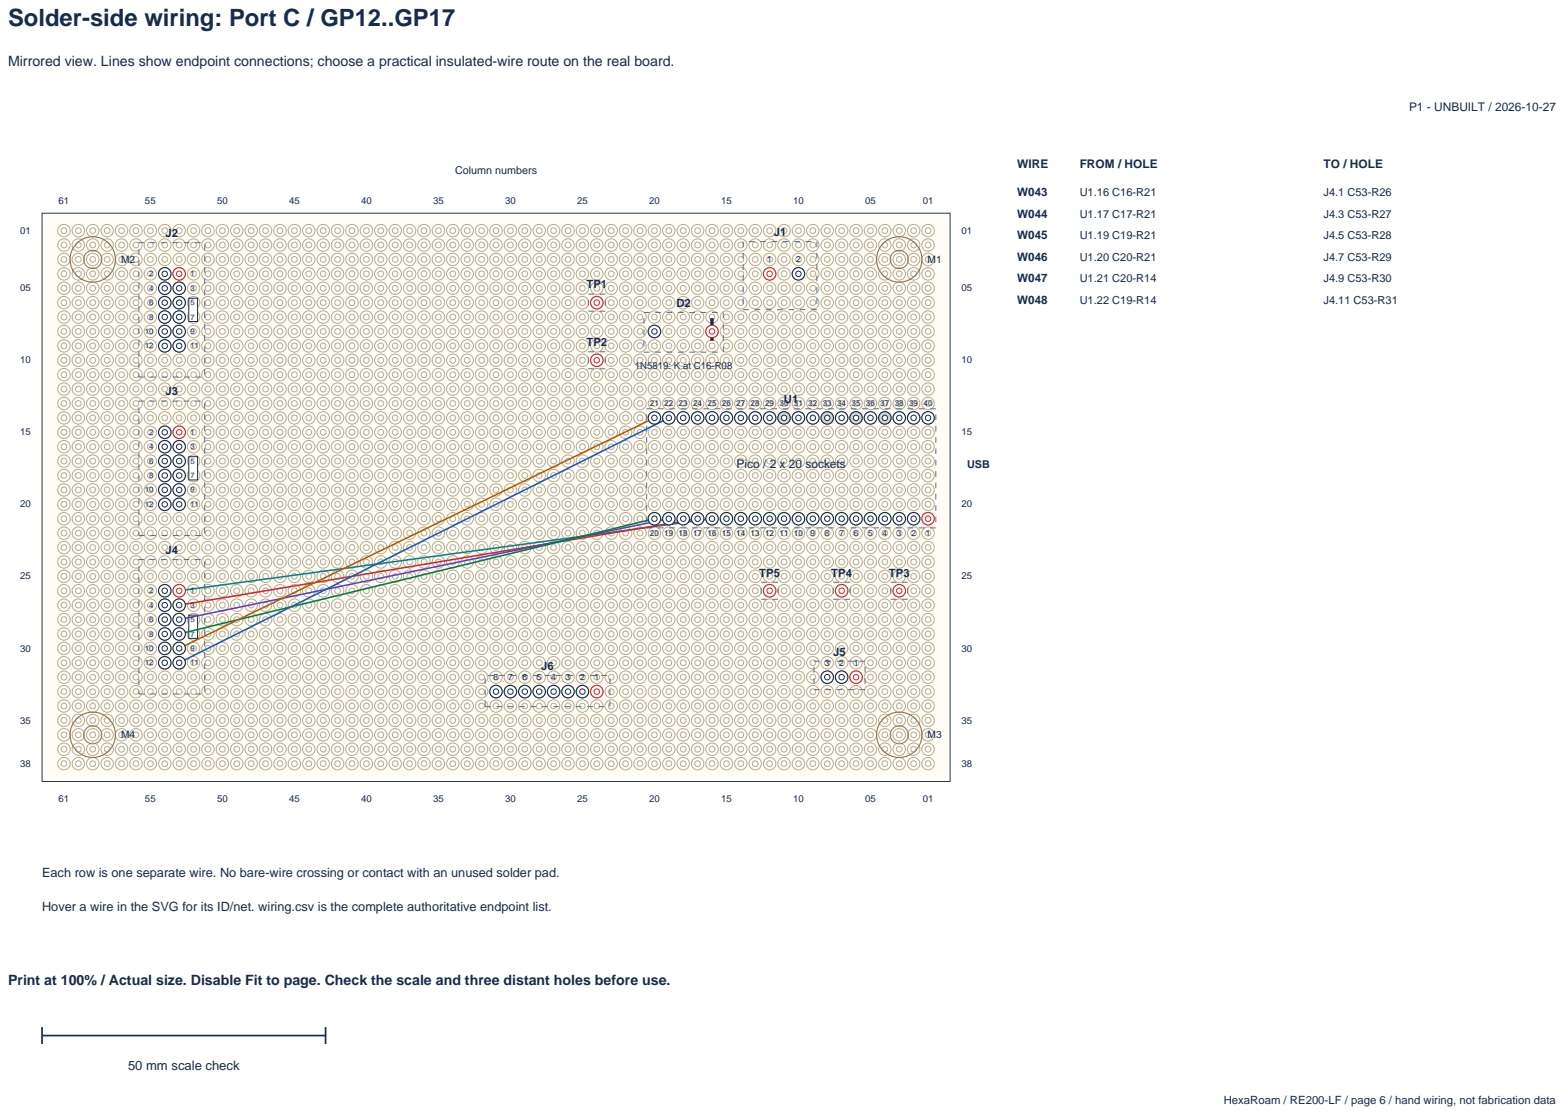
[picture p6: page 6]
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

HexaRoam / RE200-LF / page 6 / hand wiring, not fabrication data

# Solder-side wiring: UART and expansion

Mirrored view. Lines show endpoint connections; choose a practical insulated-wire route on the real board.

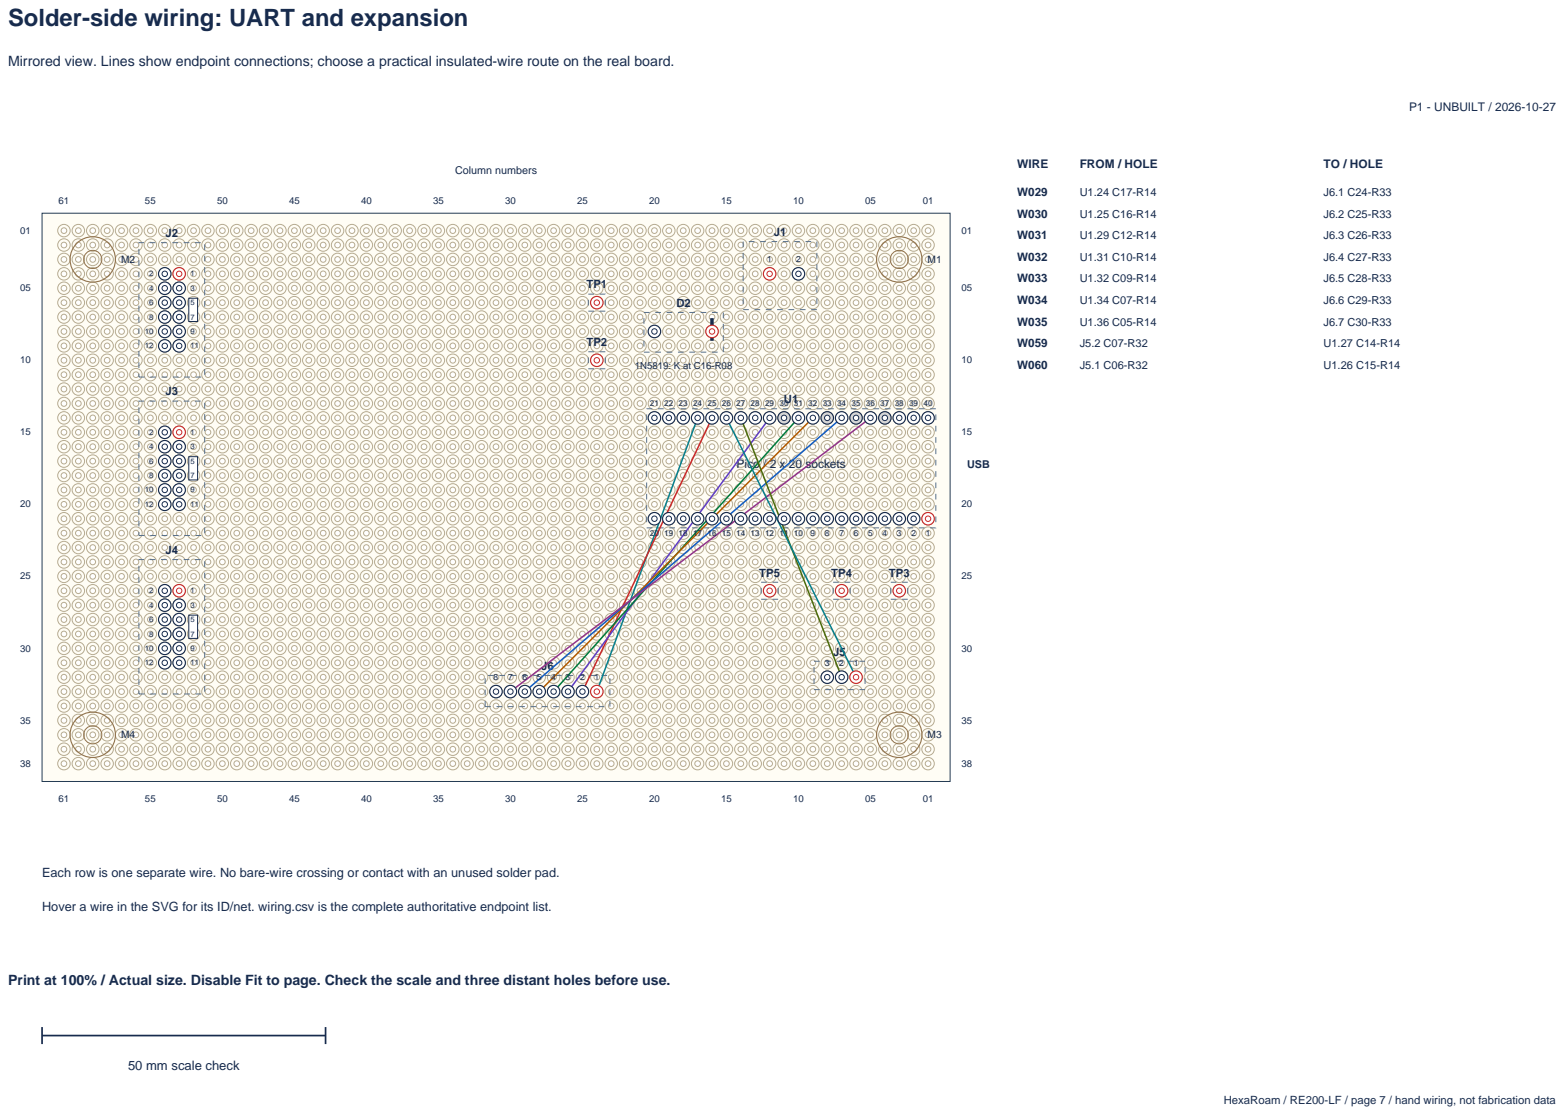
[picture p7: page 7]
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

HexaRoam / RE200-LF / page 7 / hand wiring, not fabrication data
