ebe542/hexaroam/hardware/electronics/servo-output-re200-lf/assembly-guide.pdf

# Servo-output module: component placement

Component side; copper underneath. Green = first assembly. Grey = reserved/DNP. Hole IDs: C(column)-R(row).

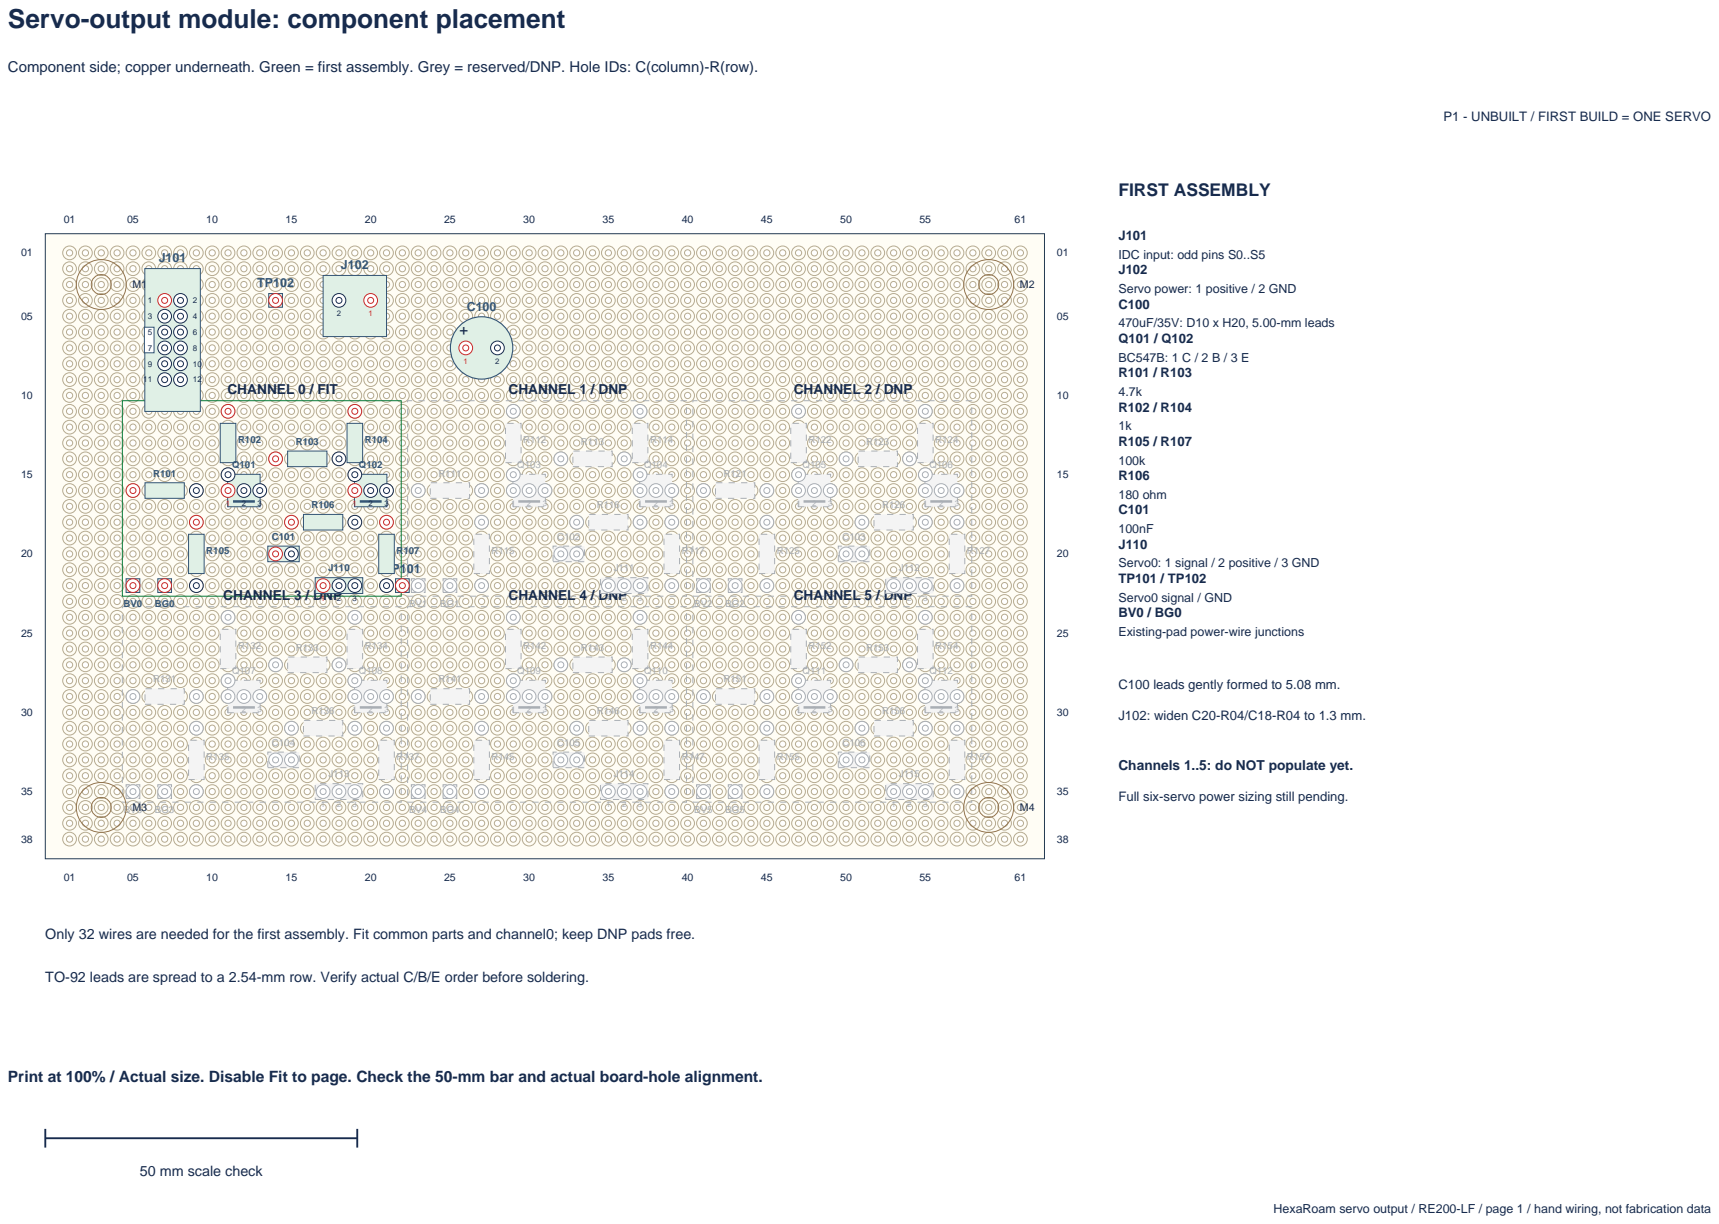
[picture p8: page 1]

P1 - UNBUILT / FIRST BUILD = ONE SERVO

Servo0: 1 signal / 2 positive / 3 GND
Servo0 signal / GND
Existing-pad power-wire junctions

C100 leads gently formed to 5.08 mm.

Channels 1..5: do NOT populate yet.

Full six-servo power sizing still pending.

Only 32 wires are needed for the first assembly. Fit common parts and channel0; keep DNP pads free.

TO-92 leads are spread to a 2.54-mm row. Verify actual C/B/E order before soldering.

Print at 100% / Actual size. Disable Fit to page. Check the 50-mm bar and actual board-hole alignment.

HexaRoam servo output / RE200-LF / page 1 / hand wiring, not fabrication data

# Servo-output module: solder-side reference

Mirrored horizontally. Column61 is at left, column01 at right. Physical hole IDs do not change.

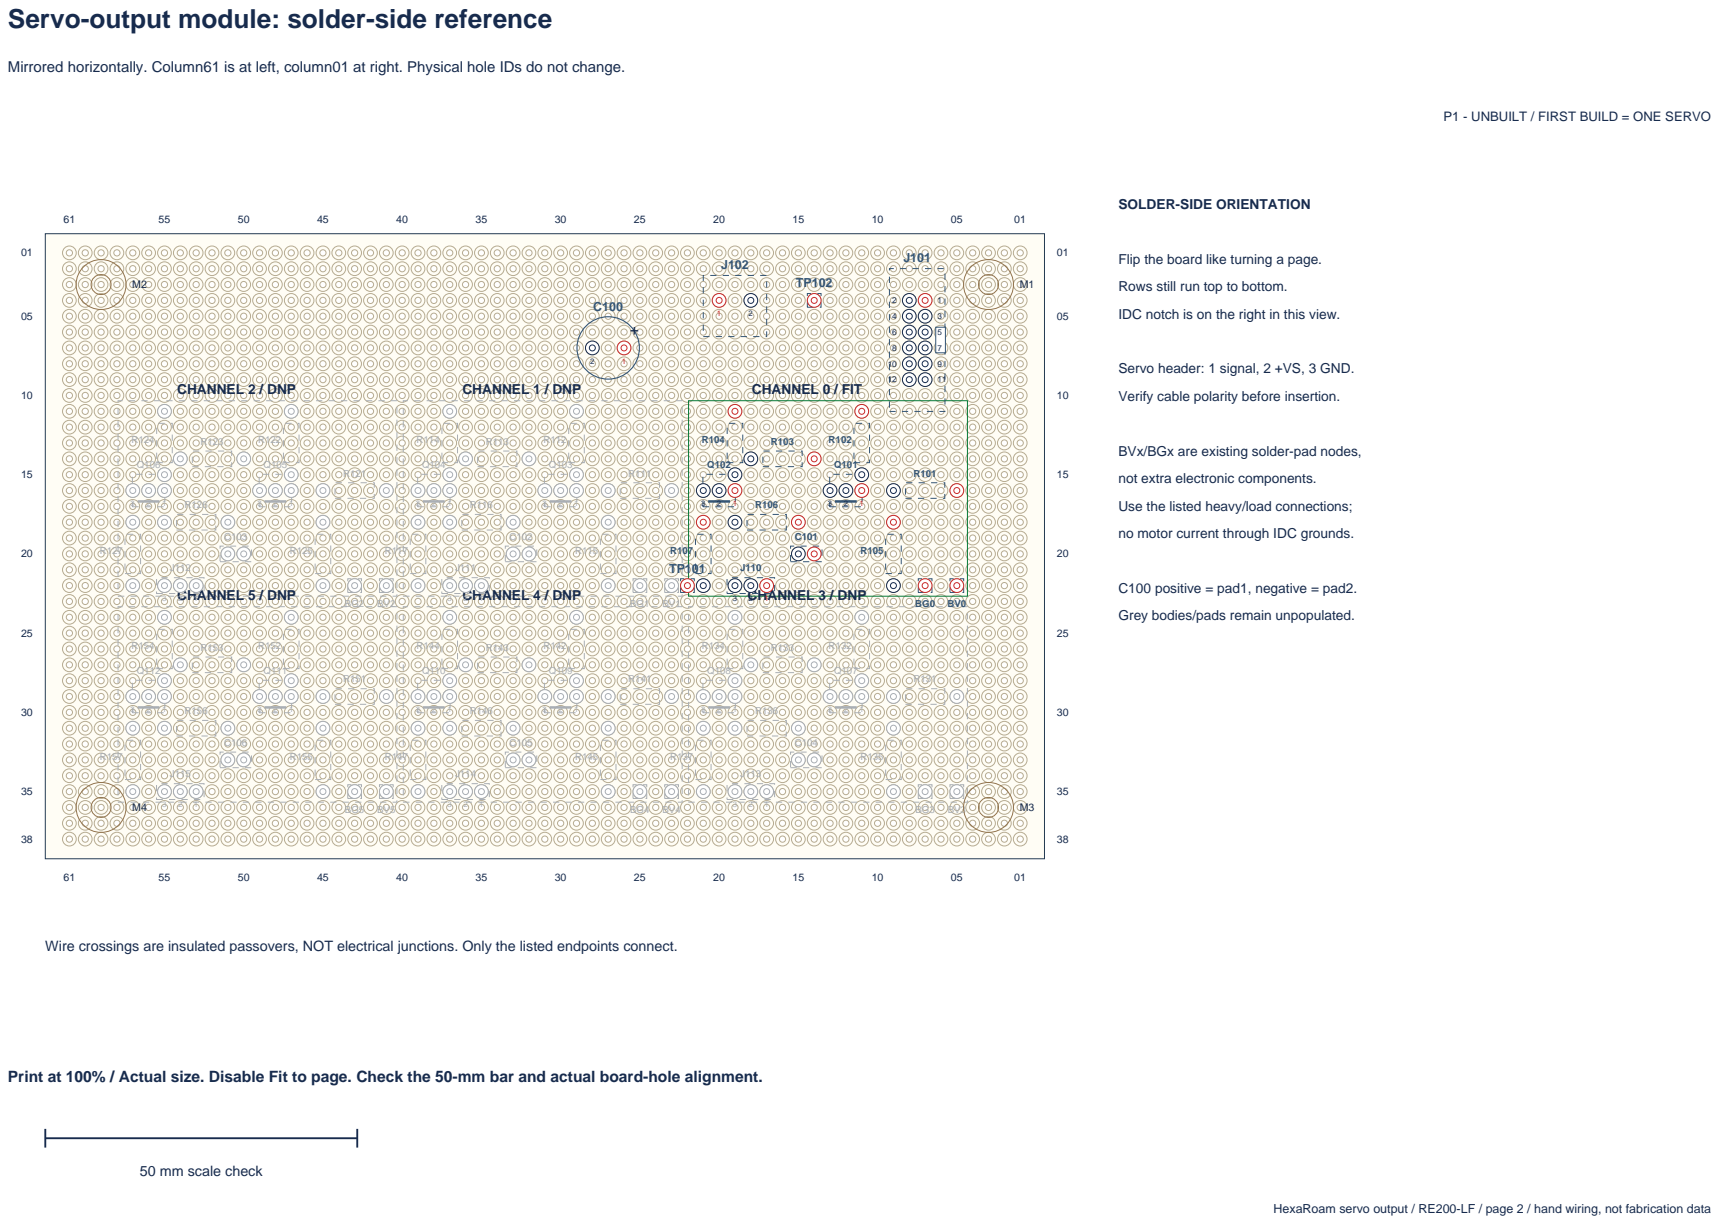
[picture p9: page 2]

P1 - UNBUILT / FIRST BUILD = ONE SERVO

Flip the board like turning a page.
Rows still run top to bottom.
IDC notch is on the right in this view.

Servo header: 1 signal, 2 +VS, 3 GND.
Verify cable polarity before insertion.

BVx/BGx are existing solder-pad nodes,
not extra electronic components.
Use the listed heavy/load connections;
no motor current through IDC grounds.

C100 positive = pad1, negative = pad2.
Grey bodies/pads remain unpopulated.

Wire crossings are insulated passovers, NOT electrical junctions. Only the listed endpoints connect.

Print at 100% / Actual size. Disable Fit to page. Check the 50-mm bar and actual board-hole alignment.

HexaRoam servo output / RE200-LF / page 2 / hand wiring, not fabrication data

# Solder-side wiring: FIRST BUILD: power / ground

Mirrored view. Endpoint guide only: route insulated wires clear of sharp leads and mounting hardware.

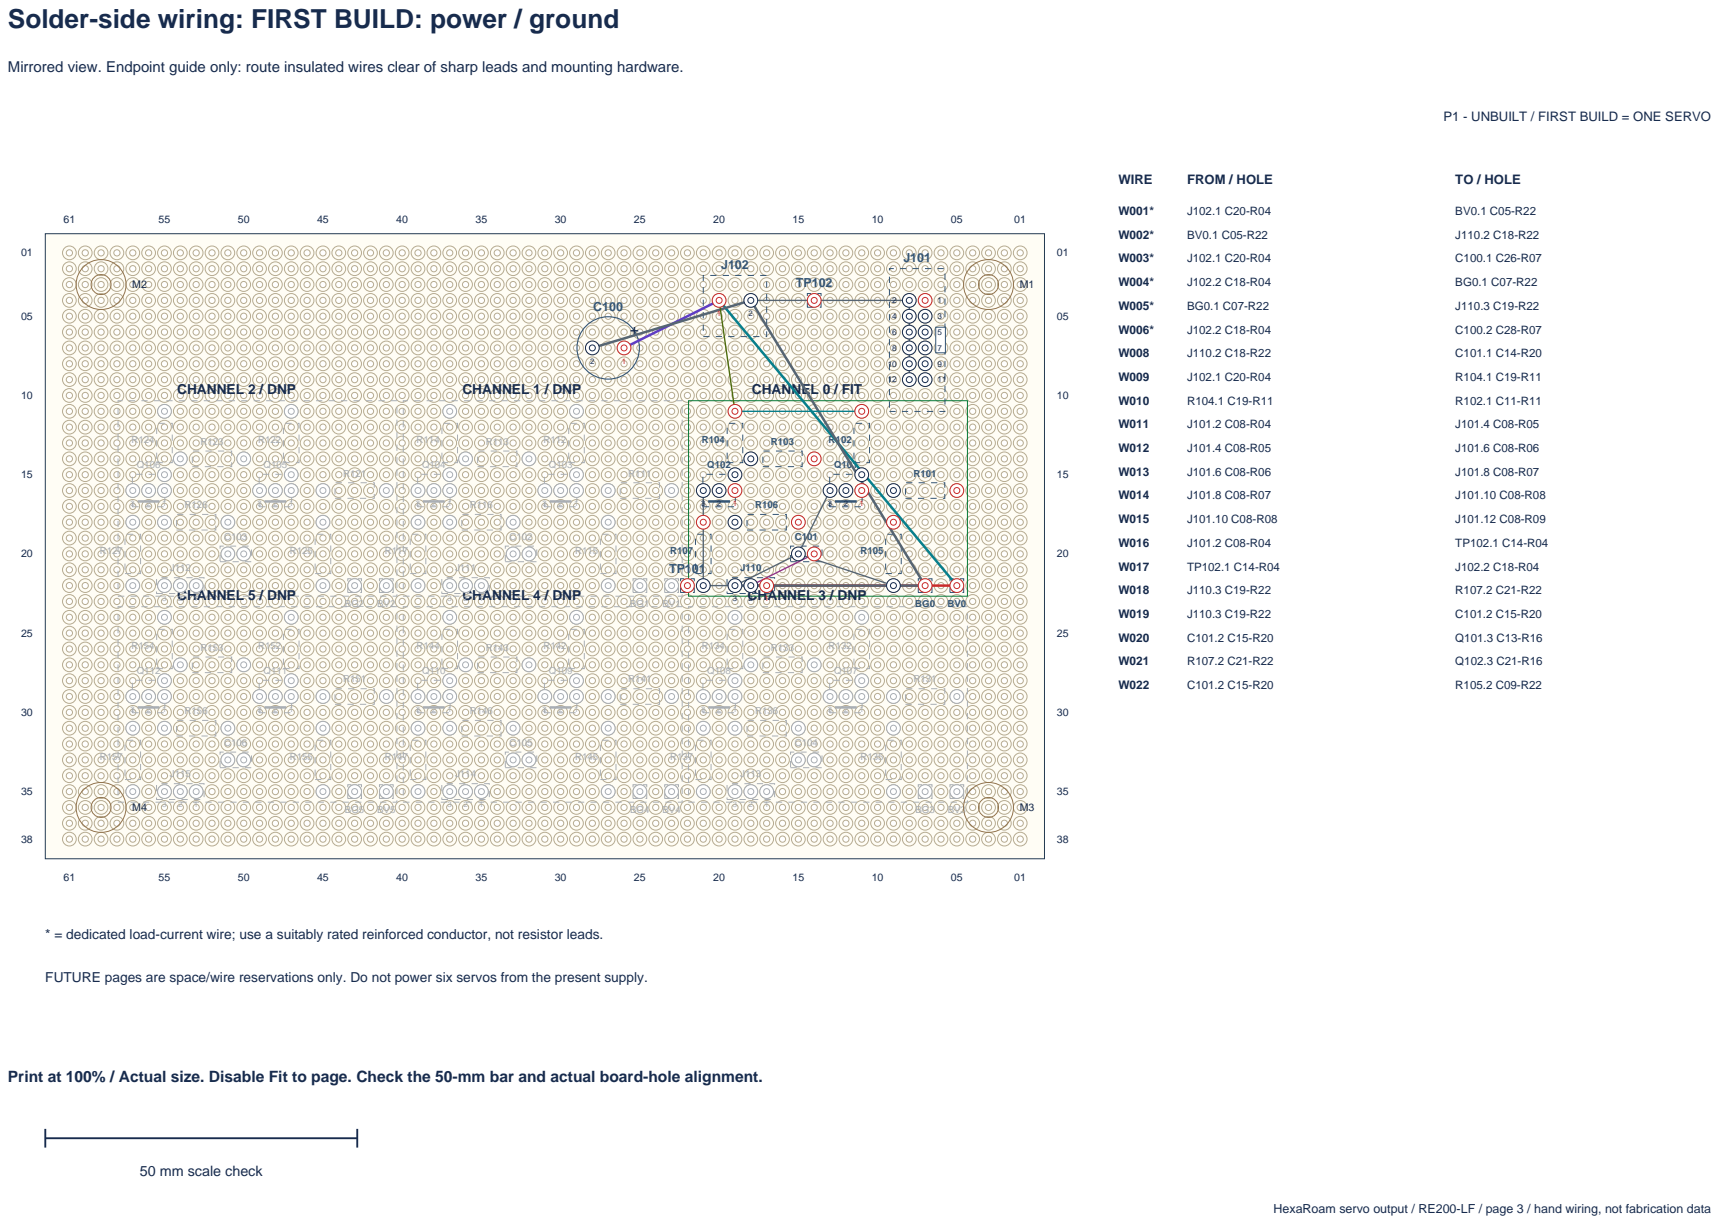
[picture p10: page 3]

P1 - UNBUILT / FIRST BUILD = ONE SERVO

* = dedicated load-current wire; use a suitably rated reinforced conductor, not resistor leads.

FUTURE pages are space/wire reservations only. Do not power six servos from the present supply.

Print at 100% / Actual size. Disable Fit to page. Check the 50-mm bar and actual board-hole alignment.

HexaRoam servo output / RE200-LF / page 3 / hand wiring, not fabrication data

# Solder-side wiring: FIRST BUILD: channel0 logic

Mirrored view. Endpoint guide only: route insulated wires clear of sharp leads and mounting hardware.

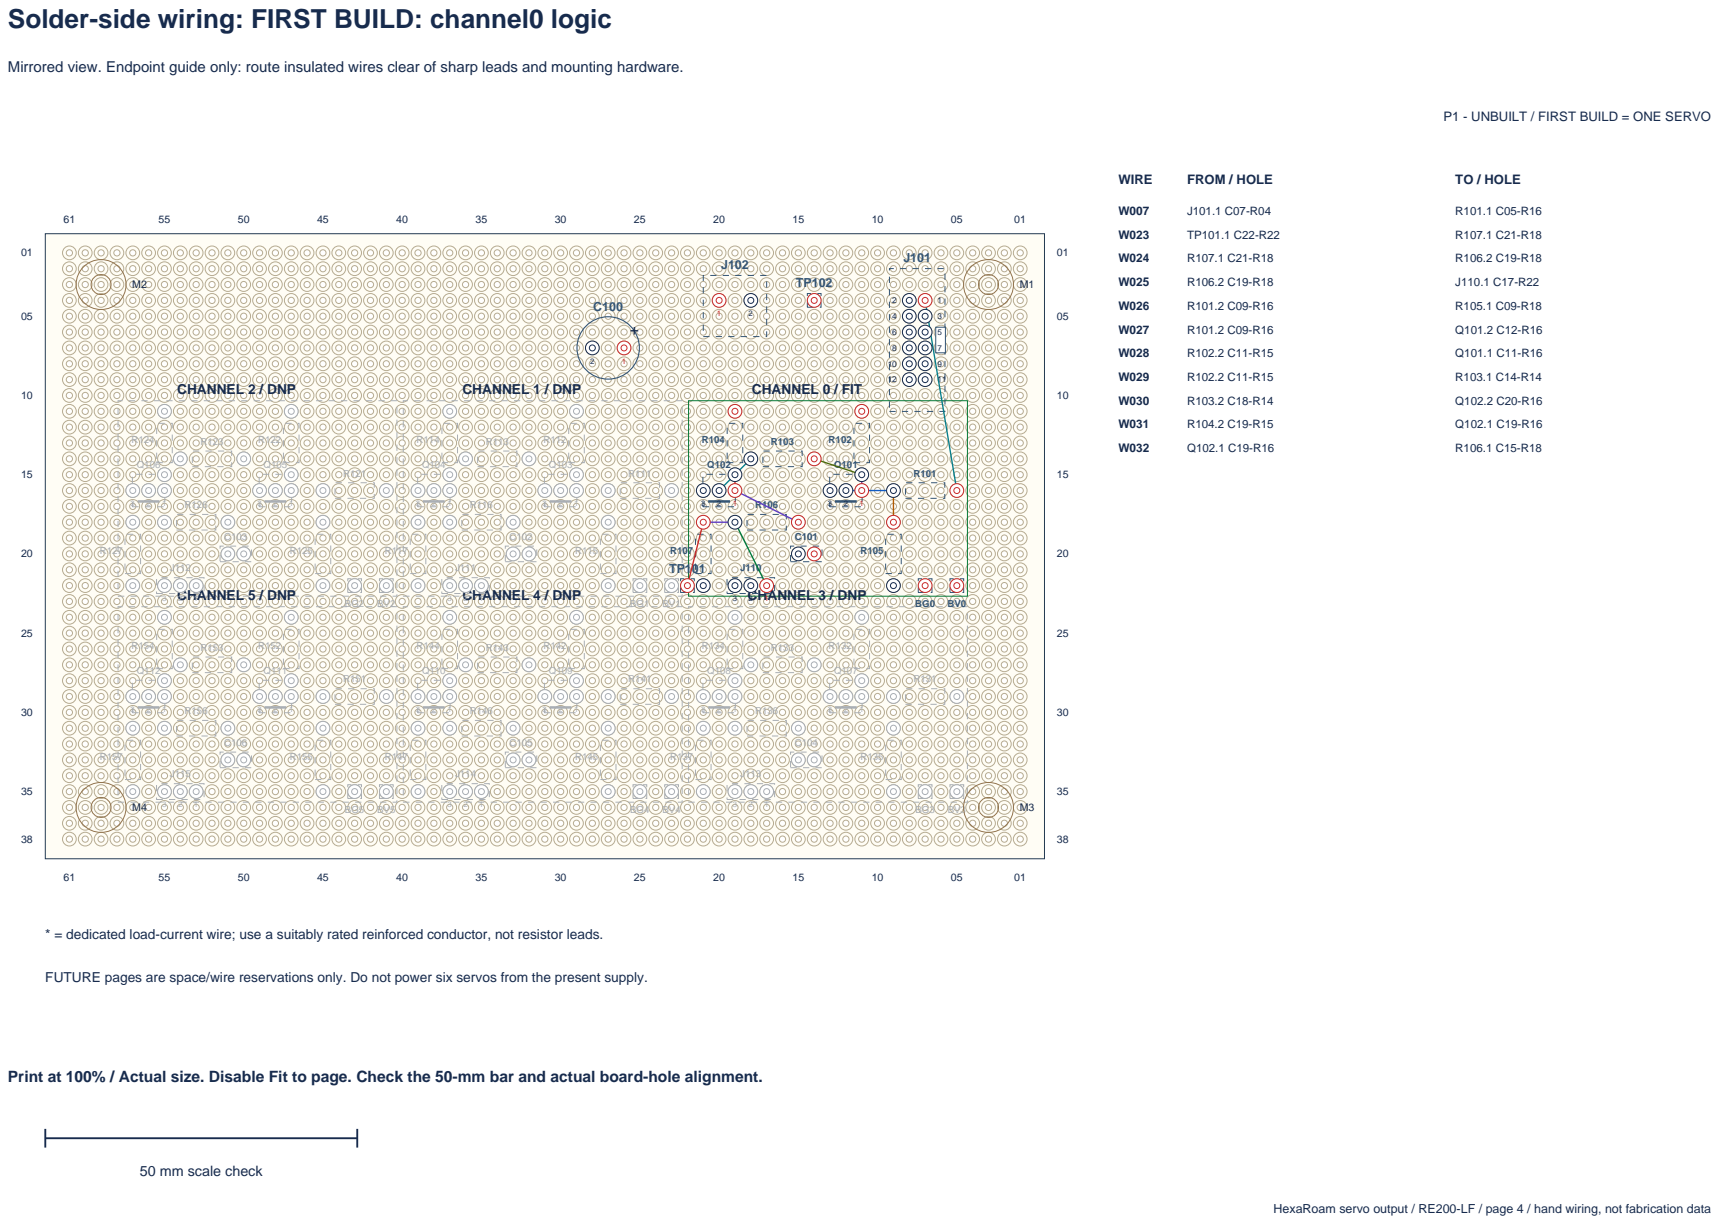
[picture p11: page 4]

P1 - UNBUILT / FIRST BUILD = ONE SERVO

* = dedicated load-current wire; use a suitably rated reinforced conductor, not resistor leads.

FUTURE pages are space/wire reservations only. Do not power six servos from the present supply.

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

HexaRoam servo output / RE200-LF / page 4 / hand wiring, not fabrication data

# Solder-side wiring: FUTURE ONLY: power expansion / 1

Mirrored view. Endpoint guide only: route insulated wires clear of sharp leads and mounting hardware.

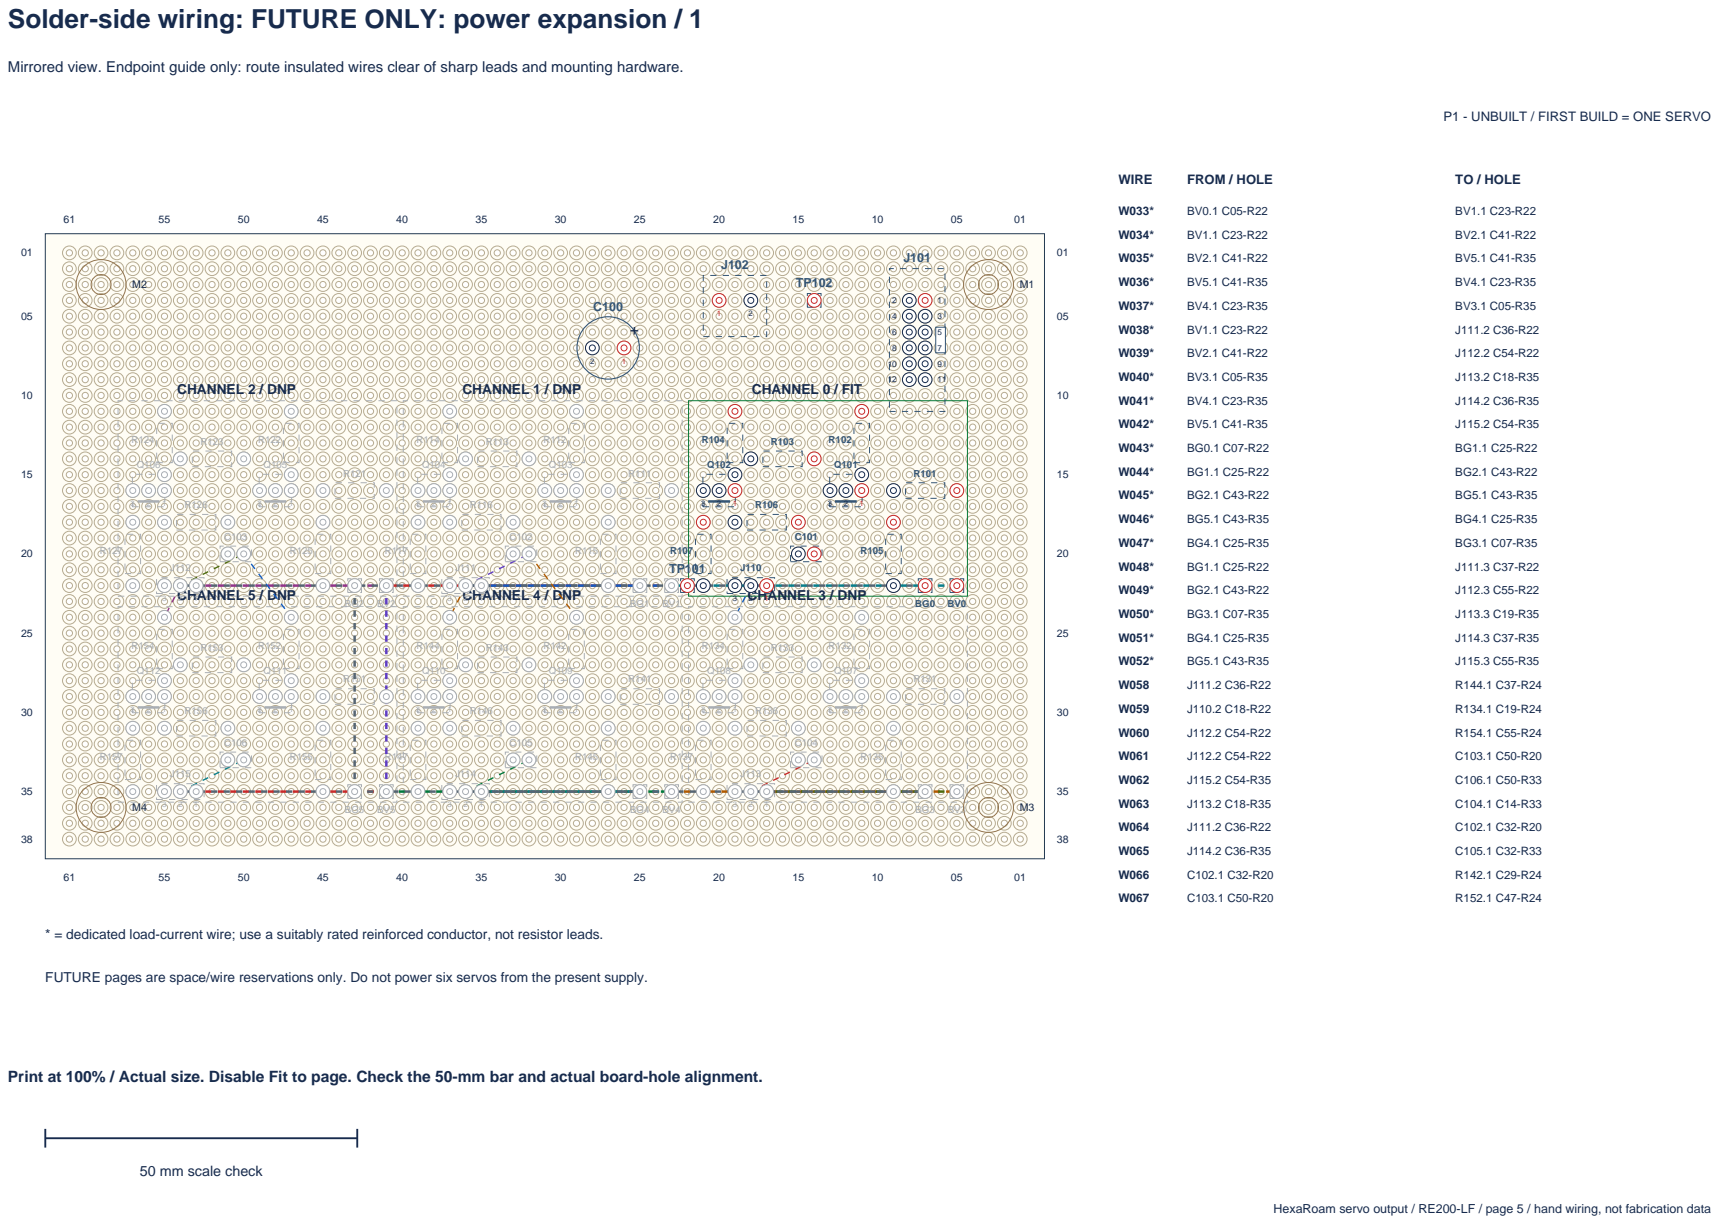
[picture p12: page 5]

P1 - UNBUILT / FIRST BUILD = ONE SERVO

* = dedicated load-current wire; use a suitably rated reinforced conductor, not resistor leads.

FUTURE pages are space/wire reservations only. Do not power six servos from the present supply.

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

HexaRoam servo output / RE200-LF / page 5 / hand wiring, not fabrication data

# Solder-side wiring: FUTURE ONLY: power expansion / 2

Mirrored view. Endpoint guide only: route insulated wires clear of sharp leads and mounting hardware.

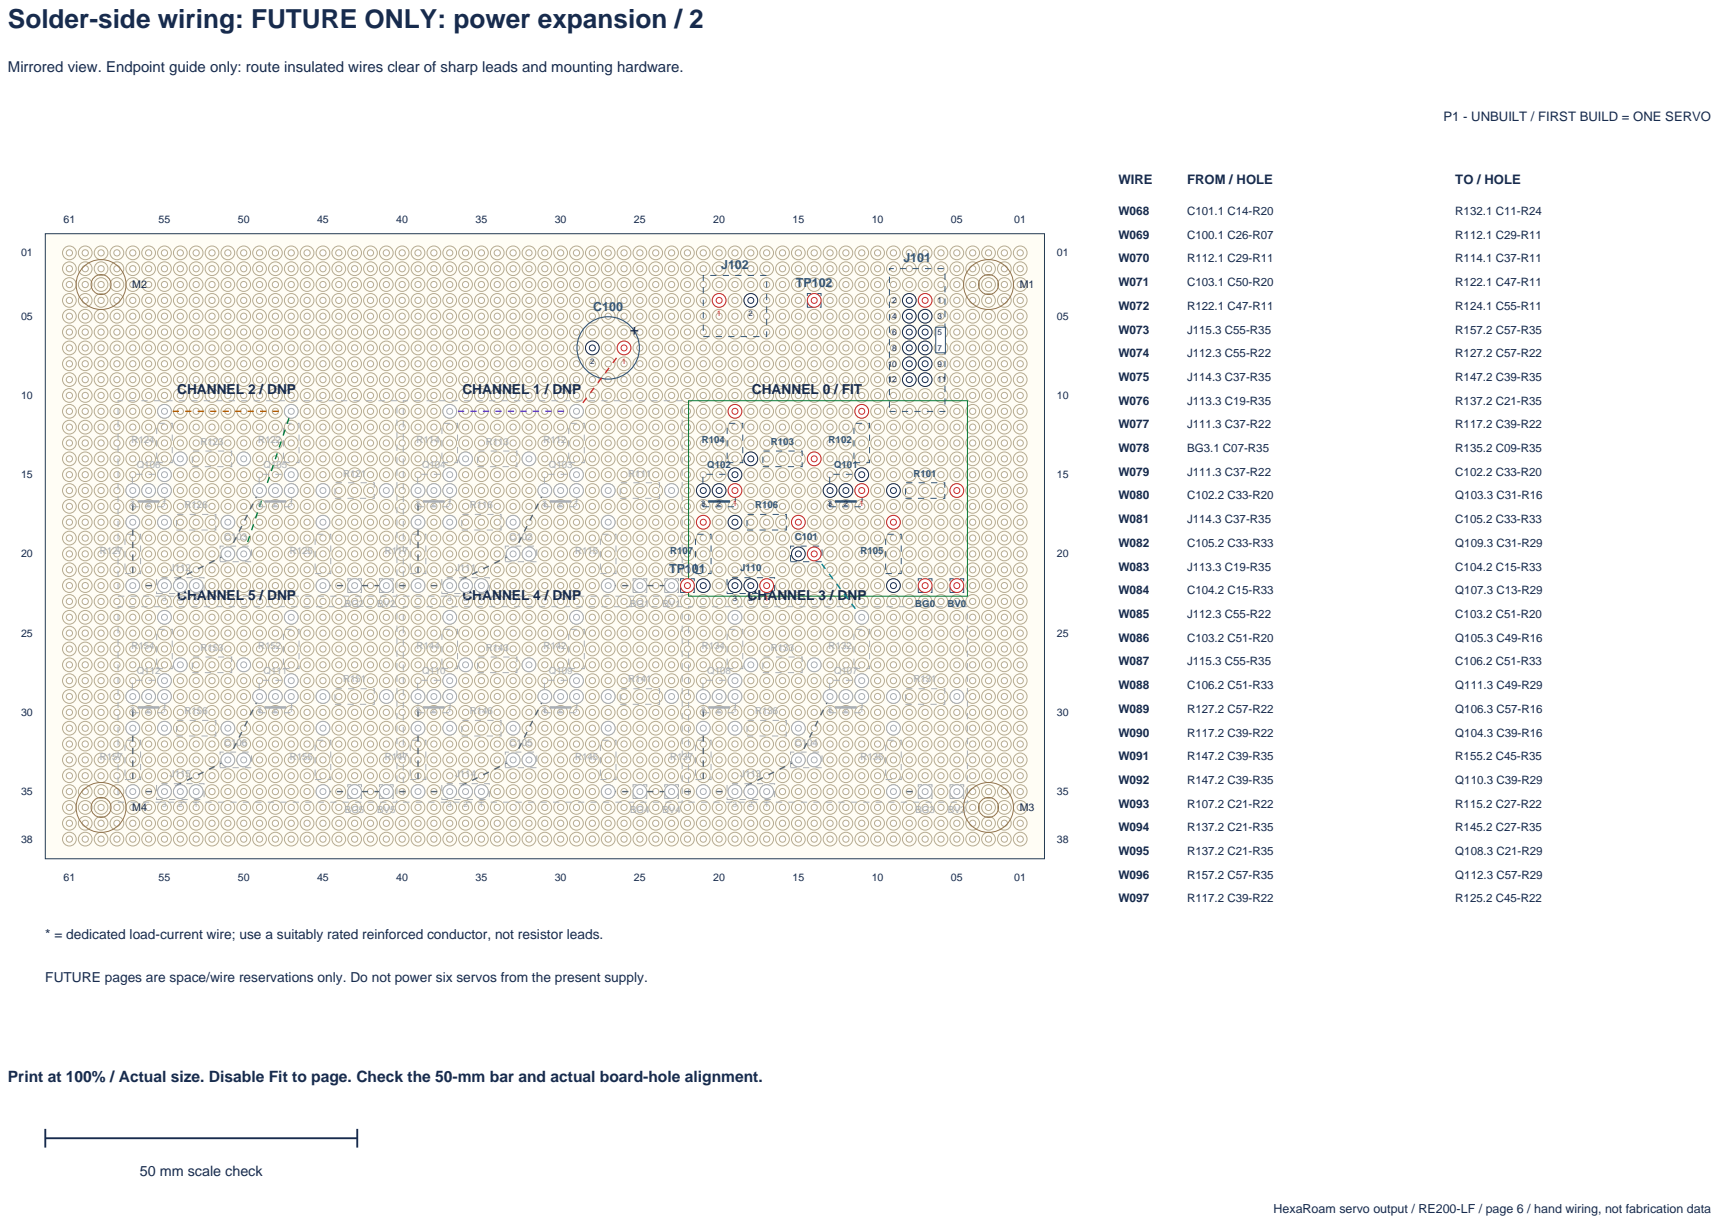
[picture p13: page 6]

P1 - UNBUILT / FIRST BUILD = ONE SERVO

* = dedicated load-current wire; use a suitably rated reinforced conductor, not resistor leads.

FUTURE pages are space/wire reservations only. Do not power six servos from the present supply.

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

HexaRoam servo output / RE200-LF / page 6 / hand wiring, not fabrication data

# Solder-side wiring: FUTURE ONLY: channel1 logic

Mirrored view. Endpoint guide only: route insulated wires clear of sharp leads and mounting hardware.

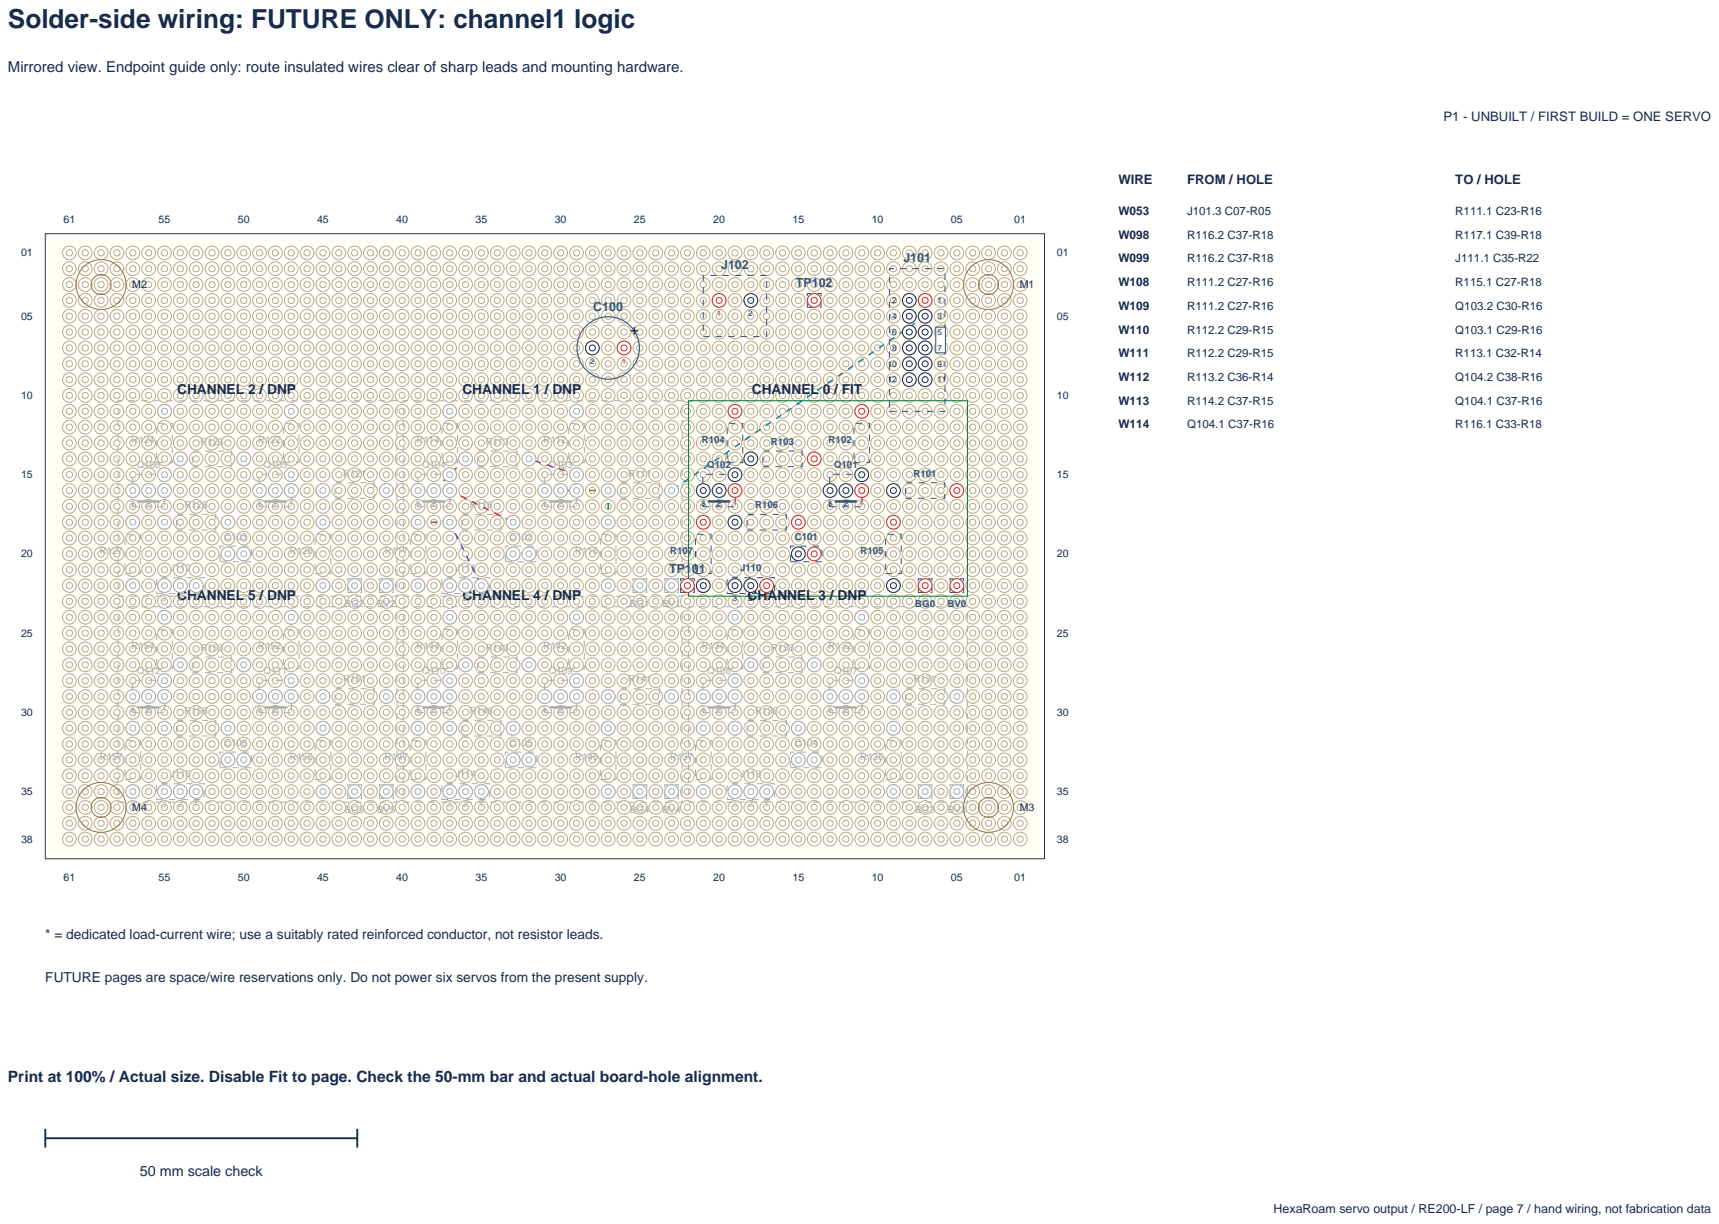
[picture p14: page 7]

P1 - UNBUILT / FIRST BUILD = ONE SERVO

* = dedicated load-current wire; use a suitably rated reinforced conductor, not resistor leads.

FUTURE pages are space/wire reservations only. Do not power six servos from the present supply.

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

HexaRoam servo output / RE200-LF / page 7 / hand wiring, not fabrication data

# Solder-side wiring: FUTURE ONLY: channel2 logic

Mirrored view. Endpoint guide only: route insulated wires clear of sharp leads and mounting hardware.

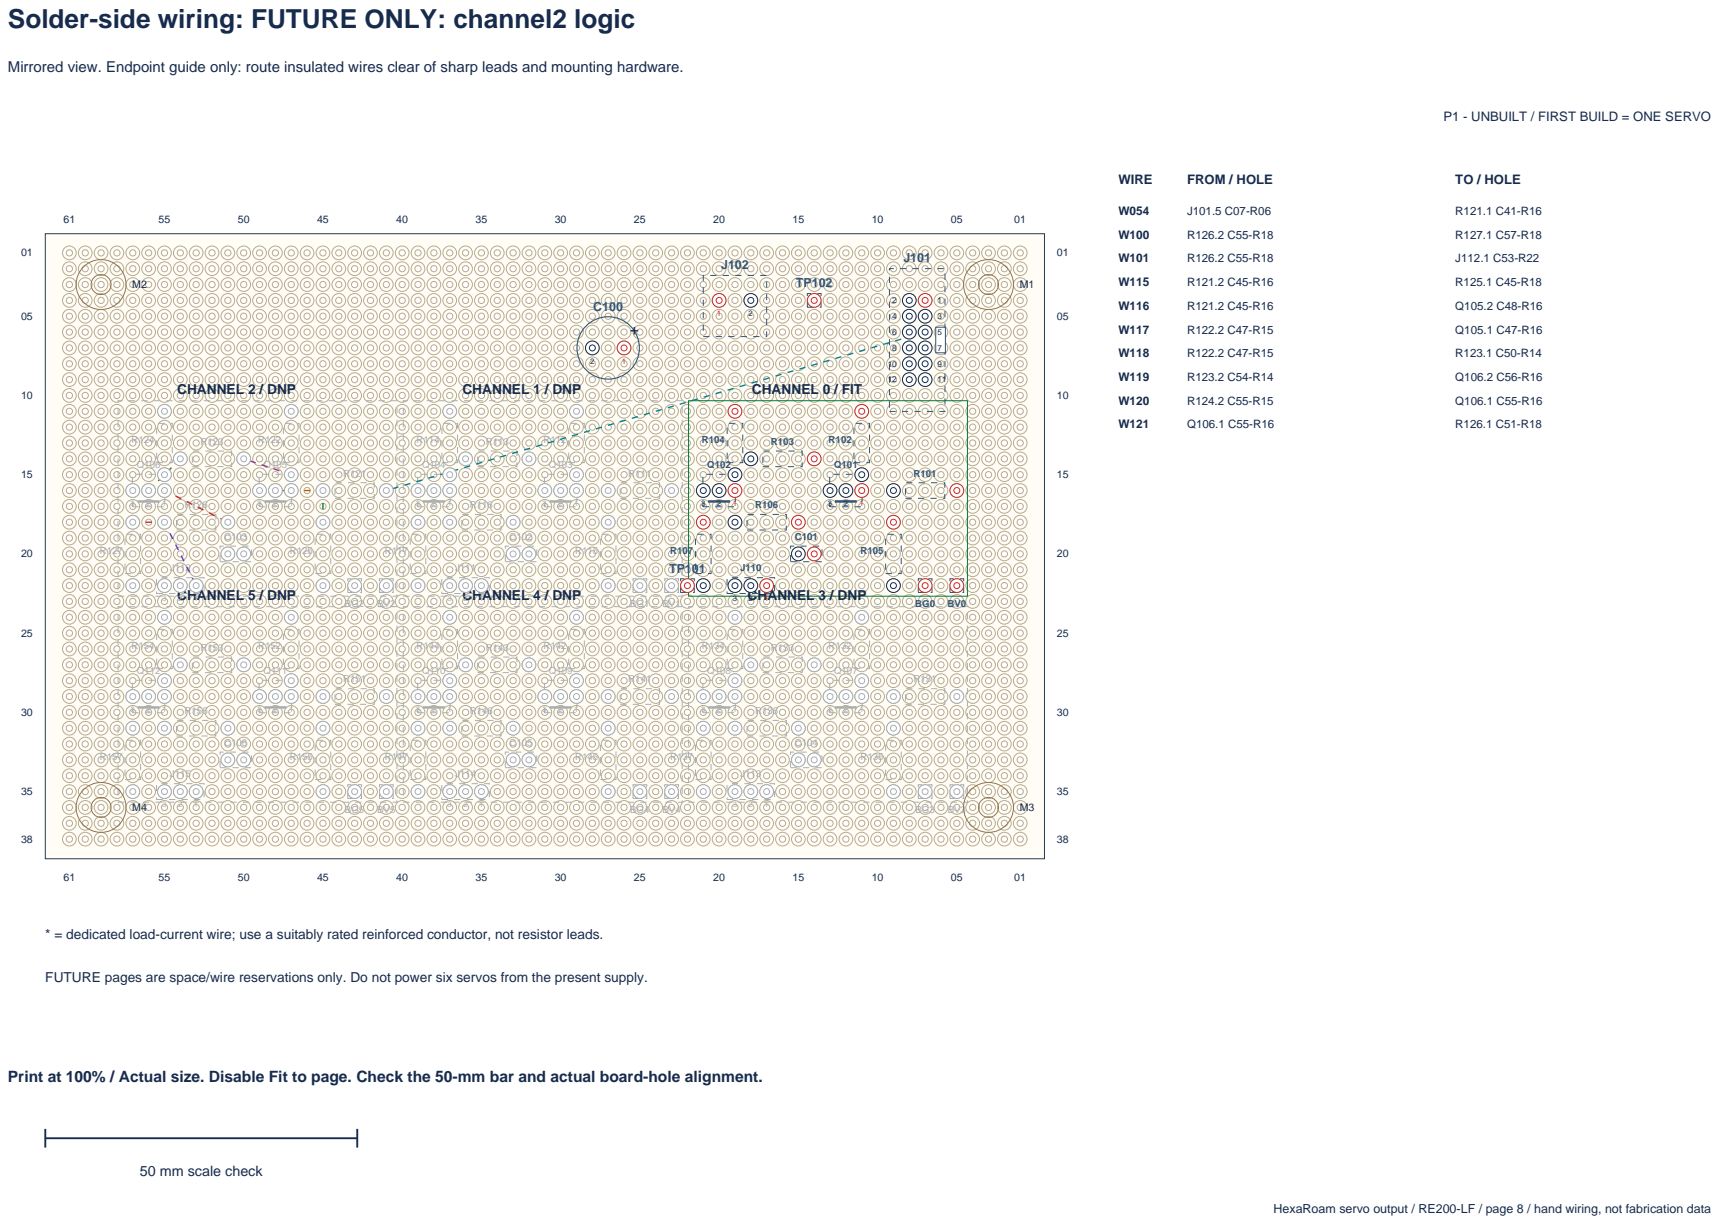
[picture p15: page 8]

P1 - UNBUILT / FIRST BUILD = ONE SERVO

* = dedicated load-current wire; use a suitably rated reinforced conductor, not resistor leads.

FUTURE pages are space/wire reservations only. Do not power six servos from the present supply.

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

HexaRoam servo output / RE200-LF / page 8 / hand wiring, not fabrication data

# Solder-side wiring: FUTURE ONLY: channel3 logic

Mirrored view. Endpoint guide only: route insulated wires clear of sharp leads and mounting hardware.

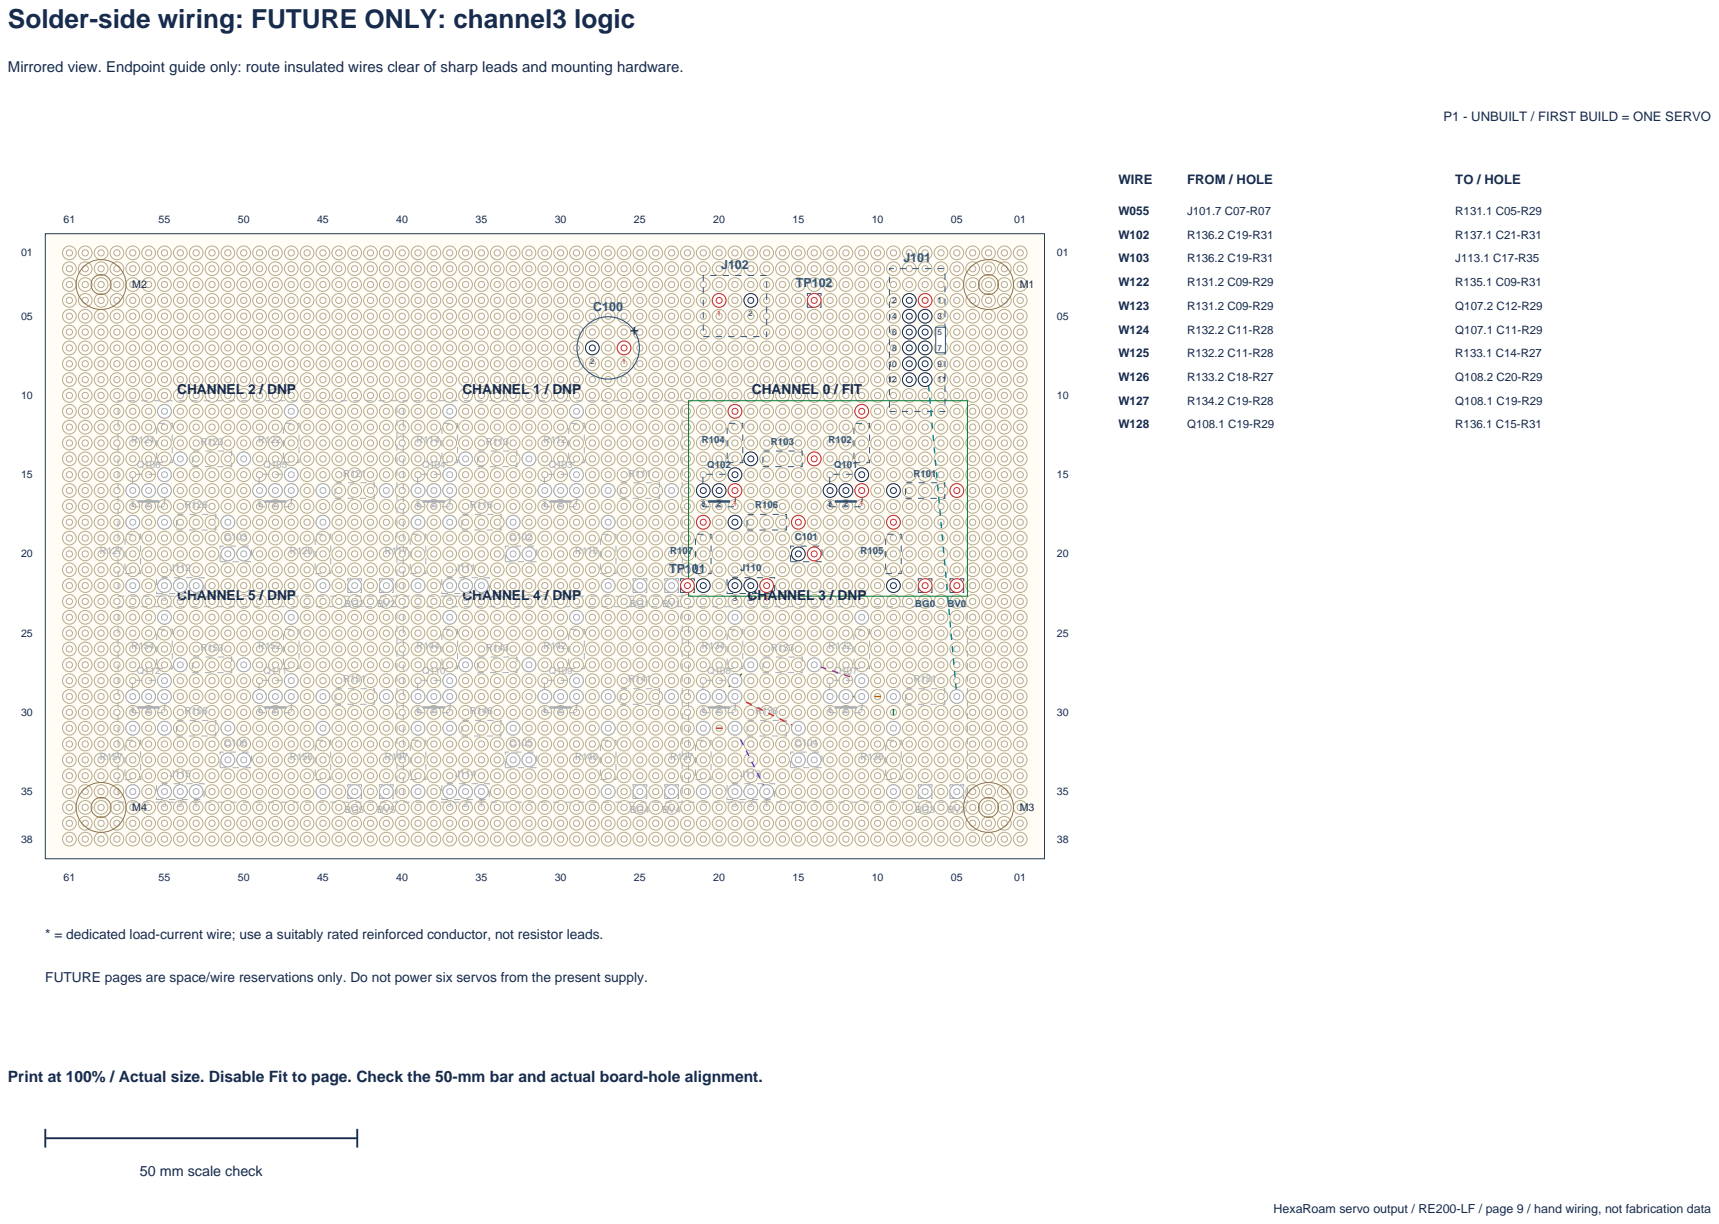
[picture p16: page 9]

P1 - UNBUILT / FIRST BUILD = ONE SERVO

* = dedicated load-current wire; use a suitably rated reinforced conductor, not resistor leads.

FUTURE pages are space/wire reservations only. Do not power six servos from the present supply.

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

HexaRoam servo output / RE200-LF / page 9 / hand wiring, not fabrication data

# Solder-side wiring: FUTURE ONLY: channel4 logic

Mirrored view. Endpoint guide only: route insulated wires clear of sharp leads and mounting hardware.

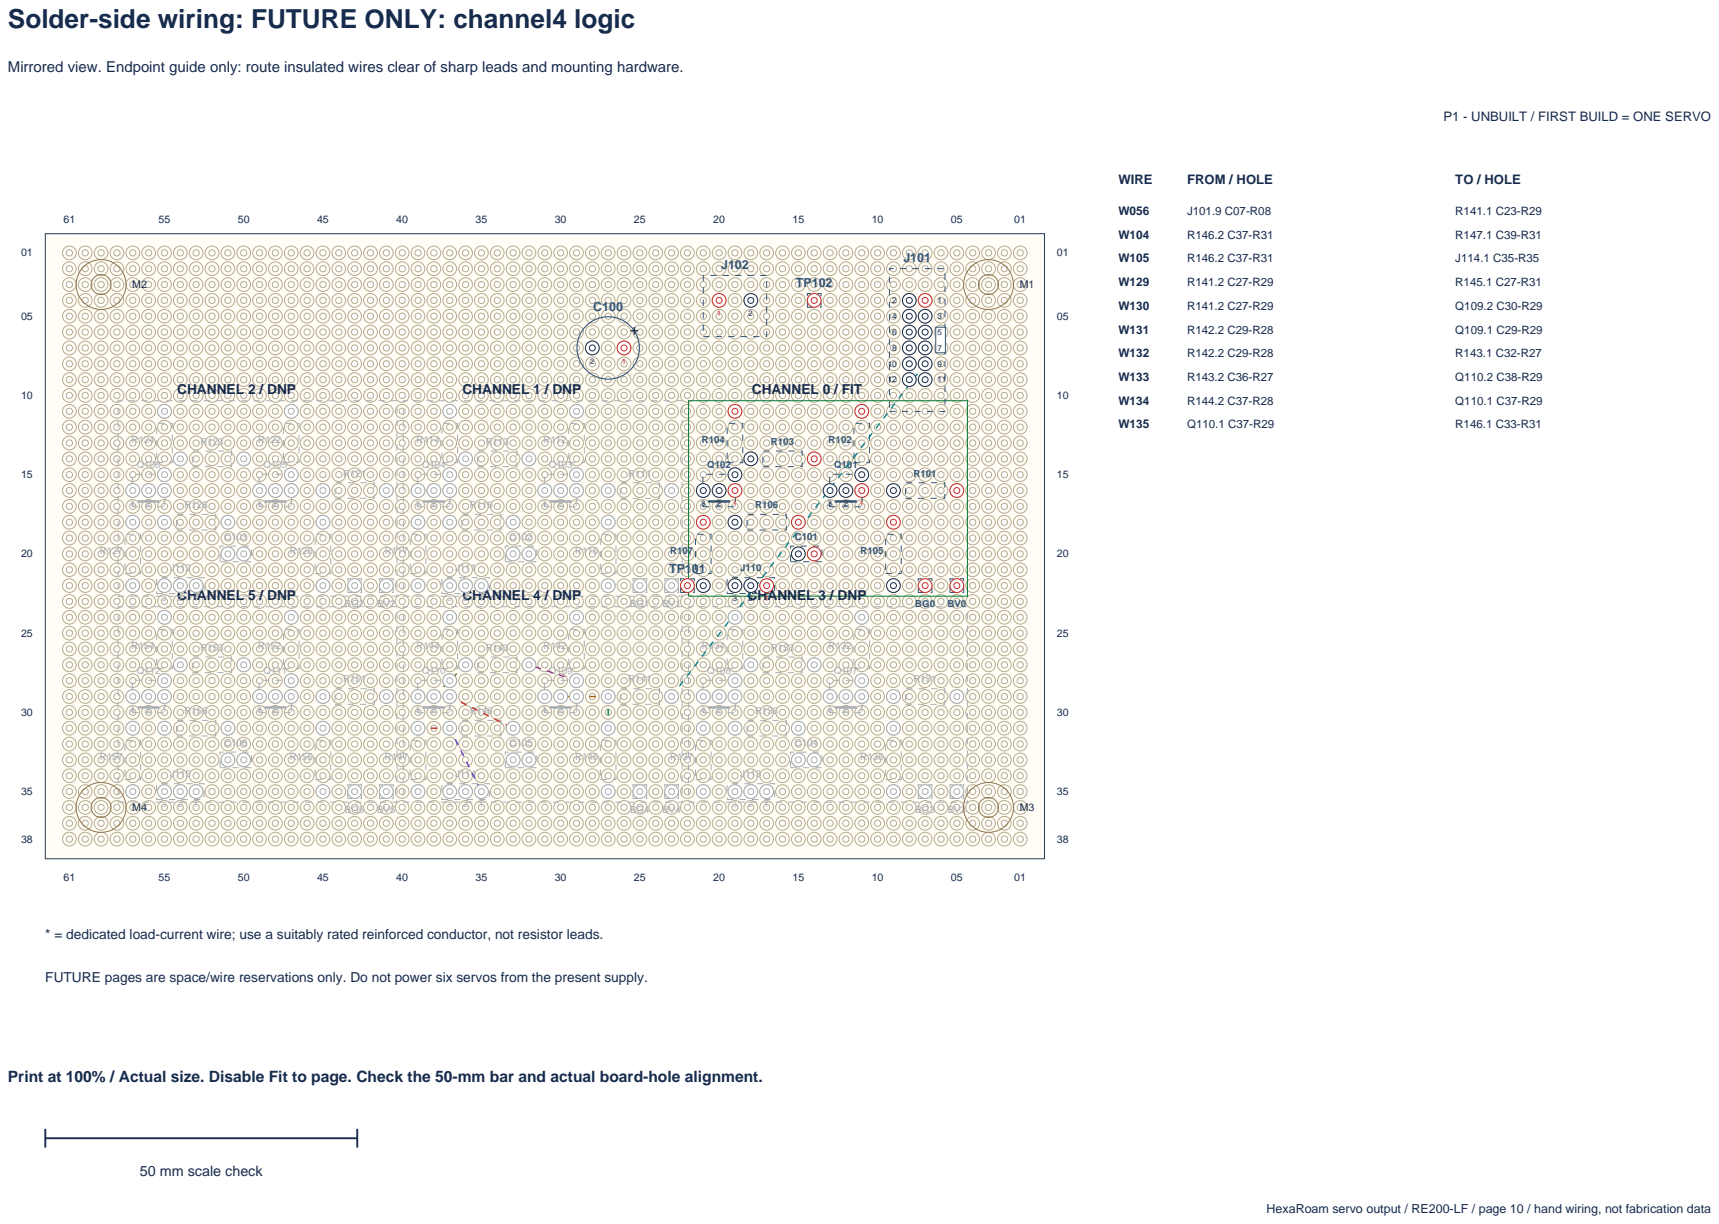
[picture p17: page 10]

P1 - UNBUILT / FIRST BUILD = ONE SERVO

* = dedicated load-current wire; use a suitably rated reinforced conductor, not resistor leads.

FUTURE pages are space/wire reservations only. Do not power six servos from the present supply.

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

HexaRoam servo output / RE200-LF / page 10 / hand wiring, not fabrication data

# Solder-side wiring: FUTURE ONLY: channel5 logic

Mirrored view. Endpoint guide only: route insulated wires clear of sharp leads and mounting hardware.

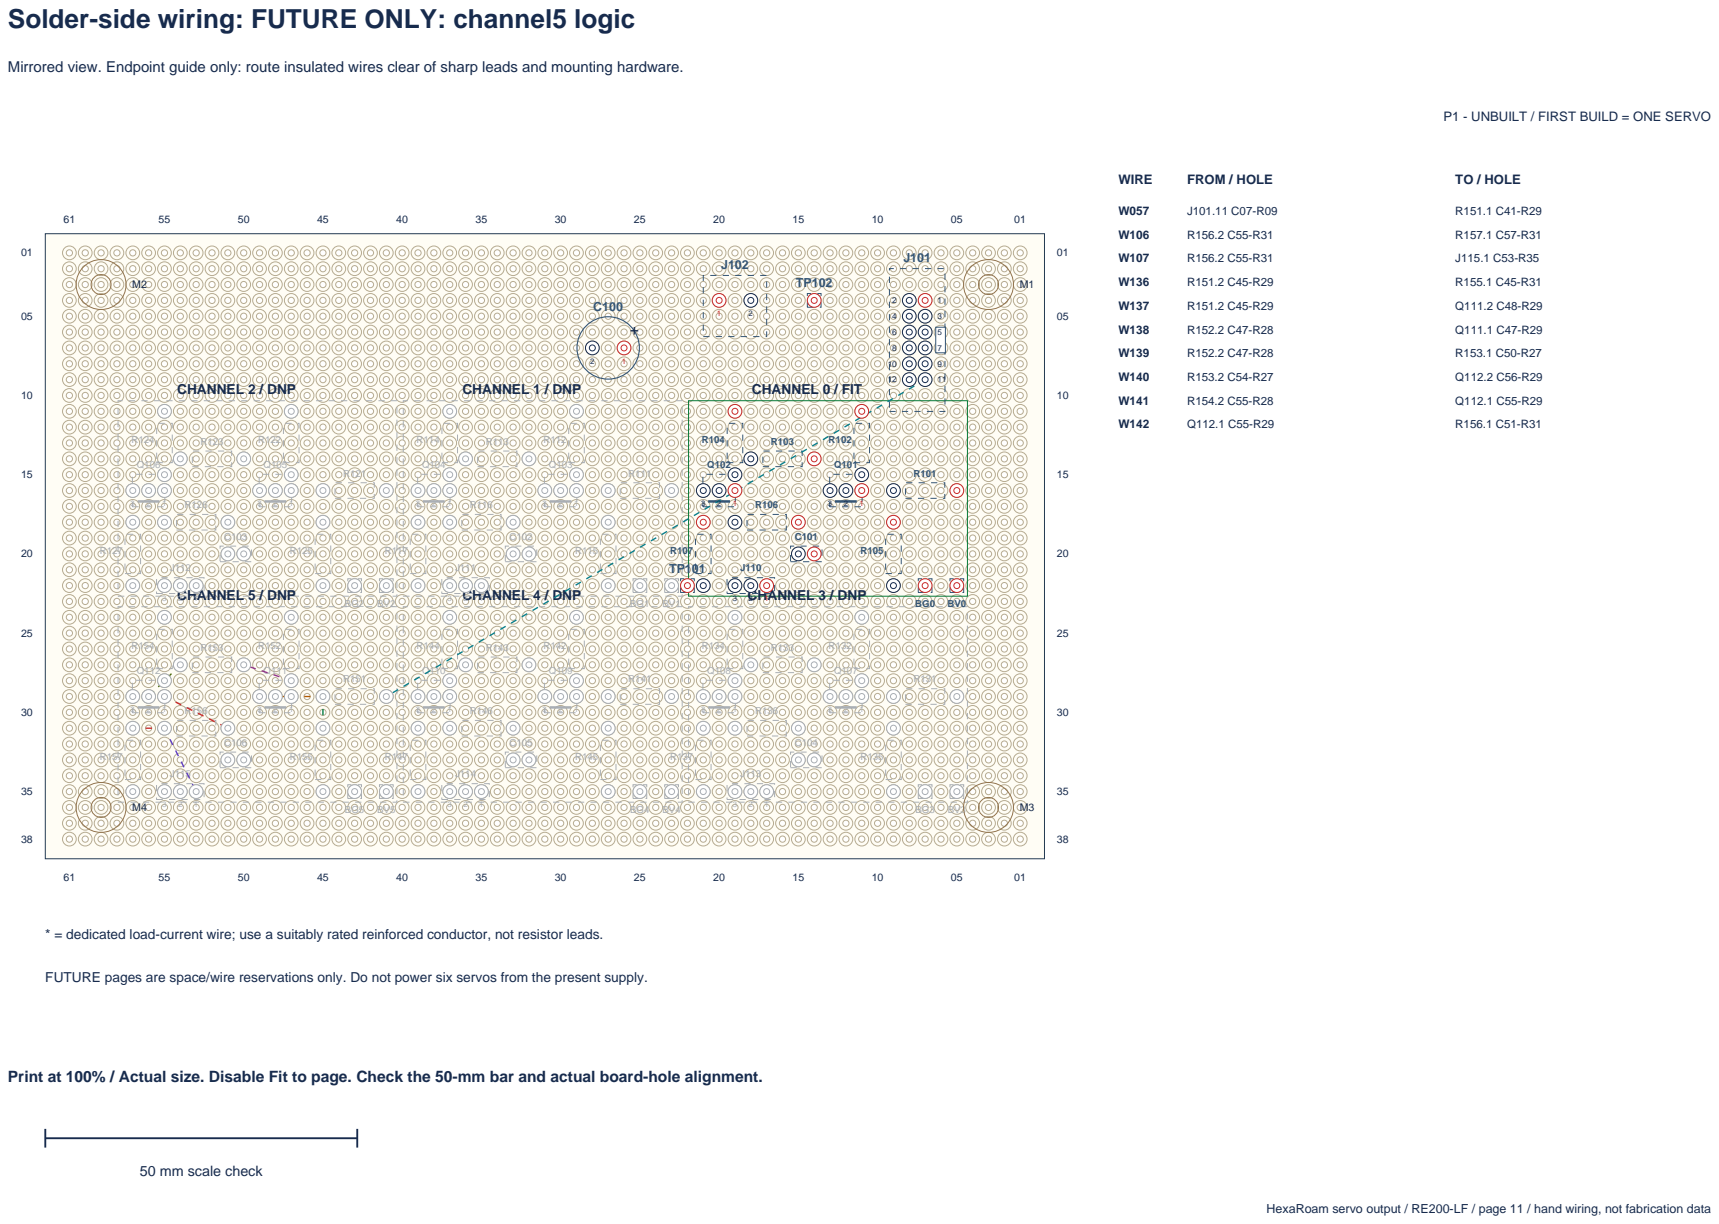
[picture p18: page 11]

P1 - UNBUILT / FIRST BUILD = ONE SERVO

* = dedicated load-current wire; use a suitably rated reinforced conductor, not resistor leads.

FUTURE pages are space/wire reservations only. Do not power six servos from the present supply.

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

HexaRoam servo output / RE200-LF / page 11 / hand wiring, not fabrication data
