ebe542/hexaroam/hardware/electronics/servo-power-re200-lf/assembly-guide.pdf

# ONE-SERVO protected supply: component placement

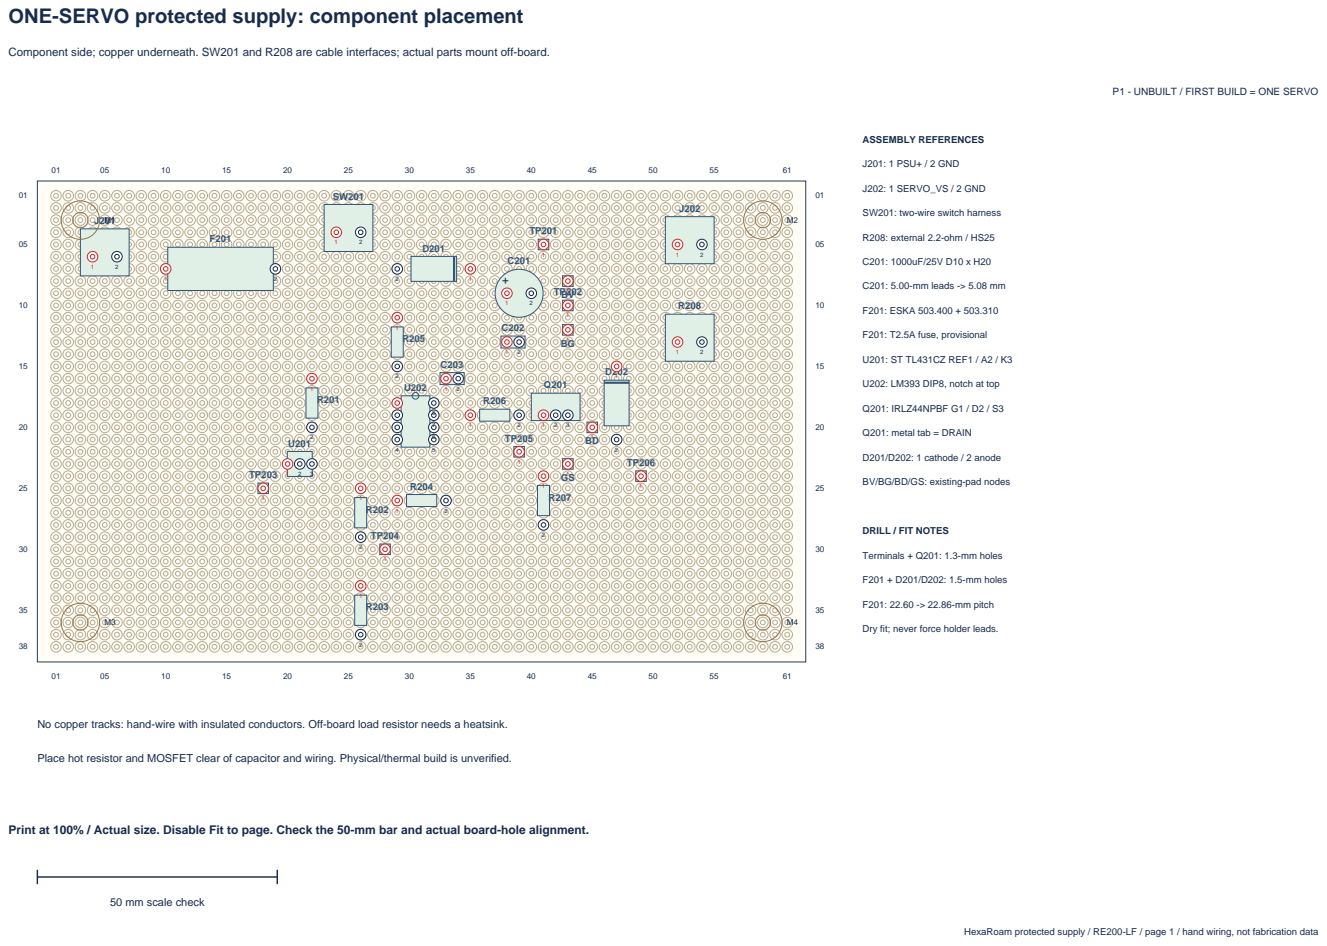
[picture p19: page 1]

Component side; copper underneath. SW201 and R208 are cable interfaces; actual parts mount off-board.

P1 - UNBUILT / FIRST BUILD = ONE SERVO

SW201: two-wire switch harness

BV/BG/BD/GS: existing-pad nodes

Dry fit; never force holder leads.

No copper tracks: hand-wire with insulated conductors. Off-board load resistor needs a heatsink.

Place hot resistor and MOSFET clear of capacitor and wiring. Physical/thermal build is unverified.

Print at 100% / Actual size. Disable Fit to page. Check the 50-mm bar and actual board-hole alignment.

HexaRoam protected supply / RE200-LF / page 1 / hand wiring, not fabrication data

# ONE-SERVO protected supply: solder-side reference

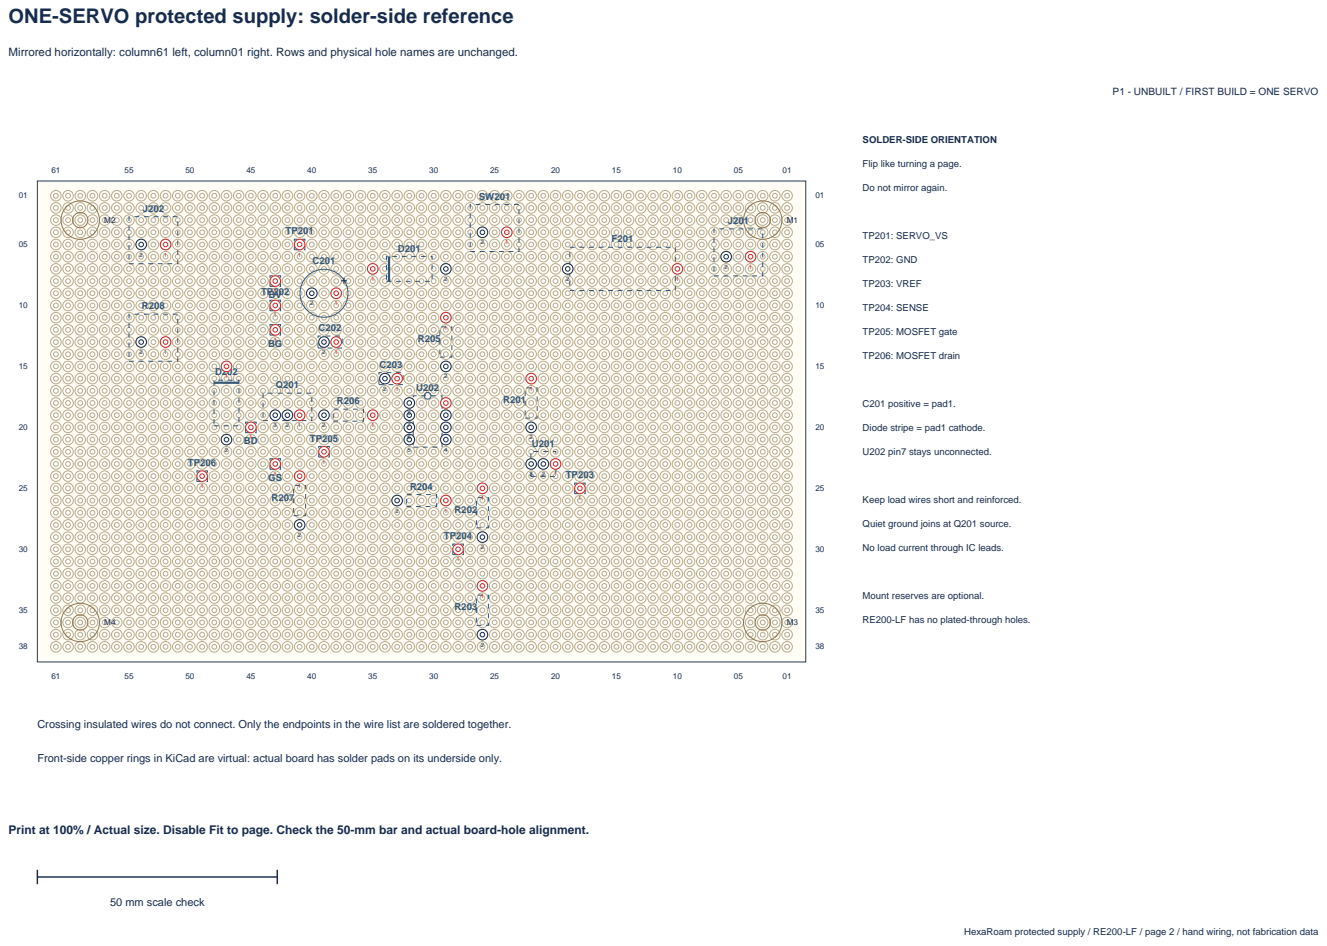
[picture p20: page 2]

Mirrored horizontally: column61 left, column01 right. Rows and physical hole names are unchanged.

P1 - UNBUILT / FIRST BUILD = ONE SERVO

Flip like turning a page.

Do not mirror again.

Keep load wires short and reinforced.

Quiet ground joins at Q201 source.

No load current through IC leads.

Mount reserves are optional.

RE200-LF has no plated-through holes.

Crossing insulated wires do not connect. Only the endpoints in the wire list are soldered together.

Front-side copper rings in KiCad are virtual: actual board has solder pads on its underside only.

Print at 100% / Actual size. Disable Fit to page. Check the 50-mm bar and actual board-hole alignment.

HexaRoam protected supply / RE200-LF / page 2 / hand wiring, not fabrication data

# Solder-side wiring: load-current wiring

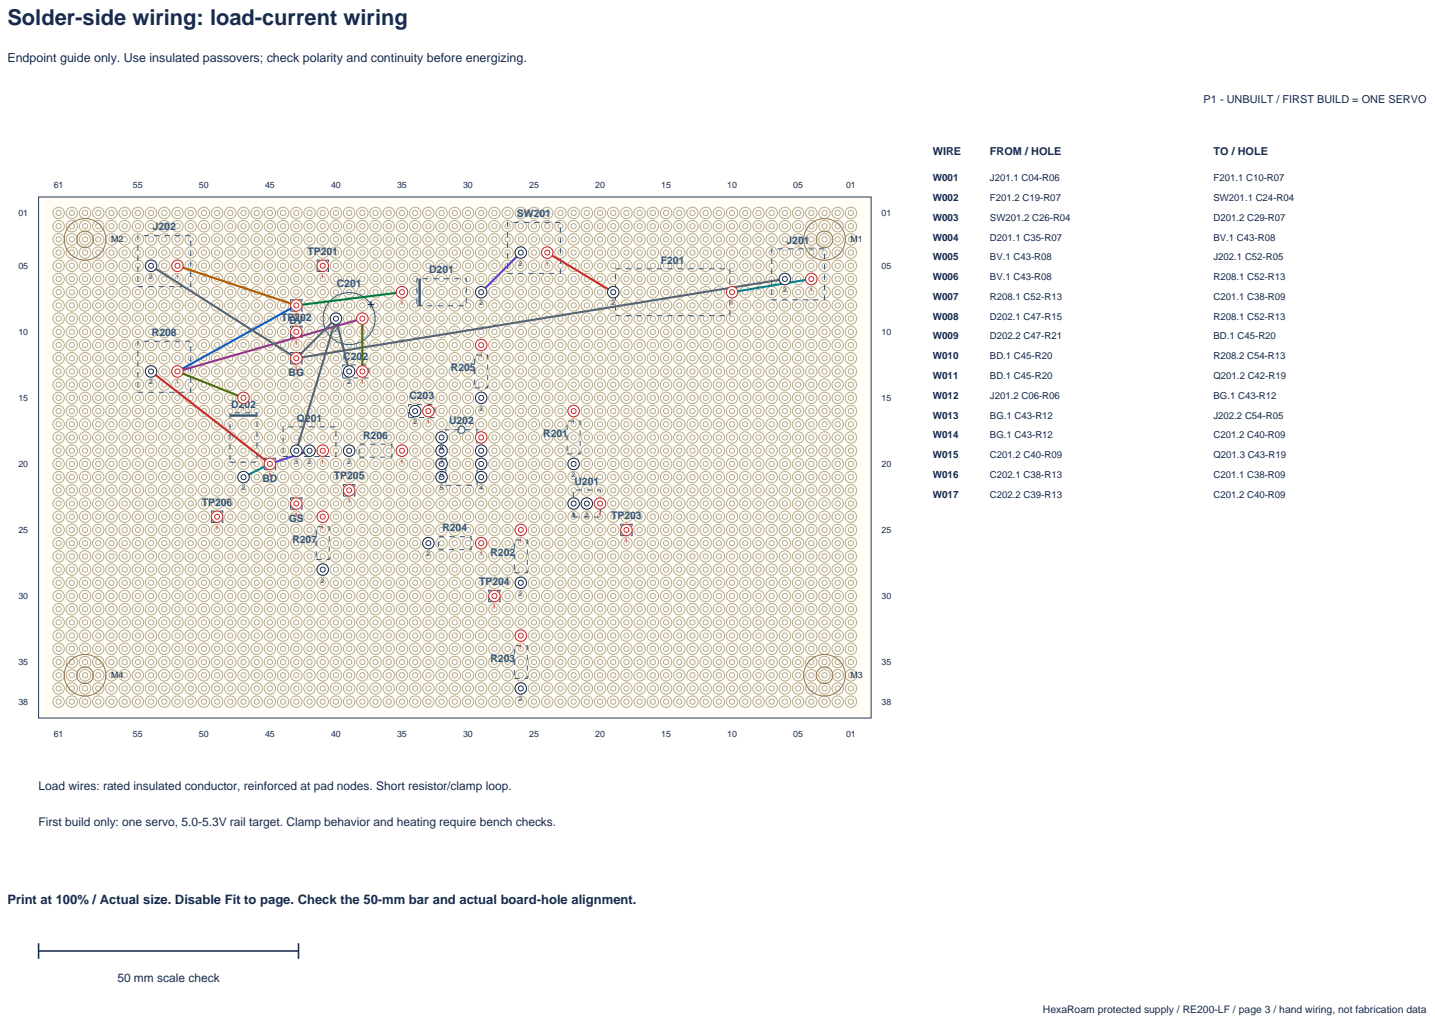
[picture p21: page 3]

Endpoint guide only. Use insulated passovers; check polarity and continuity before energizing.

P1 - UNBUILT / FIRST BUILD = ONE SERVO

Load wires: rated insulated conductor, reinforced at pad nodes. Short resistor/clamp loop.

First build only: one servo, 5.0-5.3V rail target. Clamp behavior and heating require bench checks.

Print at 100% / Actual size. Disable Fit to page. Check the 50-mm bar and actual board-hole alignment.

HexaRoam protected supply / RE200-LF / page 3 / hand wiring, not fabrication data

# Solder-side wiring: comparator / reference wiring

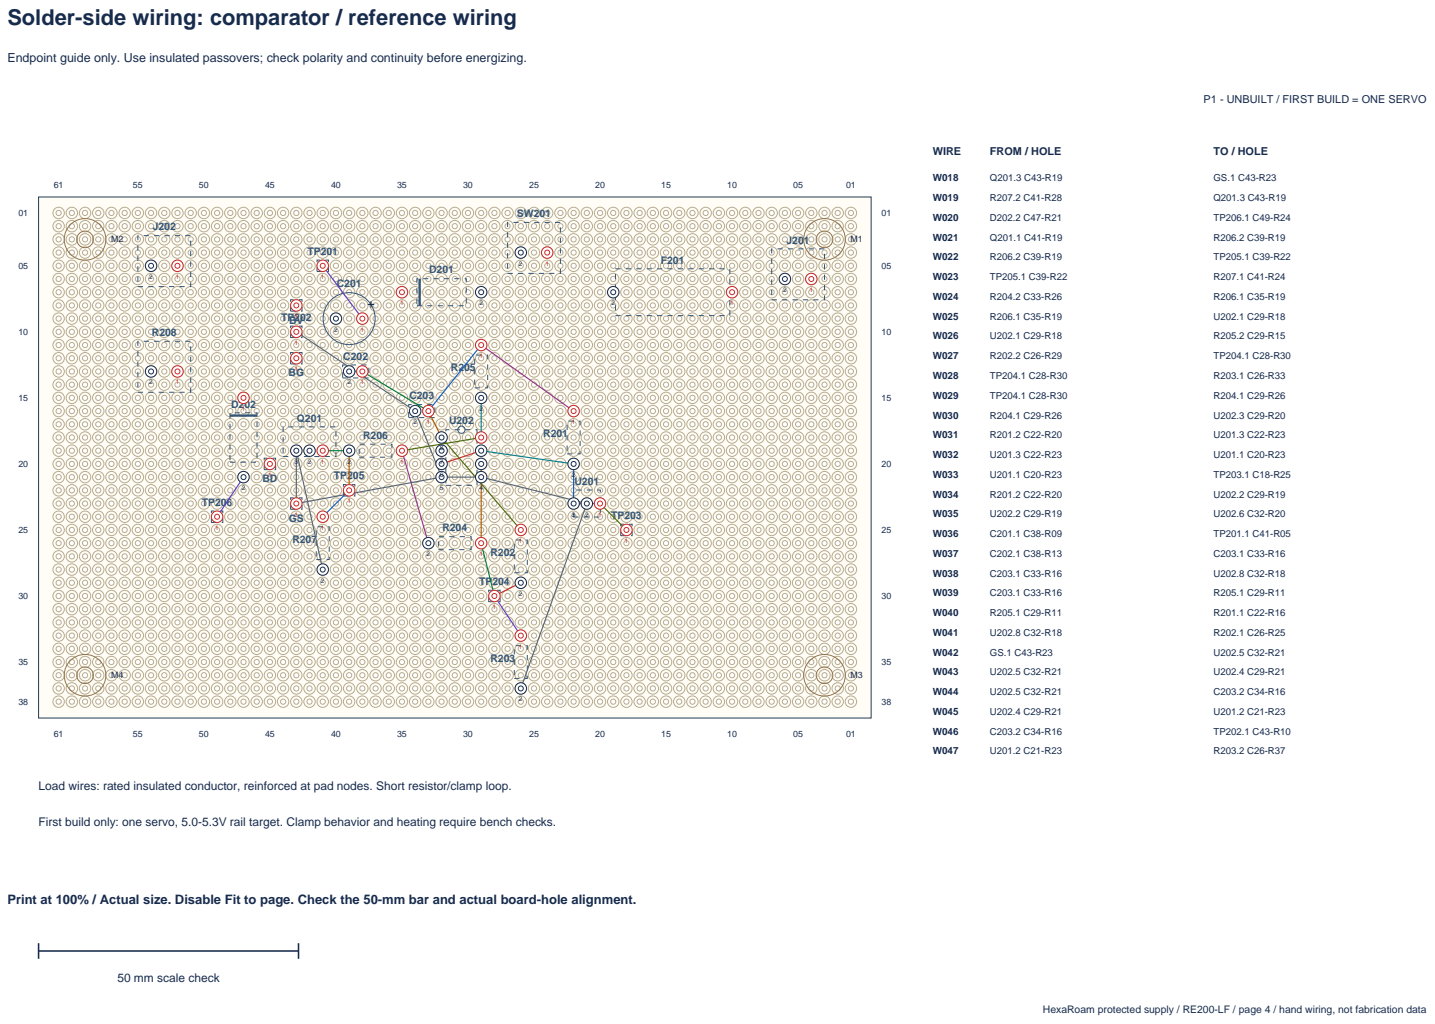
[picture p22: page 4]

Endpoint guide only. Use insulated passovers; check polarity and continuity before energizing.

P1 - UNBUILT / FIRST BUILD = ONE SERVO

Load wires: rated insulated conductor, reinforced at pad nodes. Short resistor/clamp loop.

First build only: one servo, 5.0-5.3V rail target. Clamp behavior and heating require bench checks.

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

HexaRoam protected supply / RE200-LF / page 4 / hand wiring, not fabrication data
