ebe542/hexaroam/hardware/electronics/pico-baseboard-re200-lf/wiring.csv

id | net | group | from_ref | from_pin | from_hole | to_ref | to_pin | to_hole | straight_mm | cut_hint_mm
W001 | GND | ground-power | U1 | 38 | C03-R14 | U1 | 3 | C03-R21 | 17.8 | 40
W002 | GND | ground-power | U1 | 3 | C03-R21 | U1 | 8 | C08-R21 | 12.7 | 35
W003 | GND | ground-power | U1 | 8 | C08-R21 | U1 | 13 | C13-R21 | 12.7 | 35
W004 | GND | ground-power | U1 | 13 | C13-R21 | U1 | 18 | C18-R21 | 12.7 | 35
W005 | GND | ground-power | U1 | 13 | C13-R21 | TP5 | 1 | C12-R26 | 13.0 | 35
W006 | GND | ground-power | U1 | 18 | C18-R21 | U1 | 23 | C18-R14 | 17.8 | 40
W007 | GND | ground-power | U1 | 23 | C18-R14 | U1 | 28 | C13-R14 | 12.7 | 35
W008 | GND | ground-power | TP5 | 1 | C12-R26 | J5 | 3 | C08-R32 | 18.3 | 40
W009 | GND | ground-power | U1 | 28 | C13-R14 | J1 | 2 | C10-R04 | 26.5 | 50
W010 | GND | ground-power | U1 | 18 | C18-R21 | J6 | 8 | C31-R33 | 44.9 | 65
W011 | GND | ground-power | J6 | 8 | C31-R33 | J4 | 12 | C54-R31 | 58.6 | 80
W012 | GND | ground-power | J4 | 12 | C54-R31 | J4 | 10 | C54-R30 | 2.5 | 25
W013 | GND | ground-power | J4 | 10 | C54-R30 | J4 | 8 | C54-R29 | 2.5 | 25
W014 | GND | ground-power | J4 | 8 | C54-R29 | J4 | 6 | C54-R28 | 2.5 | 25
W015 | GND | ground-power | J4 | 6 | C54-R28 | J4 | 4 | C54-R27 | 2.5 | 25
W016 | GND | ground-power | J4 | 4 | C54-R27 | J4 | 2 | C54-R26 | 2.5 | 25
W017 | GND | ground-power | J4 | 2 | C54-R26 | J3 | 12 | C54-R20 | 15.2 | 40
W018 | GND | ground-power | J3 | 12 | C54-R20 | J3 | 10 | C54-R19 | 2.5 | 25
W019 | GND | ground-power | J3 | 10 | C54-R19 | J3 | 8 | C54-R18 | 2.5 | 25
W020 | GND | ground-power | J3 | 8 | C54-R18 | J3 | 6 | C54-R17 | 2.5 | 25
W021 | GND | ground-power | J3 | 6 | C54-R17 | J3 | 4 | C54-R16 | 2.5 | 25
W022 | GND | ground-power | J3 | 4 | C54-R16 | J3 | 2 | C54-R15 | 2.5 | 25
W023 | GND | ground-power | J3 | 2 | C54-R15 | J2 | 12 | C54-R09 | 15.2 | 40
W024 | GND | ground-power | J2 | 12 | C54-R09 | J2 | 10 | C54-R08 | 2.5 | 25
W025 | GND | ground-power | J2 | 10 | C54-R08 | J2 | 8 | C54-R07 | 2.5 | 25
W026 | GND | ground-power | J2 | 8 | C54-R07 | J2 | 6 | C54-R06 | 2.5 | 25
W027 | GND | ground-power | J2 | 6 | C54-R06 | J2 | 4 | C54-R05 | 2.5 | 25
W028 | GND | ground-power | J2 | 4 | C54-R05 | J2 | 2 | C54-R04 | 2.5 | 25
W029 | /GP18 | other | U1 | 24 | C17-R14 | J6 | 1 | C24-R33 | 51.4 | 75
W030 | /GP19 | other | U1 | 25 | C16-R14 | J6 | 2 | C25-R33 | 53.4 | 75
W031 | /GP22 | other | U1 | 29 | C12-R14 | J6 | 3 | C26-R33 | 59.9 | 80
W032 | /GP26 | other | U1 | 31 | C10-R14 | J6 | 4 | C27-R33 | 64.8 | 85
W033 | /GP27 | other | U1 | 32 | C09-R14 | J6 | 5 | C28-R33 | 68.2 | 90
W034 | /GP28 | other | U1 | 34 | C07-R14 | J6 | 6 | C29-R33 | 73.8 | 95
W035 | /PICO_3V3 | other | U1 | 36 | C05-R14 | J6 | 7 | C30-R33 | 79.8 | 100
W036 | /PICO_EXT_5V | ground-power | J1 | 1 | C12-R04 | D2 | 2 | C20-R08 | 22.7 | 45
W037 | /PICO_VSYS | ground-power | U1 | 39 | C02-R14 | D2 | 1 | C16-R08 | 38.7 | 60
W038 | /PICO_VSYS | ground-power | D2 | 1 | C16-R08 | TP1 | 1 | C24-R06 | 20.9 | 45
W039 | /SERVO0_3V3 | port-a | U1 | 1 | C01-R21 | TP3 | 1 | C03-R26 | 13.7 | 35
W040 | /SERVO0_3V3 | port-a | TP3 | 1 | C03-R26 | J2 | 1 | C53-R04 | 138.8 | 160
W041 | /SERVO10_3V3 | port-b | U1 | 14 | C14-R21 | J3 | 9 | C53-R19 | 99.2 | 120
W042 | /SERVO11_3V3 | port-b | U1 | 15 | C15-R21 | J3 | 11 | C53-R20 | 96.6 | 120
W043 | /SERVO12_3V3 | port-c | U1 | 16 | C16-R21 | J4 | 1 | C53-R26 | 94.8 | 115
W044 | /SERVO13_3V3 | port-c | U1 | 17 | C17-R21 | J4 | 3 | C53-R27 | 92.7 | 115
W045 | /SERVO14_3V3 | port-c | U1 | 19 | C19-R21 | J4 | 5 | C53-R28 | 88.2 | 110
W046 | /SERVO15_3V3 | port-c | U1 | 20 | C20-R21 | J4 | 7 | C53-R29 | 86.2 | 110
W047 | /SERVO16_3V3 | port-c | U1 | 21 | C20-R14 | J4 | 9 | C53-R30 | 93.2 | 115
W048 | /SERVO17_3V3 | port-c | U1 | 22 | C19-R14 | J4 | 11 | C53-R31 | 96.6 | 120
W049 | /SERVO1_3V3 | port-a | U1 | 2 | C02-R21 | TP4 | 1 | C07-R26 | 18.0 | 40
W050 | /SERVO1_3V3 | port-a | TP4 | 1 | C07-R26 | J2 | 3 | C53-R05 | 128.4 | 150
W051 | /SERVO2_3V3 | port-a | U1 | 4 | C04-R21 | J2 | 5 | C53-R06 | 130.2 | 155
W052 | /SERVO3_3V3 | port-a | U1 | 5 | C05-R21 | J2 | 7 | C53-R07 | 127.0 | 150
W053 | /SERVO4_3V3 | port-a | U1 | 6 | C06-R21 | J2 | 9 | C53-R08 | 123.9 | 145
W054 | /SERVO5_3V3 | port-a | U1 | 7 | C07-R21 | J2 | 11 | C53-R09 | 120.8 | 145
W055 | /SERVO6_3V3 | port-b | U1 | 9 | C09-R21 | J3 | 1 | C53-R15 | 112.8 | 135
W056 | /SERVO7_3V3 | port-b | U1 | 10 | C10-R21 | J3 | 3 | C53-R16 | 110.0 | 130
W057 | /SERVO8_3V3 | port-b | U1 | 11 | C11-R21 | J3 | 5 | C53-R17 | 107.2 | 130
W058 | /SERVO9_3V3 | port-b | U1 | 12 | C12-R21 | J3 | 7 | C53-R18 | 104.4 | 125
W059 | /UART1_RX | other | J5 | 2 | C07-R32 | U1 | 27 | C14-R14 | 49.1 | 70
W060 | /UART1_TX | other | J5 | 1 | C06-R32 | U1 | 26 | C15-R14 | 51.1 | 75
W061 | /USB_VBUS | ground-power | U1 | 40 | C01-R14 | TP2 | 1 | C24-R10 | 59.3 | 80
