ebe542/hexaroam/firmware/pico/hardware_tests/README.md

# Pico hardware tests

These are separately selected firmware programs, evaluated manually on a Raspberry Pi Pico with RP2040, using an oscilloscope for servo signals or a TTL adapter and terminal for UART output. They are not host unit tests and are not executed by cargo test or the normal development check or verify task. Cargo registers them as example targets with explicit paths in Cargo.toml.

## EEPROM tests

The separate [EEPROM test guide](../../../docs/eeprom-hardware-tests.md) documents eeprom_write_read (WP low) and eeprom_write_protect (WP high), wiring, expected logs and the destructive 0x7F80..0x7FFF test region. The pure eeprom_read example was removed; no power-cycle retention test is included. The owner reported all 63 hardware-build checks and the full 837-test/21-check local verification passing on 2026-11-08. Neither example has been run on physical EEPROM hardware yet.

## Setup

For the PIO tests, use unloaded GP0 and GP1 with no servos connected. Connect oscilloscope probes to these outputs and reference both channels to Pico GND. Use DC coupling to distinguish a persistent Low level from missing trigger activity. The current instrument is a Leader 1041 two-channel analog oscilloscope; a single startup pulse sequence may not be visible.

## UART connection and terminal

The UART tests use a Waveshare USB TO RS232/485/TTL adapter in **3.3 V TTL mode**. Use its TTL terminals:

| Pico | Adapter |
| --- | --- |
| GP20, physical pin 26, UART1 TX | TTL RXD |
| GND, for example physical pin 23 | TTL GND |

Leave the adapter TXD and power terminals disconnected. Power the Pico through USB. The UART tests do not start servo output; GP0 and GP1 remain unused by these tests.

Open HTerm at **115200 baud, 8 data bits, no parity, one stop bit, no flow control**. Lines end with LF (`\n`) only. Configure terminal display handling for LF as needed. GP21 is reserved for a possible future UART1 RX connection; the current tests are transmit-only.

## Build and convert

From the repository root:

```bash
python tools/dev.py hardware-build
```

This builds all registered hardware-test programs and generates ELF, UF2, linker map (.map) and disassembly (.disasm) for each. It requires the embedded Rust target, elf2uf2-rs and the Rust llvm-tools-preview component (install with `rustup component add llvm-tools-preview`). See the [report-generation procedure](../../../tools/README.md#linker-maps-and-disassembly). It does not flash the Pico or evaluate results. Files are generated under:

```text
firmware/pico/target/thumbv6m-none-eabi/debug/examples/
```

To build and convert just one program, run from firmware/pico:

```bash
cargo run --locked --example underflow_missing_counter --features hardware-tests
```

Transfer the selected UF2 using BOOTSEL and the RPI-RP2 drive as described in the [firmware guide](../../README.md). Each transfer replaces the currently installed firmware. Reboot or transfer a fresh image to begin another run. The normal demo remains available through python tools/dev.py uf2 from the repository root.

## Programs and manual checks

| Program | Procedure and expected result |
| --- | --- |
| fixed_plan | Observe continuous approximately 1-ms High pulses on GP0 and 2-ms High pulses on GP1, with synchronous rising edges and a nominal 20-ms period. LED phases are approximately 500 ms. Measure the period separately. |
| underflow_missing_entry | Initially observe the normal pulse sequence. At approximately 5 s, DMA rearming is paused and both outputs must settle Low. LED phases change to 100 ms when PIO IRQ flag 0 is set. After 10 s, servicing resumes but both outputs must remain Low. |
| underflow_missing_counter | The first transfer ends after the final mask, omitting its counter. PIO must force Low and latch its error flag. LED phases become 100 ms. Servicing starts after 1 s; outputs must remain Low. The initial one-off pulse sequence may be too brief to observe. |
| switching_signal_plans | Alternate GP0/GP1 between 1 ms/2 ms and 2 ms/1 ms approximately once per second. Rising edges remain synchronous; nominal period is 20 ms. An immediate second submission must return Busy. Normal LED phases are 500 ms, fault phases 100 ms; a failed assertion halts execution. |
| faulted_signal_output | Run normally for approximately 5 s, prepare a replacement, and stop DMA servicing. On underflow, assert Faulted instead of Busy, clear hardware IRQ flag 0, and assert that the driver remains faulted and rejects further plans. Resume service calls; outputs stay Low. LED phases become 100 ms after the assertions pass. |
| restart_signal_output | Run initial GP0/GP1 pulses for 5 s, induce real underflow, remain Low for 2 s, then restart with 2-ms/1-ms pulses. Reject restart while healthy and invalid period/output requests while faulted. LED phases are 100 ms while faulted, 500 ms otherwise. |
| restart_active_dma | After 5 s, inject a fault with PIO disabled and outputs Low; confirm a full FIFO and active DMA. Remain Low for 2 s with DMA still active, then restart with 2-ms/1-ms pulses. The successful restart must abort the still-active transfer. |
| restart_abort_timeout | After 5 s, inject a fault with active DMA, request restart with zero abort polling attempts, and assert DmaAbortTimeout. Keep outputs Low and the transfer owned for 2 s, then retry with the normal budget and observe 2-ms/1-ms pulses. UART reports the forced timeout and successful retry. |
| servo_bank_angles | Exercise calibrated complete and partial angle commands every 2 s. Observe GP0/GP1 widths 1500/1500, 1000/2000, 1500/2000, 1500/1000, unchanged after an invalid batch, then 1500/1500 us. Rising edges should remain synchronous. |
| uart_diagnostics | Receive three startup lines (INFO, DEBUG, ERROR) and then INFO Pico alive about once per second. The LED toggles with each alive message. Output is queued in a 128-byte logger and serviced with a 16-byte budget per loop. |
| uart_panic | Receive the buffered startup message. After approximately 5 s, the LED turns on and a deliberate panic prints its message and source location directly through UART1. The LED stays on and normal execution stops. |

In the original underflow and switching tests, fast blinking means the program observed PIO IRQ flag 0. In faulted_signal_output it means the fault-state assertions passed, including persistence after clearing that hardware flag. It is not a calibrated timing measurement. The fault tests establish persistent electrical Low behavior, not a safe mechanical posture or servo position feedback. These original fault tests do not perform recovery. The two restart programs exercise explicit recovery separately.

## Shared support and feature boundary

support/mod.rs initializes board clocks, GPIO ownership, and the hardware timer, and supplies UART1 and its peripheral clock to the UART tests. fixed_plan reuses the normal servo_demo. The underflow, switching, and fault-state tests share support/output.rs for the fixed two-output plan, static storage, and nonblocking LED indicator; each test keeps its own execution sequence.

The Pico hardware-tests feature forwards to servo-pio/hardware-tests. That feature exposes start_with_missing_final_counter and its truncation mode, plus dma_is_active and force_fault_with_active_dma for active-DMA fault injection, and restart_with_zero_abort_budget and has_dma_transfer for timeout-path verification. Normal start_fixed continues to transfer complete plans. The missing-entry test requires no driver fault injection: it deliberately pauses service calls. No production source edits are needed to select or repeat these experiments.

## Reported verification

On 2026-10-17 the owner reported:

- The fixed-plan demo produced approximately 1 ms and 2 ms High durations with synchronous rising edges.
- The separately selected missing-entry test behaved as described.
- The missing-counter test appeared to enter fault mode immediately; no startup edges were visible. This matches the expected millisecond-scale fault, but no precise fault latency was measured.
- The earlier full verification passed 121 host unit tests, and hardware-build created the UF2 files. The owner subsequently reported green CI for the hardware-test and task-splitting revisions.
- The two-buffer revision passed 128 unit tests and hardware-test builds. switching_signal_plans ran as expected with synchronous rising edges and alternating High durations. Continued execution also indicates that its Busy assertion did not halt the program.

The 128 unit-test total excludes these manually evaluated firmware programs. New exact period measurements, worst-case DMA service latency, 18-channel output, controlled recovery, and attached-servo operation have not been established. The owner subsequently reported green CI for two-buffer switching. Remote CI for the fault-state revision is pending.

## Persistent driver fault test

On 2026-10-17, the owner reported all requested checks passing and faulted_signal_output running as expected. The test first establishes a pending replacement and Busy, then verifies that submit_plan detects a real PIO underflow and returns Faulted before considering the occupied slot. It clears hardware flag 0 only after the driver has latched the fault. Subsequent status checks and submissions must still report faulted, and further servicing must not restart the signals.

The electrical Low response still comes from PIO. The driver observes it when is_faulted, submit_plan, or service reads the reserved flag; detection is not an asynchronous CPU interrupt. A flag cleared before observation cannot be discovered through that flag. The test does not perform recovery.

The original underflow, switching, and persistent-fault tests use panic_halt without UART assertion output. fixed_plan, uart_panic, all restart tests, and servo_bank_angles select the UART panic handler. The restart programs initialize UART1 and log state transitions; fixed_plan shares the normal demo logging. A failed assertion stops CPU progress and LED updates; the last LED level alone does not identify the failing assertion. PIO/DMA may continue until their data supply runs out. Observe a continuing blink pattern, not merely a particular static LED level.

## UART verification record

On 2026-10-17, the owner confirmed that uart_diagnostics delivered Info, Debug, and Error output to HTerm, including after the LF-only change. The owner then reported 145 passing tests in the full runner and confirmed that uart_panic emitted its message after approximately five seconds and left the LED permanently on.

The logging library contributes 17 unit tests to that total. These manual UART tests do not add to the count. See the [logging guide](../../logging/README.md) for buffer and panic contracts. The owner subsequently confirmed UART output alongside servo pulses in the normal demo and reported green CI for the earlier logging revision. The normal firmware now selects the UART panic handler. Panic before UART initialization and a stalled UART have not been separately tested on hardware.

## Controlled restart tests

Both programs use the UART wiring above and unloaded GP0/GP1. From the repository root, build all ELF/UF2 files with `python tools/dev.py hardware-build`. Upload either `restart_signal_output.uf2` or `restart_active_dma.uf2` from the generated examples directory.

Expected phases are initial 1-ms/2-ms pulses for approximately five seconds, both outputs Low for approximately two seconds, then 2-ms/1-ms pulses with synchronous rising edges. The LED blinks faster in the fault phase. UART reports state transitions and does not emit periodic alive messages. Assertions and expect failures use the UART panic handler.

`restart_signal_output` stops servicing DMA with a replacement still pending and waits for real underflow. It checks NotFaulted while healthy, Faulted on submission after underflow, and rejection of invalid restart periods/output sets. Servicing during the Low interval must not restart output. A successful explicit restart selects the supplied replacement and clears the driver fault.

`restart_active_dma` injects its fault instead of waiting for underflow. The hardware-tests hook disables PIO execution, forces Low, sets flag 0, safely retires the previous DMA transfer, and starts a full six-word transfer with no consuming state machine. The four-word FIFO must fill while DMA remains active. Assertions confirm active DMA after injection, after rejected restart requests, throughout the Low interval, and immediately before successful restart. This distinguishes the test from recovery after a transfer that may already have completed.

On 2026-10-17 the owner reported 149 passing unit tests and successful manual execution of both tests, including the signal restart and expected LED behavior. The active-DMA test's successful execution also confirms its DMA-status assertions passed. The manual programs are not included in the unit-test total. The timeout return path was subsequently tested with zero polling attempts as recorded below; exact latency and short-glitch exclusion remain unverified. CI for this recovery revision has not yet been reported.

## Forced abort-timeout test

`restart_abort_timeout` follows the active-DMA fault setup. A feature-gated wrapper calls the same restart implementation with zero permitted status polls. Plan validation and the real channel abort request still occur; the helper then returns Timeout without confirming completion. The test asserts DmaAbortTimeout, persistent driver fault, retained transfer ownership, and rejection of ordinary plan submissions.

For the next two seconds, service calls must not restart output and the transfer must remain owned. DMA may already have stopped asynchronously; BUSY is deliberately not required to remain set after the abort request. A normal restart with a fresh complete replacement must then succeed. Expected signals are five seconds of initial pulses, a Low interval, and restarted GP0/GP1 pulses of 2 ms/1 ms. The LED indicates fault and running phases, and UART reports the timeout and successful retry.

On 2026-10-27 the owner reported 169 passing unit tests, successful signal checks, and expected UART output for this program. This verifies the exhausted-budget return path and subsequent recovery, not a physically stuck DMA channel or the elapsed duration of a real abort timeout. The manual program does not add to unit-test counts. CI for this timeout revision has not yet been reported.

## Servo-bank angle test

`servo_bank_angles` exercises ServoBank -> ServoSignalOutput -> SwitchingOutput -> DMA/PIO on unloaded GP0/GP1. Both synthetic calibrations map -45/0/+45 degrees to 1000/1500/2000 us. The driver starts with a matching center plan; the bank then submits its initial complete center request. Every later angle change passes through the bank and adapter. The main loop calls bank.service and services the UART logger without blocking delays.

At two-second intervals, the program sends complete opposite-angle targets, changes only servo 0, changes only servo 1, rejects a batch containing +46 degrees, and resets both servos to center before repeating. Assertions check retained command values after partial and rejected requests. UART messages describe accepted or rejected commands, not physical activation acknowledgements.

On 2026-10-27 the owner reported 169 passing unit tests, a successful signal check, and subsequently green CI for the angle-test revision. This confirms the integrated command-to-signal path with synthetic calibration. Exact timing, brief-glitch exclusion, actual servo positions, and measured mechanical calibration remain unverified.

## Read-only calibration journal test

`flash_journal_read` checks the reserved 8-KiB region through FlashJournalReader -> JournalRead -> load -> find_latest for eighteen servo IDs. It also checks that read_slot rejects SLOT_COUNT as out of range. It uses the software CRC adapter and starts no servo output, flash programming or flash erase. Use the established UART1 wiring: GP20 to adapter TTL RXD, shared GND, 3.3-V logic, HTerm at 115200 baud/8N1/no flow control.

From the repository root:

```bash
python tools/dev.py hardware-build
```

After the build/conversion succeeds, hold BOOTSEL while connecting the Pico and copy `firmware/pico/target/thumbv6m-none-eabi/debug/examples/flash_journal_read.uf2` to RPI-RP2. This programs the test firmware; the running test itself does not write the journal. Prepare HTerm before startup because the result is emitted once.

Expected result: `INFO Journal read OK: no valid record` if no slot is valid, or `INFO Journal read OK: valid record found` if an existing record passes validation. Either successful read result sets the LED high. Invalid layout, failed bounds checking or load failure reports an error and leaves the LED low. A high LED indicates test completion, not configuration completeness or robot-operation permission. This test uses panic-halt; an unexpected panic may halt without a UART panic message.

On 2026-10-28 the owner reported `INFO Journal read OK: no valid record`, followed by 244 passing tests and all 13 checks passing. LED state was not separately reported. The region may contain erased or invalid data; absence of a valid record does not distinguish them. A known valid on-flash record and write/erase/persistence behavior remain untested. The owner subsequently reported green CI for the read-only integration.

## RAM routine probe

`flash_ram_probe` verifies the placement and invocation of a small RAM-resident function before implementing flash writes. `pico/src/flash_ram.rs` places `hexaroam_ram_probe` in `.data.ram_func`, prevents inlining and exports a stable symbol name. The existing cortex-m-rt linker script includes `.data.*` in RAM with a flash load image; startup copies it before main. The routine XORs its runtime input with `0xA5A55A5A` and calls no other function.

The standalone test checks the function address against configured RAM, clears the Thumb-state bit for that address check, calls the routine with interrupts temporarily masked, and checks its return value. XIP remains enabled throughout. The interrupt wrapper, UART and other test infrastructure can still execute from flash. No second core, DMA transfer or servo output is started; no flash programming or erase occurs.

From the repository root, run `python tools/dev.py hardware-build`, then upload `firmware/pico/target/thumbv6m-none-eabi/debug/examples/flash_ram_probe.uf2` in BOOTSEL mode. Use the established GP20 UART1 connection and HTerm at 115200 baud/8N1/no flow control. Expected one-time output is `INFO RAM routine OK`, with the LED high on success. Address/result failure reports an error and leaves the LED low. The test uses panic-halt.

Read-only inspection of the built debug ELF found execution address `0x20000000`, flash load address `0x1000BC1C`, and inclusion in the startup-copy range `__sdata..__edata`. The symbol occupied 20 bytes: 16 bytes of instructions and a four-byte local literal; no additional function calls were present in the probe. Addresses and instruction size are specific to that build and must be rechecked after changes.

On 2026-10-29 the owner reported `INFO RAM routine OK` from the Pico, followed by 244 passing tests and all 13 checks passing in the full local runner. LED state was not separately reported. This verifies the simple RAM probe with XIP enabled, not the complete XIP-off flash-operation path, ROM-call sequence, Boot2 restoration, multicore exclusion, watchdog behavior or write persistence. The owner subsequently reported green CI for the RAM-probe revision.

## XIP exit and restoration test

`flash_xip_cycle` exercises the RAM/ROM transition without programming or erasing flash. Before the transition it resolves the RP2040 ROM pointers for connect_internal_flash, flash_exit_xip and flash_flush_cache, and copies the running image's 256-byte Boot2 into aligned stack RAM. It checks ROM/Thumb addresses and RAM placement before constructing the callable Boot2 pointer.

The `.data.ram_func` routine `hexaroam_xip_cycle` receives four function pointers, calls connect, exit, flush and the RAM Boot2 copy, then returns after XIP has been restored. ROM lookups happen before entering the routine. The test masks interrupts around the call and never starts core1, DMA or servo output. No FlashJournalReader instance is created, respecting that reader's lifetime restriction against XIP reconfiguration. The test assumes the standard Pico flash/pad configuration; it is not a general multicore runtime guard.

After returning, it reads the first mapped flash word with a volatile load and compares it with the copied word. It then reports through UART1. Expected one-time output: `INFO XIP cycle OK`, LED high on success. A preparation-address or flash-word mismatch reports an error and leaves the LED low. Unexpected panic uses panic-halt; watchdog recovery was not implemented or tested.

Build from the repository root with `python tools/dev.py hardware-build`. After ELF review, upload `firmware/pico/target/thumbv6m-none-eabi/debug/examples/flash_xip_cycle.uf2` in BOOTSEL mode. Use GP20 UART1/TTL RXD, common ground, 3.3-V logic and HTerm at 115200 baud/8N1/no flow control.

Debug ELF inspection found the 38-byte transition routine at `0x20000000`, backed by flash load address `0x1000C104` within the startup `.data` copy. Its instructions contain four indirect calls through the supplied pointers and no extra helper calls or flash literals. These are build-specific observations and must be rechecked when changing the critical path.

On 2026-10-29 the owner reported `INFO XIP cycle OK`, then 244 passing tests and all 13 checks passing in the full local runner. This confirms the no-write XIP transition, return to ordinary flash execution and the checked post-return flash read. LED state was not separately reported. Flash programming, erase, write persistence, failure recovery and operation alongside another core or active DMA remain unverified. The owner subsequently reported green CI for the XIP-transition revision.

## Journal geometry integration recheck

After the Pico reader was changed to use JournalLayout for bounded flash-relative slot ranges, the owner reran flash_journal_read on 2026-10-29 and reported `INFO Journal read OK: no valid record`. The existing out-of-range slot check remains in the test. The full local runner reported 254 passing tests and all 13 checks passing; the storage library now has 82 host tests, including ten geometry tests. LED state was not separately reported. This is a read-only regression check, not a proof of erased contents, successful persistence or a tested erase/program operation. The owner subsequently reported green CI for the geometry/reader revision.

## Journal slot programming test

`flash_program_slot` programs a 512-byte test pattern into journal slot 0 only if every target byte is 0xFF. It never erases flash. The pattern is deliberately not a valid calibration record and occupies the slot until a separate erase operation. Repeating the test must refuse to overwrite it.

Build with `python tools/dev.py hardware-build`, then manually upload `firmware/pico/target/thumbv6m-none-eabi/debug/examples/flash_program_slot.uf2`. Use the UART1 wiring and terminal settings above. Expected first result: `INFO Journal slot program OK`, with the LED high. Restart without uploading again: expect `ERROR Journal slot 0 is not erased`, with the LED low.

Before disabling XIP, the test validates the linker-reserved region through JournalLayout, checks that slot 0 is erased, resolves the ROM function pointers, and prepares the source buffer and aligned Boot2 copy in RAM. With interrupts masked, the RAM routine connects flash, exits XIP, programs the slot, flushes the cache and restores XIP through Boot2. All 512 bytes are compared after XIP is restored. The standalone test starts no second core, DMA or servo output and creates no FlashJournalReader. It assumes the standard Pico flash/pad configuration; it is not a general runtime exclusion mechanism or watchdog recovery test. Panic uses panic_halt.

On 2026-10-29, read-only inspection of the built debug ELF placed hexaroam_program_slot at 0x20000000, with all 62 bytes inside the startup-copied data section. Manual Thumb instruction review found five indirect function calls, register/stack accesses and the immediate 512-byte length, without extra helper calls or flash literals. No initialized load segment overlapped the reserved journal. An ARM disassembler was not available; this was a manual instruction review, not automated disassembly.

The owner observed `INFO Journal slot program OK`, then `ERROR Journal slot 0 is not erased` after restarting without another upload. The first result confirms the complete readback comparison; the restart result confirms that the slot remains occupied and repeat programming is rejected, not an independent full-byte verification after reset. The owner also reported 254 passing tests and all 13 checks passing. Manual hardware tests do not add to the unit-test count. The owner subsequently reported green CI for this programming revision.

## Journal sector erase test

`flash_erase_sector` deliberately destroys all contents of reserved journal sector 0, including the slot-programming test pattern. It first validates the linker region with JournalLayout, selects sector 0 through sector_range(0), and refuses an unnecessary erase when all target bytes already equal 0xFF. Before erasing it snapshots every byte of sector 1 in RAM. It resolves ROM function pointers and copies Boot2 into aligned RAM while XIP remains active.

With interrupts masked, hexaroam_erase_sector executes from RAM and calls connect, exit, ROM erase, flush and the RAM Boot2 copy. Erase count and block size are fixed at SECTOR_SIZE (4096); the command is the standard 0x20 sector erase. After XIP restoration the test checks all 4096 target bytes against 0xFF and compares all 4096 retained-sector bytes against the snapshot. It creates no FlashJournalReader and starts no core1, DMA or servo output. Standard Pico flash/pad configuration is assumed. This standalone test does not select sectors using journal records and does not establish runtime exclusion, watchdog recovery or interrupted-erase safety.

Build using `python tools/dev.py hardware-build`. Review the generated map and disassembly before uploading `firmware/pico/target/thumbv6m-none-eabi/debug/examples/flash_erase_sector.uf2`. Use the UART setup above. Expected result for occupied sector 0: `INFO Journal sector erase OK`, LED high. Restart without uploading again: `ERROR Journal sector 0 is already erased`, LED low, no further erase. If already erased on the first run, use flash_program_slot to prepare the test pattern before repeating this erase test. Never use this test with calibration data that must be retained in sector 0.

On 2026-10-29 the owner reported all 33 hardware-build checks passing. Map/disassembly review placed the complete 58-byte routine at 0x20000000 inside the startup-copied RAM data section. Its five indirect calls and remaining register/stack instructions contained no extra helper calls or flash literals; erase arguments were 4096/4096/0x20. These observations are build-specific.

The owner then received `INFO Journal sector erase OK` and, after restart, `ERROR Journal sector 0 is already erased`. This confirms the immediate full-sector erase check, exact retained-sector comparison and erased-target detection after restart. LED levels were not separately reported. The full local runner passed 269 tests and all 13 checks. Manual hardware programs do not contribute unit-test counts. CI for this erase revision is pending.

## FlashJournalStorage backend tests

The backend in [flash_journal_storage.rs](../src/flash_journal_storage.rs) now implements JournalRead and JournalStorage. It checks the linker reservation and JournalLayout ranges, rejects non-RAM program sources without copying their payload, refuses occupied slots, and verifies all 512 programmed bytes after XIP restoration. Erasure validates the sector index, accepts an already-erased sector without another ROM erase, and checks all 4096 bytes after erasure. The unsafe constructor requires exclusion of independent flash writers/readers and flash access by other cores, DMA, debugger activity or unmasked exceptions during program/erase. Normal interrupts are masked internally; this is not a general multicore/runtime guard.

Build all tests using `python tools/dev.py hardware-build`, review their map/disassembly, then transfer only the selected UF2. UART wiring/settings remain as above. These tests use panic_halt and start no core1, DMA or servo output.

| Program | Operation and expected result |
| --- | --- |
| flash_journal_read | Now uses FlashJournalStorage, retaining the invalid-slot check and load of eighteen IDs. No writing/erasure. Expected no-valid-record result remains successful reading, not permission to operate the robot. Its module-local dead_code allowance covers unused write operations in this read-only example. |
| flash_storage_program | Requires erased slot 0. Checks rejection of SLOT_COUNT, a source static verified to be in mapped flash, preservation after rejection, programming from RAM, full readback and rejection of another write with changed data. Expected `INFO Flash storage program OK`. After restart with the slot occupied: `ERROR Slot 0 occupied; run erase preparation`, preserving its contents. Writes an invalid journal test pattern, not calibration data. |
| flash_storage_erase | Deliberately destroys sector 0. Snapshots both sectors; rejects SECTOR_COUNT and usize::MAX without changing either; prepares a pattern if target is already erased; uses JournalStorage::erase_sector; checks all target slots against 0xFF and all retained slots against the snapshot; repeats the erase call and checks again. Expected `INFO Flash storage erase OK`. Each startup can perform one real preparation/erase cycle; this is not the standalone erase test that refuses another run on erased contents. |

For programming preparation, flash_erase_sector can clear sector 0 before flash_storage_program. Do not use either erase program with sector 0 data that must be retained. flash_storage_erase verifies byte preservation of sector 1 as found; it does not deliberately seed that sector.

On 2026-10-30 the owner observed `INFO Journal read OK: no valid record` through the new backend, then `INFO Flash storage program OK` and the occupied-slot message after restart. The owner subsequently observed `INFO Flash storage erase OK`. Backend-map/disassembly review found the complete program wrapper in copied RAM (62 bytes, five indirect calls) and the erase wrapper likewise (58 bytes, five indirect calls), without additional helper calls or flash literals. The program-test flash source was confirmed in flash. Results are specific to the reviewed debug builds.

The latest owner-reported hardware build passed all 37 checks, and full verification passed 275 tests and all 13 checks. Manual firmware programs add no unit-test cases. Success messages establish the checks in their program paths; LED levels were not separately reported. The repeated erased-sector call succeeds, while avoidance of a second physical erase follows from the reviewed early-return branch rather than a measured flash-bus trace. Valid calibration-record persistence, append/sector rotation through this backend, interrupted operations and runtime-mode enforcement remain unverified. The owner subsequently reported green CI for this backend revision.

## Journal persistence test

`flash_journal_persistence` integrates the eighteen-servo calibration format, software CRC, append/load and FlashJournalStorage. Every servo has distinct synthetic endpoints: angle offset is ID * 10 centidegrees, pulse offset ID * 5 microseconds, with endpoints -4500 + offset / 1000 + offset and 4500 + offset / 2000 - offset respectively. The full expected record uses sequence 1. These are storage-test data, not measured calibration or authorization to operate the robot.

On startup, load scans and validates the journal. If no valid record exists, append writes the complete fixture using the normal occupied-slot/sector policy; the test checks the returned sequence and calibrations, reloads through CRC/decoding/selection, and compares both record and slot. Expected message: `INFO Journal persistence OK: record written`. Existing invalid/occupied slots are not treated as erased; append may reclaim a sector according to its normal policy when necessary.

Restart without another upload. If the latest valid record exactly matches sequence 1 and all eighteen expected calibrations, the test reports `INFO Journal persistence OK: existing record` without appending or erasing. A valid but different record produces `ERROR Unexpected valid record; journal unchanged`. Read/scan errors abort; they do not trigger a write. Equality identifies the expected fixture, not physical servo identity or record provenance. The test neither starts core1/DMA/servo output nor enables robot operation; panic uses panic_halt.

Build with `python tools/dev.py hardware-build`, review map/disassembly, then transfer `firmware/pico/target/thumbv6m-none-eabi/debug/examples/flash_journal_persistence.uf2` in BOOTSEL mode. Use the UART wiring/settings above. Success sets the LED high. Do not run the earlier sector-0 erase tests if this record must be retained.

On 2026-10-30 the owner reported all 39 hardware-build checks passing. Map/disassembly review found both critical routines wholly inside the startup-copied RAM region: erase at 0x20000000, 58 bytes; program at 0x2000003A, 62 bytes. Each contains the five prepared indirect calls without extra helper calls or flash literals. The existing-record branch returns before append. These are build-specific static observations.

The owner received `INFO Journal persistence OK: record written`, then `INFO Journal persistence OK: existing record` after restart without another upload. The owner reported 275 passing tests and all 13 verification checks passing. LED levels were not separately reported. Manual firmware tests do not add unit-test counts. This confirms valid-record persistence, CRC validation, expected sequence and all calibration values across an orderly restart. Succeeding with valid CRC data does not demonstrate hardware rejection of deliberately corrupted records. Sector rotation, interrupted flash operations, power-loss recovery and service-mode integration remain unverified on hardware. The owner subsequently reported green CI for this persistence revision.

## Journal rotation test

`flash_journal_rotation` exercises append/load through FlashJournalStorage with twenty-five complete synthetic eighteen-servo records. It requires two eight-slot sectors. The known sequence-1 persistence fixture or a journal without valid records permits destructive preparation: both sectors are erased through the backend and every slot is checked against 0xFF. Unexpected valid records abort without modification. The exact completed sequence-25 fixture in slot 8 is verified on startup, then completion marker 26 is appended and reloaded in slot 9. On the following restart, only the exact marker fixture in slot 9 authorizes another destructive preparation. No build-time repeat flag is needed. Read/scan errors abort.

Sequence 1 uses the preceding persistence fixture; later records increment each lower pulse endpoint by sequence - 1 microseconds, so record contents differ. After every append, the test checks sequence, values and expected slot (sequence - 1) modulo 16, then reloads and compares the record and slot. Sequences 1-8 occupy sector 0; 9-16 occupy sector 1; 17-24 reuse sector 0; sequence 25 reuses sector 1. At each switch (9/17/25), a full snapshot verifies that the previous sector remains byte-for-byte unchanged. All seven trailing target slots must be 0xFF; at 17 and 25 this confirms removal of stale records when reclaiming the sector.

Build with `python tools/dev.py hardware-build`, inspect map/disassembly, and transfer `firmware/pico/target/thumbv6m-none-eabi/debug/examples/flash_journal_rotation.uf2` in BOOTSEL mode. Use the established UART settings and no attached servos. The preparation intentionally destroys both journal sectors. Expected first result: `INFO Journal rotation OK: sequence 25 written`. Restart without another upload: sequence 25 is verified and marker 26 is appended; expect `INFO Journal rotation OK: completion sequence 26 written`. Restart again: marker 26 is verified, both sectors are prepared, and rotation 1..25 repeats. Success sets the LED high. Before marker append, slots 9..15 must all be erased; otherwise the test aborts before writing. This ensures append uses free slot 9 without reclaiming a sector. The initial sequence-25 branch no longer returns without writing. Intermediate valid sequences 2-24 are deliberately rejected after an interrupted run; this test does not implement automatic continuation. An interrupted run at sequence 1 can match the preparation fixture and restart the test. Fixture equality is not proof of provenance or physical servo identity.

On 2026-10-30 the owner reported all 41 hardware-build checks passing. Map/disassembly review found the erase wrapper at 0x20000000 (58 bytes) and program wrapper at 0x2000003A (62 bytes), both entirely in the startup-copied RAM section with five indirect calls and no extra helper calls or flash literals. The owner received the expected sequence-25-written message followed by the existing-sequence-25 message after restart. LED levels were not separately reported. The owner subsequently reported 275 passing tests and all 13 verification checks passing. These manual programs do not add unit-test counts.

This verifies normal sector rotation, reclaiming both sectors, newest-record selection and persistence across an orderly restart. It does not establish recovery from interrupted erase/programming, power loss or a faulty flash device. The test starts no second core, DMA or servo output and uses panic_halt. Synthetic fixtures are not measured robot calibration. CI for this rotation revision is pending.

### Rotation progress and automatic repeat

The rotation test now queues `Journal preparation started/complete` and, around each append and full verification, `Journal write: seq=N sector=S slot=L` and `Journal verified: seq=N sector=S slot=L`. Slot L is local to its sector (0..7). A small stack formatter needs no heap or external crate. Logger servicing uses a finite byte budget without waiting for the UART to become ready. Logging happens only while XIP is active; queued messages can be transmitted later. The 4096-byte test-only queue accommodates the bounded progress transcript plus the final result. Production logging policy is unchanged.

The commented boot sequence is rotation to 25 -> restart and append verified marker 26 -> restart and repeat rotation to 25. Marker 26 uses the same fixture formula with lower pulse endpoints offset by 25 microseconds from sequence 1. Both marker states require exact calibration values and the expected slot before proceeding. This is test orchestration, not an application recovery policy. Interrupted marker writes can leave an occupied slot and cause a later erased-slot precheck to fail; interrupted preparation or mid-rotation runs are not automatically recovered. Fixture matching is not authentication. Each repeated full run performs real flash programming/erasure.

On 2026-10-30 the owner confirmed that progress output and the automatic 25 -> 26 -> preparation/rotation-to-25 restart cycle work as described. The updated hardware build passed all 41 checks; the owner subsequently reported 275 passing tests and all 13 verification checks passing. Fresh map/disassembly inspection confirmed the complete 58-byte erase and 62-byte program wrappers in copied RAM, each with five indirect calls and no extra flash accesses. The assistant did not execute builds or tests. This supersedes the earlier no-write sequence-25 startup observation; interrupted-operation and power-loss recovery remain unverified. CI for the combined rotation/progress/repeat revision is pending.

## Regular output stop test

[stop_output.rs](stop_output.rs) is a manual, hardware-tests-only example. Use unloaded GP0/GP1 against Pico GND and UART1 TX on GP20 to a 3.3 V TTL receiver, common GND, 115200 baud, 8N1. No servo is needed.

Build with `python tools/dev.py hardware-build` and copy `firmware/pico/target/thumbv6m-none-eabi/debug/examples/stop_output.uf2` to the Pico in BOOTSEL mode. Initially GP0 has a 1 ms High pulse and GP1 a 2 ms High pulse in a 20 ms period; the LED blinks. After five seconds the test submits a replacement without servicing it, then stops output. It checks Inactive, absence of an owned DMA transfer, no fault, successful repeated stop and Stopped rejection of subsequent plan submission. Continued servicing must not resume output. Both pins stay Low and the LED stays on.

Expected UART messages:

```text
INFO Stop test: initial plan running
INFO Stop test OK: output inactive; DMA stopped
```

The owner confirmed the expected signals, LED and messages on 2026-11-01, then reran restart_active_dma and restart_abort_timeout successfully. Full verification reported 405 tests passing and all 17 checks passing; manual examples do not add unit-test counts. The stop test does not exercise its DMA-timeout branch or prove that an old pending plan cannot reappear after ordinary startup; that startup path remains to be implemented. CI for this revision is pending.

## Regular start after stop test

[start_after_stop.rs](start_after_stop.rs) is a manual hardware-tests-only example using unloaded GP0/GP1 and UART1 TX on GP20, common GND, a 3.3 V TTL receiver and 115200 baud, 8N1. Build with `python tools/dev.py hardware-build` and upload `firmware/pico/target/thumbv6m-none-eabi/debug/examples/start_after_stop.uf2` in BOOTSEL mode.

For five seconds GP0 has a 1 ms High pulse and GP1 a 2 ms High pulse, with a blinking LED. The test queues a 1.5 ms/1.5 ms replacement without servicing it, then stops. Both pins stay Low for two seconds and the LED stays on. Period-mismatched and GPIO-mismatched starts must be rejected while state stays Inactive and no DMA transfer is owned. Ordinary submission while stopped is rejected. A valid start then runs GP0 at 2 ms and GP1 at 1 ms with the LED blinking again. A second start on active output must fail without replacing this plan. The discarded 1.5 ms/1.5 ms plan must not reappear during observation.

Expected UART messages:

```text
INFO Start test: initial plan running
INFO Start test: stopped; invalid starts rejected
INFO Start test OK: replacement plan running
```

On 2026-11-01 the owner confirmed the stated signal behavior and final success message, then reported 405 tests and all 17 verification checks passing. This is a manual GPIO test without attached servos, not an automated timing measurement or proof that no brief transient can occur. Manual firmware examples do not add unit-test counts. Ordinary startup does not recover latched faults; stop-specific abort-timeout injection remains a separate test gap. CI for this revision is pending.

## ServoBank lifecycle hardware test

[servo_bank_lifecycle.rs](servo_bank_lifecycle.rs) exercises ServoBank -> PulseBankLifecycle -> ServoSignalOutput -> SignalPlanLifecycle -> SwitchingOutput on unloaded GP0/GP1. Use common Pico GND and UART1 TX on GP20 to a 3.3 V TTL receiver at 115200 baud, 8N1. Synthetic calibration maps -45/0/+45 degrees to 1000/1500/2000 us for both channels. No physical servo calibration or movement is verified.

The current driver constructor starts a bootstrap plan, so brief 1.5 ms pulses can occur during setup. The bank immediately stops it, rejects startup with missing targets, prepares both targets incrementally and verifies atomic rejection of an invalid preparation. This test does not establish inactive-from-boot driver construction.

After setup, expected phases are:

| Phase | Duration | GP0 High | GP1 High | LED |
| --- | --- | --- | --- | --- |
| Prepared | 2 s | Low | Low | On |
| Running | 5 s | 1 ms | 2 ms | Blinking |
| Stopped, only servo 0 changed | 2 s | Low | Low | On |
| Started again | Continuous | 1.5 ms | 2 ms | Blinking |

Stop is invoked twice to check idempotency. The second target must remain at +45 degrees when only the first is changed to zero. All lifecycle operations after setup use the bank; servicing must not restart stopped output. Build with `python tools/dev.py hardware-build`, then upload `firmware/pico/target/thumbv6m-none-eabi/debug/examples/servo_bank_lifecycle.uf2` in BOOTSEL mode. The final expected message is `INFO Bank lifecycle OK: updated angles running`.

On 2026-11-01 the owner reported all 47 hardware-build checks passing, confirmed the principal signal sequence and accepted the hardware test as successful after further starts. The test is finite; repeated-cycle endurance testing remains future work. The preceding bank-lifecycle implementation passed CI. The owner subsequently reported 415 tests and all 17 verification checks passing for this hardware-example revision. CI is pending.

## Protocol UART byte-transport loopback

[uart_loopback.rs](uart_loopback.rs) exercises [UartTransport](../src/uart_transport.rs), the real nonblocking ByteTransport implementation. Before starting, connect GP16 (UART0 TX) directly to GP17 (UART0 RX). Debug output remains on UART1 TX/GP20 to a 3.3 V TTL receiver with common GND, 115200 baud, 8N1. UART0 also uses 115200 baud, 8N1. No PC protocol adapter or servo is needed for this loopback.

Build with `python tools/dev.py hardware-build`, then upload `firmware/pico/target/thumbv6m-none-eabi/debug/examples/uart_loopback.uf2` in BOOTSEL mode. The test sends 1024 bytes, covering byte values 0..255 four times, and verifies every received byte in order. It attempts at most one send and one receive per loop iteration and services debug logging without waiting. A two-second overall test deadline catches a missing jumper or stalled transfer; it is not the protocol receive/response timeout. Success sets the LED high and logs:

```text
INFO UART loopback started
INFO UART loopback OK
```

On 2026-11-02 the owner reported both expected messages, confirming successful transmission and matching reception of all 1024 bytes. LED behavior was not separately reported. Full verification subsequently reported 451 tests and all 17 checks passing. This manual program adds no host unit tests and does not exercise framing, register commands, the FrameProcessor, injected UART errors or physical servo output. UART0 stops sending test data after completion. CI for this UART-driver revision is pending.

The GP16/GP17 assignment is for the current test setup. Final servo/communication/measurement pin allocation and schematic changes remain separate decisions; no hardware design files are changed by this example.

## UART register request/response test

Current development update: Status now transfers four little-endian bytes. Rebuild and flash the firmware before using the revised suite. On 2026-11-03 the owner confirmed all 21 revised scenarios passing after this width change. The 78 register host tests also passed; full local verification passed 465 tests and all 17 checks; CI for the width change has not yet been reported.

[uart_registers.rs](uart_registers.rs) connects the real UartTransport, FrameProcessor and RegisterService with the test-only [NoServoOutput](support/no_servo_output.rs) backend. It has no calibration or physical servo outputs and reports ProtocolVersion=2, Status=0 and ServoCount=0. Normal Pico firmware is unchanged.

Build with `python tools/dev.py hardware-build` and upload `firmware/pico/target/thumbv6m-none-eabi/debug/examples/uart_registers.uf2` in BOOTSEL mode. Remove the GP16-GP17 loopback jumper. Connect GP16/TX to the USB adapter RXD, GP17/RX to adapter TXD, and common GND. Use 3.3 V TTL, 115200 baud, 8N1 and no flow control. In HTerm, use HEX input/display without automatic CR/LF, send each request as one byte sequence and await its reply before sending another. Protocol UART0 carries binary replies only; debug text stays on UART1/GP20. The LED is expected to blink while the loop runs.

The canonical [UART test vectors](../../../docs/uart-register-test-vectors.md) contain the current protocol-version-2 wire layout, complete requests and ACK/NACK responses, CRC details and the 21-scenario JSON suite. Expected fixture values are Version=2, Status=0, Control=0 and ServoCount=0. Unknown indices and implausible lengths receive no reply; plausible prohibited operations receive NACK. LastError no longer exists.

The receive loop uses 32-byte receive/transmit budgets and a provisional 100-ms receive-idle timeout. The suite uses 200-ms no-reply observations and a 1000-ms timeout for complete responses. The runner now finishes successful response steps after an additional 20-ms settling window; a hardware run with this shorter policy is pending. Run the suite with HTerm closed:

```bash
python tools/uart_test.py --port COM5 --suite uart_registers
```

On 2026-11-02 the owner reported 21 passing scenarios and green CI for the previous version-1 suite. On 2026-11-03 the owner also reported all 21 version-2 scenarios passing on real hardware (0 failed, 0 not completed). Use the rebuilt version-2 firmware for this suite; CI for the current revision has not yet been reported. Manual hardware suites remain outside CI and host unit-test counts.

## UART calibration persistence

[uart_calibration_persistence.rs](uart_calibration_persistence.rs) adds the real FlashJournalStorage backend and test-only write/erase counters to the no-servo UART path. It checks every accepted persistence result against a journal reload and verifies that identical data changes neither counters nor slot/sequence. Diagnostic UART1 reports the boot record and each checked result. The reserved journal is updated with synthetic data; no servo output, DMA or core1 is started.

The owner reported all 53 hardware-build checks passing on 2026-11-04. On 2026-11-04 the owner confirmed all three UART cases passing after restart with the five-second response timeout; the subsequent boot confirmed fixture B at sequence 28, slot 11. See the [complete hardware procedure](../../../docs/uart-calibration-persistence.md) for firmware upload, suite invocation, status polling, expected logs and evidence limits.

For the completed UART calibration persistence revision, the owner reported all three hardware scenarios passing, B surviving restart at sequence 28/slot 11, and full local verification with 520 tests and all 17 checks passing on 2026-11-04. The parser's retained-candidate optimization passed all 87 protocol tests and eliminated the observed RX overrun in the successful hardware runs; no arbitrary sustained-throughput guarantee is implied. CI for this combined revision has not yet been reported.

## UART throughput benchmark

`uart_benchmark` exercises COBS/CRC32 commands with synthetic calibration for 18 logical servos and a simulated active pulse sink, without physical output or flash/EEPROM access. The PC tool enables it and supplies a complete initial pose before measuring partial or full updates. The owner completed the documented sink18 measurements at all three baud rates. An explicit PC-tool `--fixture pio2` mode instead reuses uart_commands at 115200 baud for paced and overload output tests; the owner confirmed the 60-second paced and overload runs, including correct pulse behavior; the overload run accepted 50.0 updates/s with expected Busy backpressure and no other errors. Detailed results and limits are in the benchmark guide. Build it with `python tools/dev.py hardware-build`. See [setup, jumper selection, measurements and current findings](../../../docs/uart-benchmark.md).

## Inactive initialization and COBS commands

`inactive_output` checks Low startup without bootstrap pulses, then explicit start/stop/start; the owner confirmed the specified hardware behavior. `uart_commands` adds UART0 COBS/CRC32 command processing with two real PIO/DMA channels and synthetic calibration. See [build, wiring, response suites and scope verification](../../../docs/uart-command-tests.md). On 2026-11-06 the owner reported all 23 command-suite cases passing, followed by the separate scope case passing and correct signal observations. No sustained-throughput result is claimed.
