ebe542/hexaroam/hardware/electronics/pico-servo-system/pico-servo-system.pdf

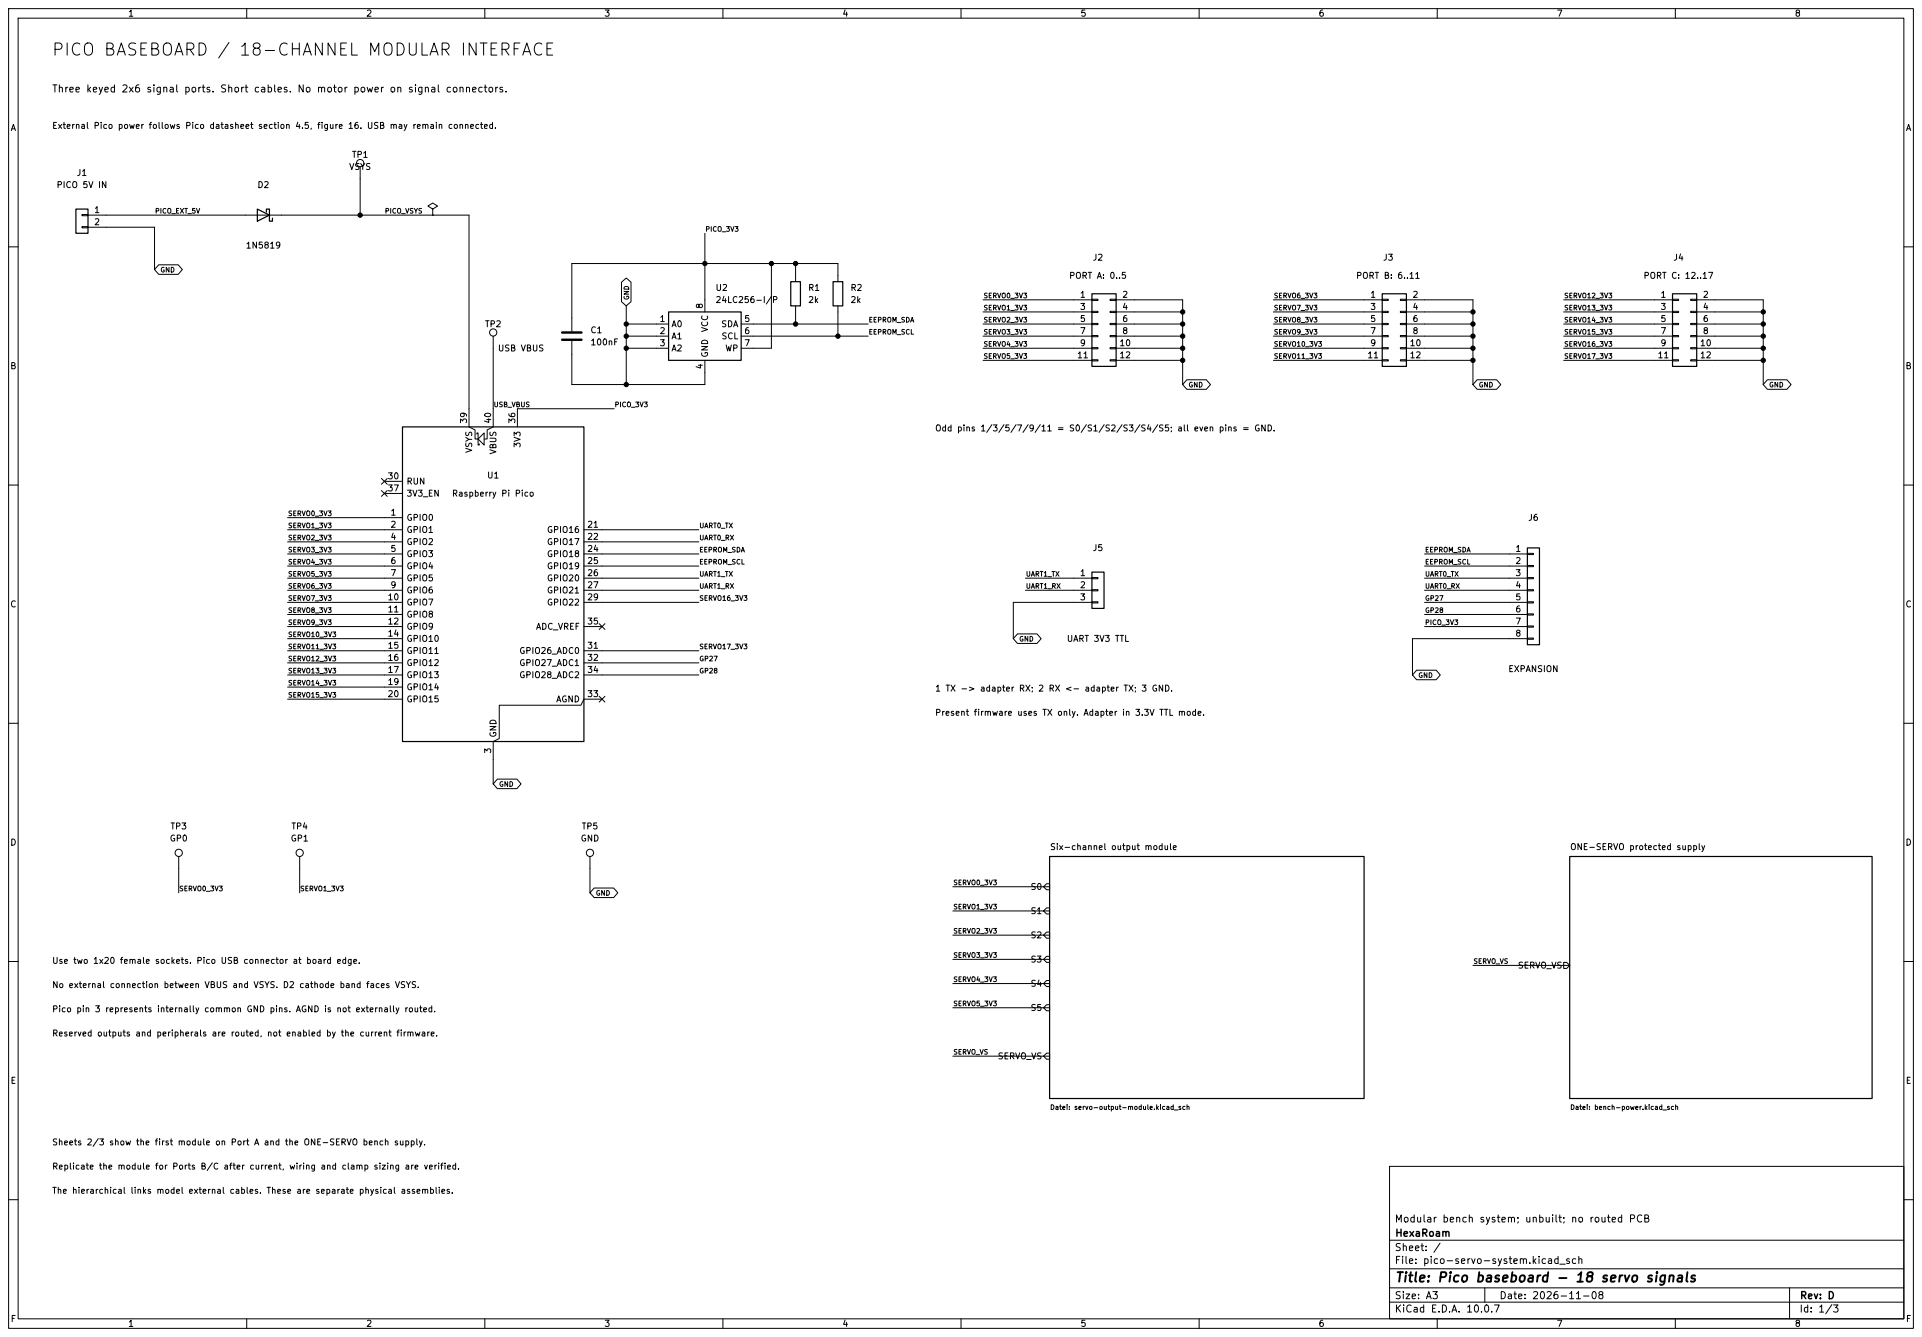
[picture p23: page 1]

PICO BASEBOARD / 18-CHANNEL MODULAR INTERFACE

External Pico power follows Pico datasheet section 4.5, figure 16. USB may remain connected. Three keyed 2x6 signal ports. Short cables. No motor power on signal connectors.

Odd pins 1/3/5/7/9/11 = S0/S1/S2/S3/S4/S5; all even pins = GND. Pico pin 3 represents internally common GND pins. AGND is not externally routed. Reserved outputs and peripherals are routed, not enabled by the current firmware. Replicate the module for Ports B/C after current, wiring and clamp sizing are verified.

Six-channel output module

The hierarchical links model external cables. These are separate physical assemblies. Sheets 2/3 show the first module on Port A and the ONE-SERVO bench supply.

Modular bench system; unbuilt; no routed PCB
HexaRoam
Sheet: /
File: pico-servo-system.kicad_sch
Title: Pico baseboard - 18 servo signals

Size: A3 | Rev: D | F Date: 2026-11-08
KiCad E.D.A. 10.0.7 | Id: 1/3

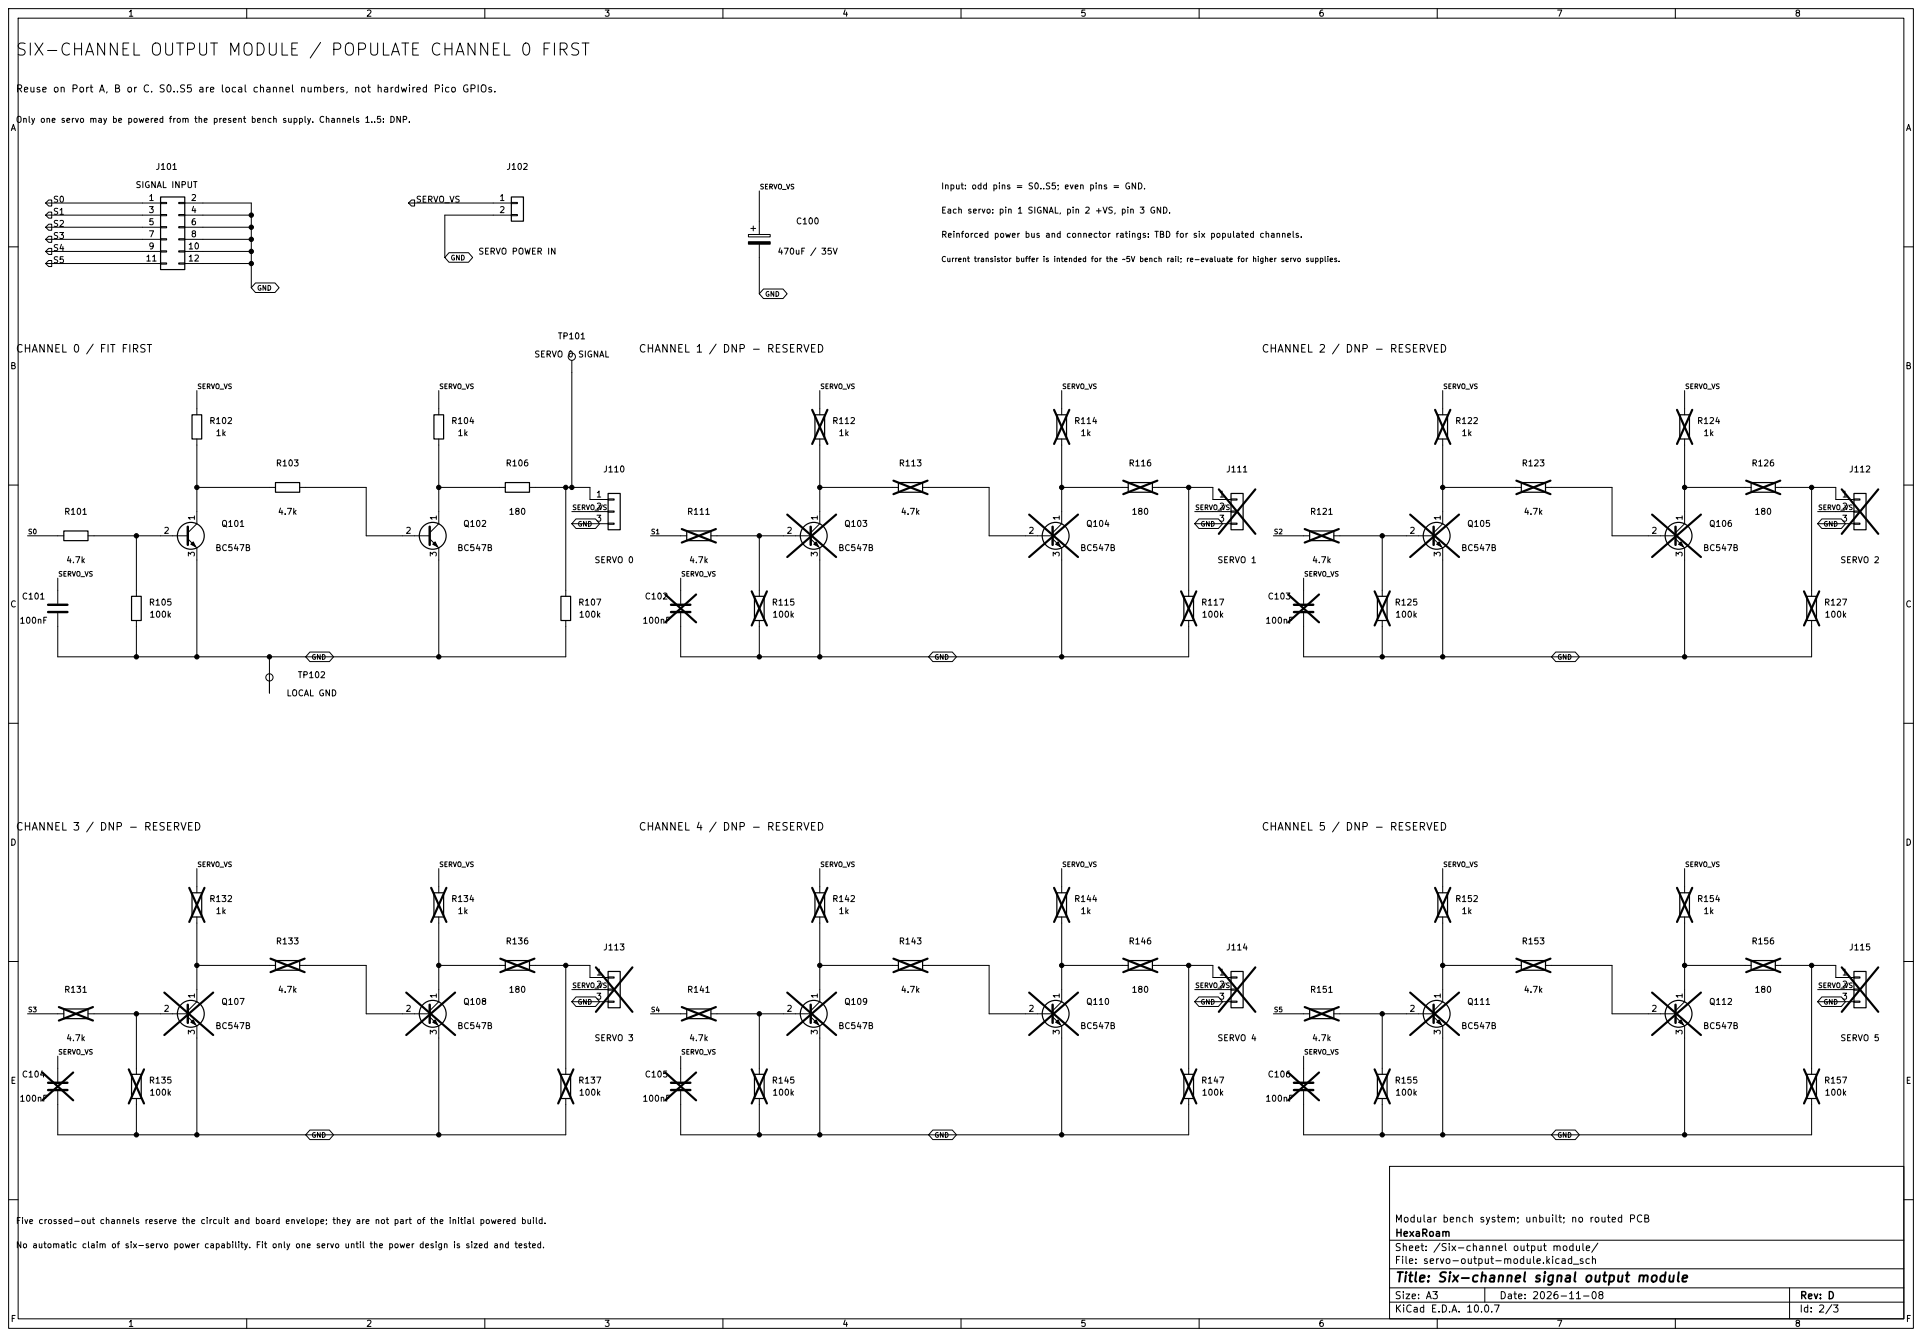
[picture p24: page 2]

SIX-CHANNEL OUTPUT MODULE / POPULATE CHANNEL 0 FIRST

Only one servo may be powered from the present bench supply. Channels 1..5: DNP. Reuse on Port A, B or C. S0..S5 are local channel numbers, not hardwired Pico GPIOs.

Input: odd pins = S0..S5; even pins = GND. Each servo: pin 1 SIGNAL, pin 2 +VS, pin 3 GND.

Current transistor buffer is intended for the ~5V bench rail; re-evaluate for higher servo supplies.

Five crossed-out channels reserve the circuit and board envelope; they are not part of the initial powered build.

Modular bench system; unbuilt; no routed PCB
HexaRoam
Sheet: /Six-channel output module/
File: servo-output-module.kicad_sch
Title: Six-channel signal output module

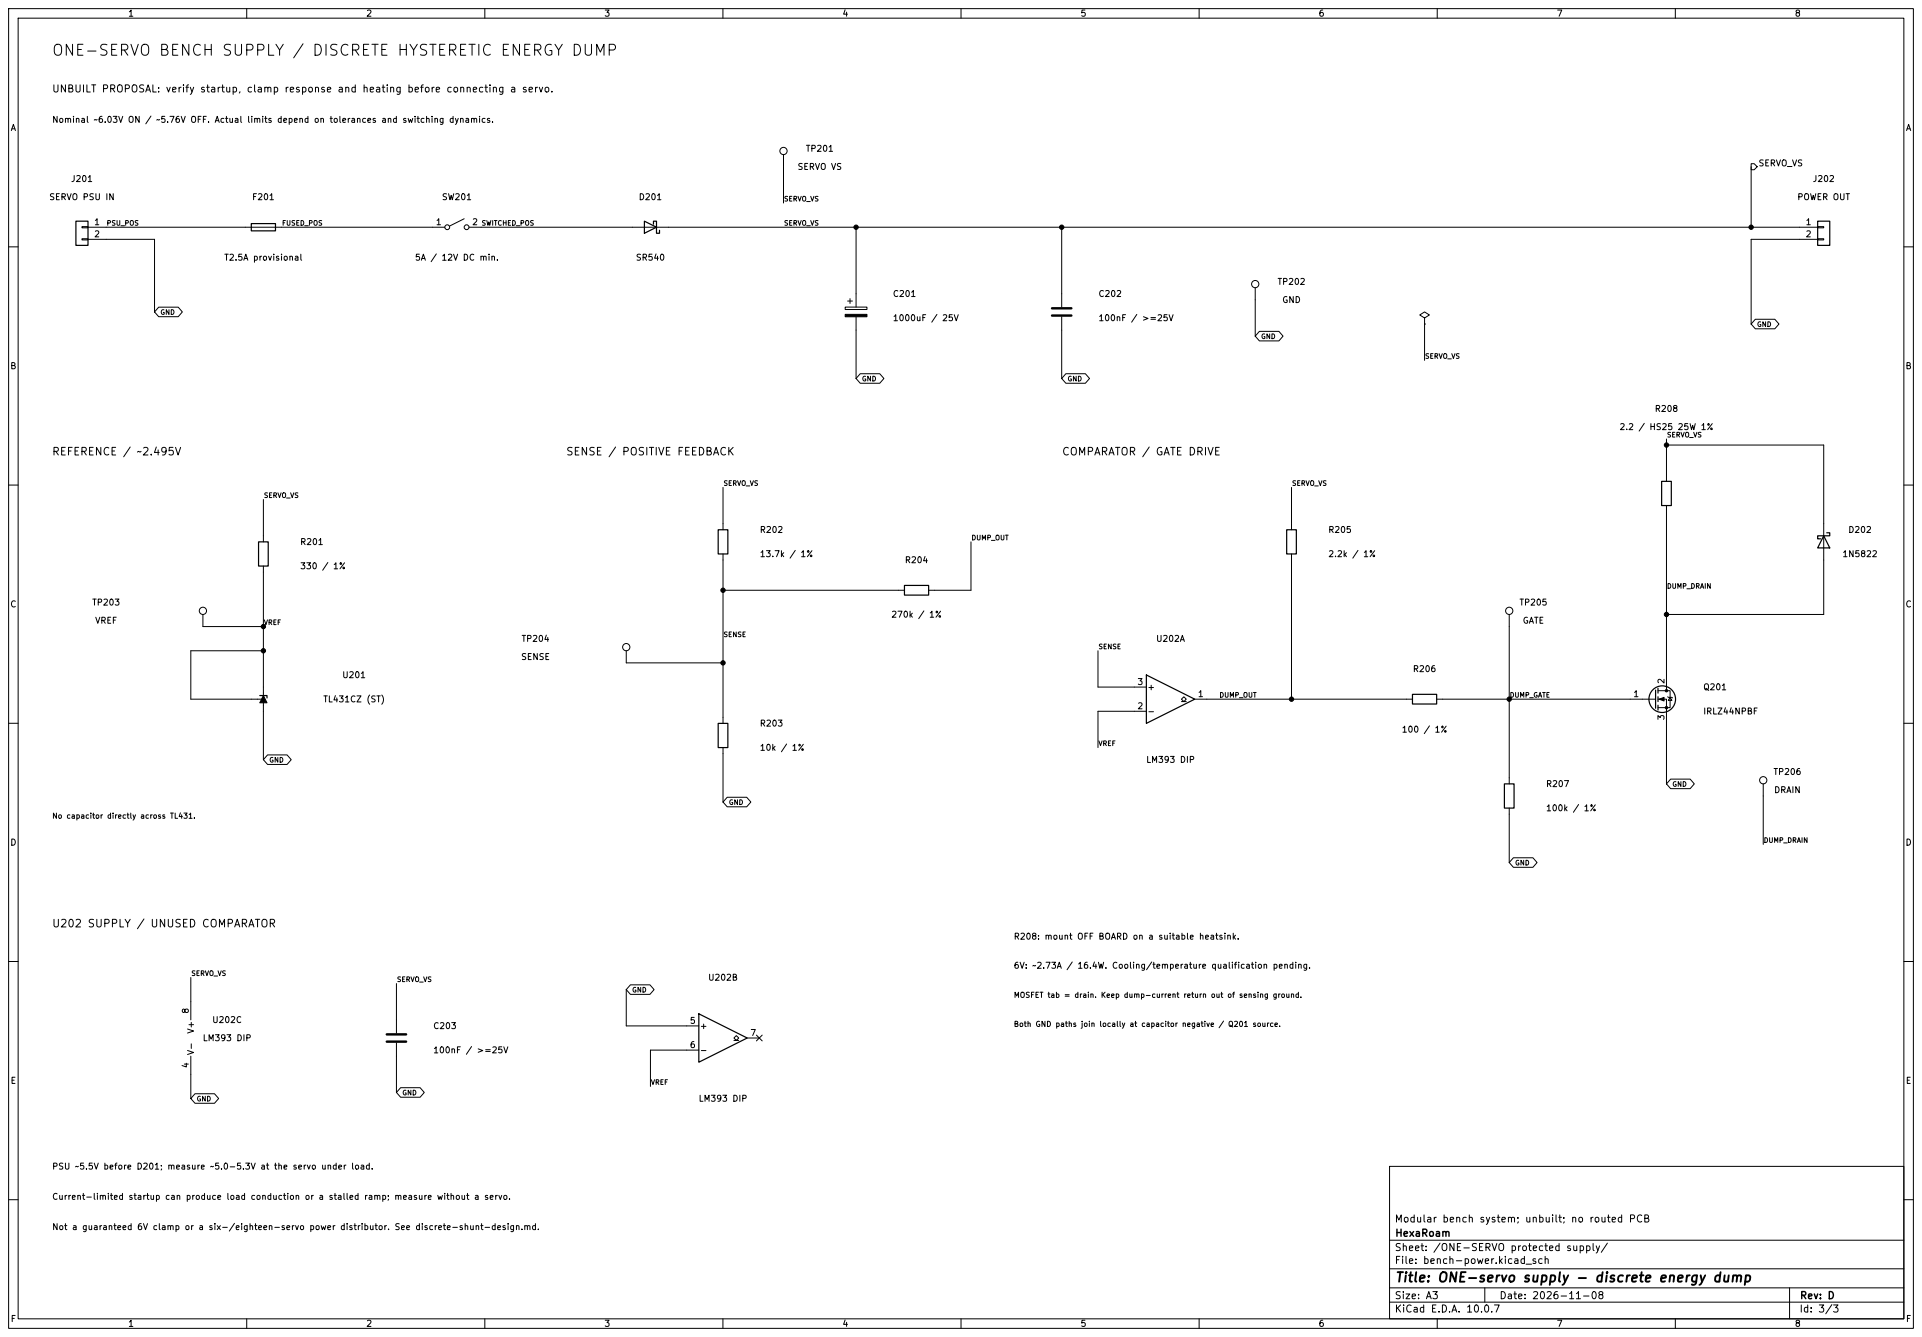
[picture p25: page 3]

ONE-SERVO BENCH SUPPLY / DISCRETE HYSTERETIC ENERGY DUMP

UNBUILT PROPOSAL: verify startup, clamp response and heating before connecting a servo.

Nominal ~6.03V ON / ~5.76V OFF. Actual limits depend on tolerances and switching dynamics.

No capacitor directly across TL431.

Both GND paths join locally at capacitor negative / Q201 source.

Modular bench system; unbuilt; no routed PCB
HexaRoam
Sheet: /ONE-SERVO protected supply/
File: bench-power.kicad_sch
Title: ONE-servo supply - discrete energy dump
