ebe542/hexaroam/hardware/electronics/single-servo-test-board/single-servo-test-board.pdf

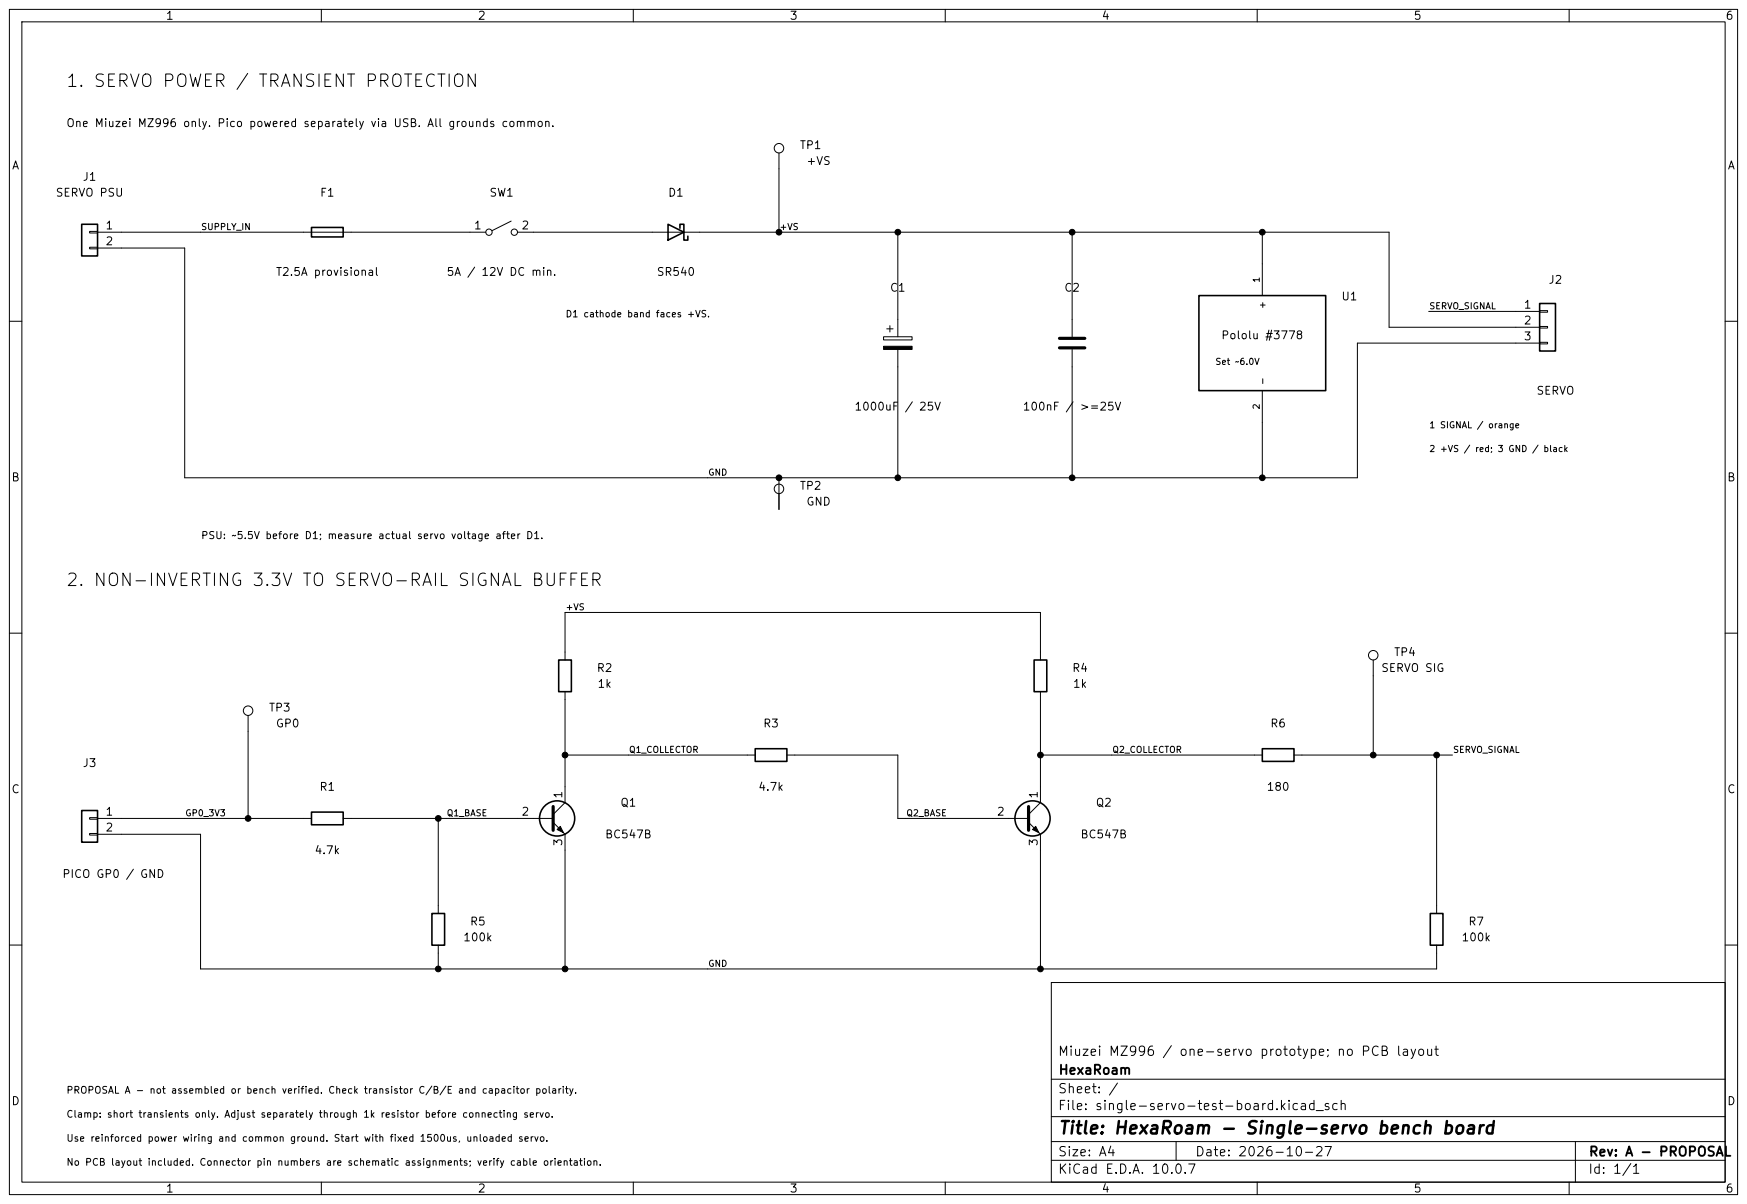
[picture p26: page 1]

One Miuzei MZ996 only. Pico powered separately via USB. All grounds common. 1. SERVO POWER / TRANSIENT PROTECTION

2 +VS / red; 3 GND / black Set ~6.0V

PSU: ~5.5V before D1; measure actual servo voltage after D1. 2. NON-INVERTING 3.3V TO SERVO-RAIL SIGNAL BUFFER

Miuzei MZ996 / one-servo prototype; no PCB layout
HexaRoam
Sheet: /
File: single-servo-test-board.kicad_sch
Title: HexaRoam - Single-servo bench board

Clamp: short transients only. Adjust separately through 1k resistor before connecting servo.

No PCB layout included. Connector pin numbers are schematic assignments; verify cable orientation.
