ebe542/hexaroam/hardware/electronics/servo-power-re200-lf/servo-power-re200-lf.kicad_pcb

## KiCad design hardware/electronics/servo-power-re200-lf/servo-power-re200-lf.kicad_pcb (2026-10-27)

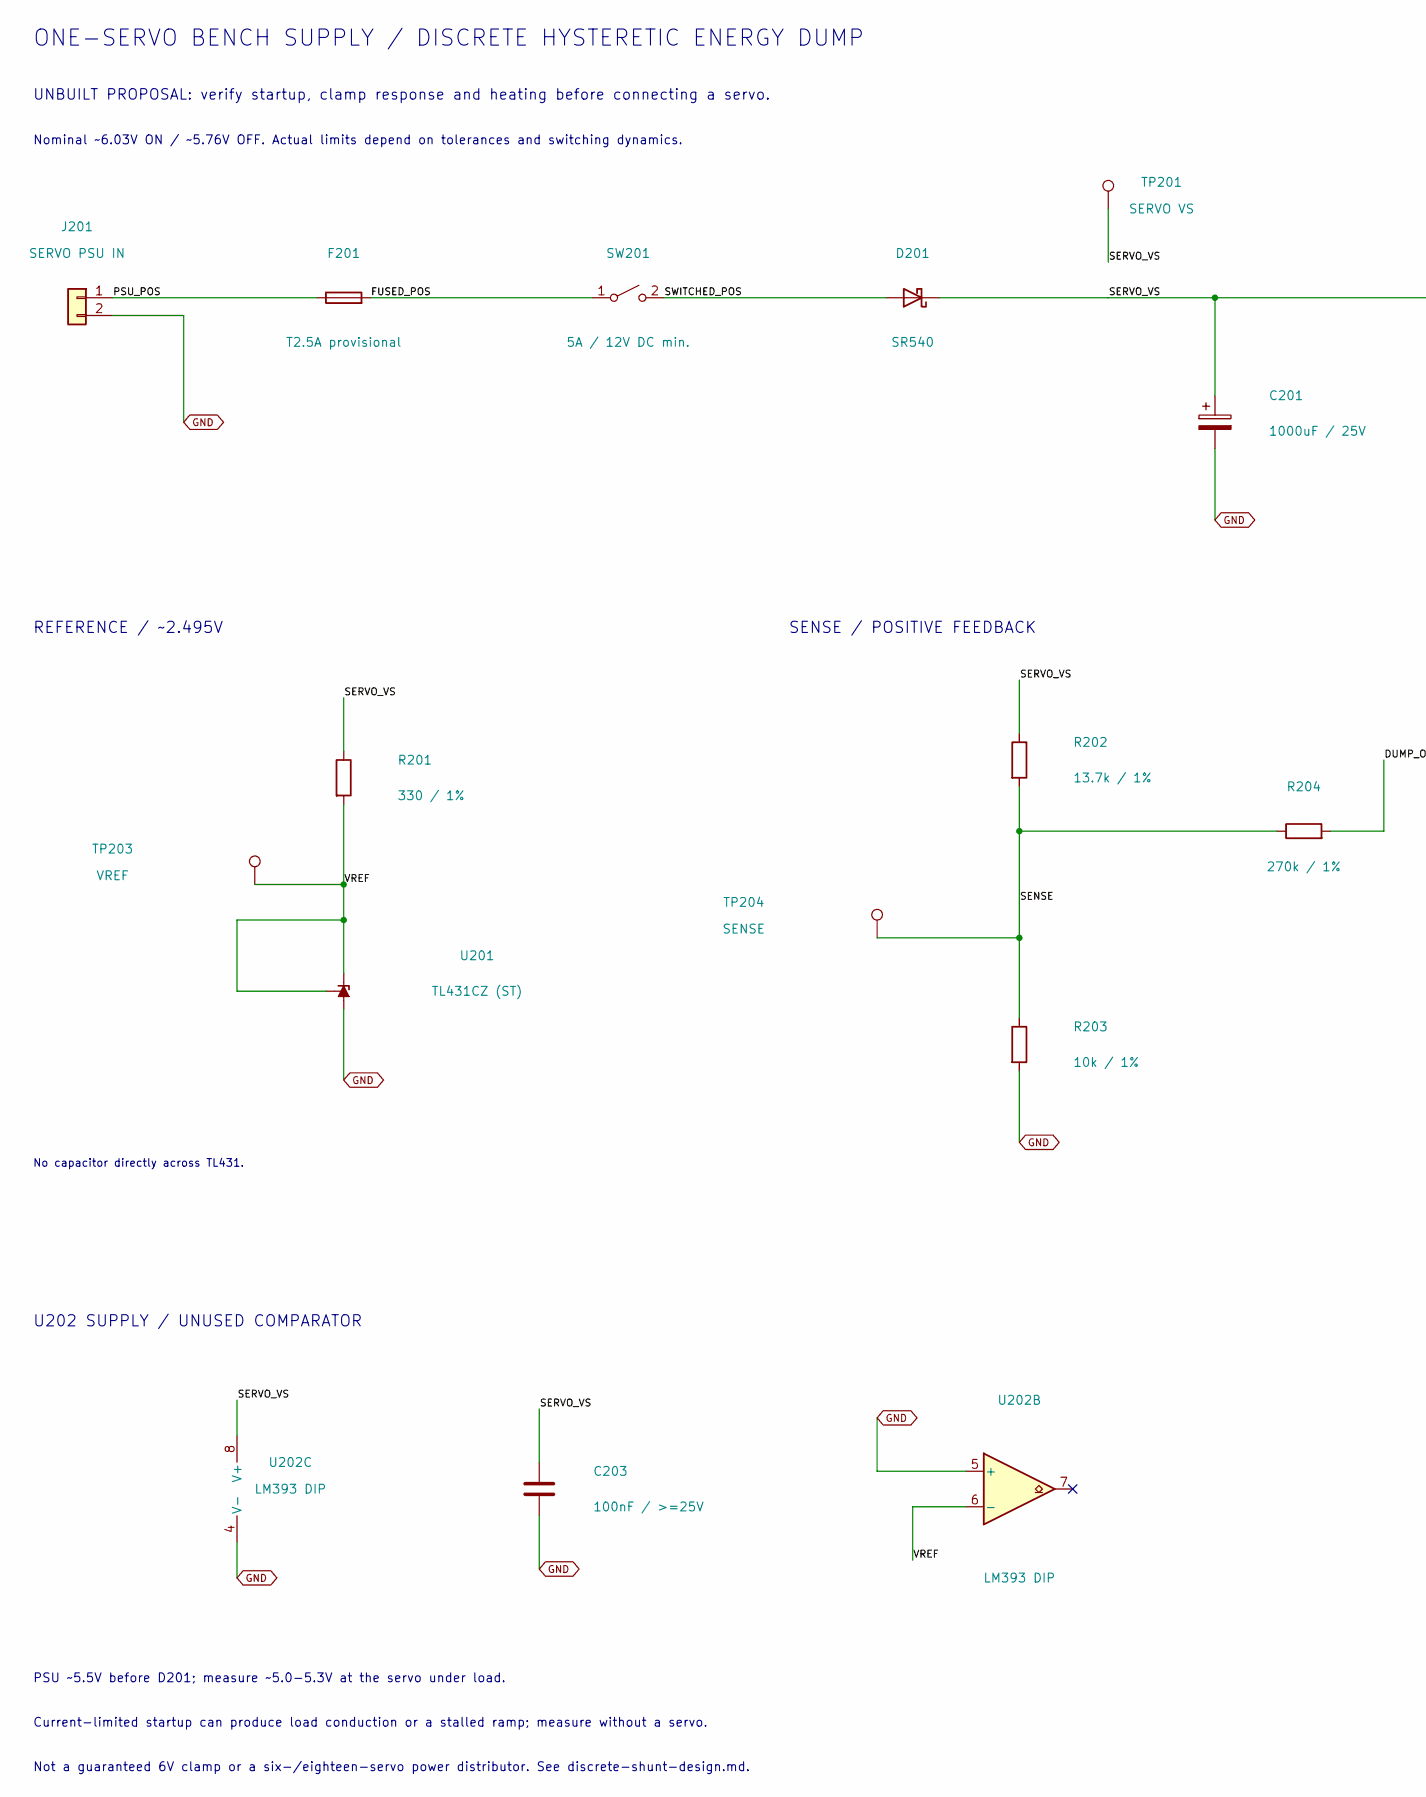
[picture p27: schematic bench-power.kicad_sch, ONE-servo supply - discrete energy dump, part in row 1, column 1]

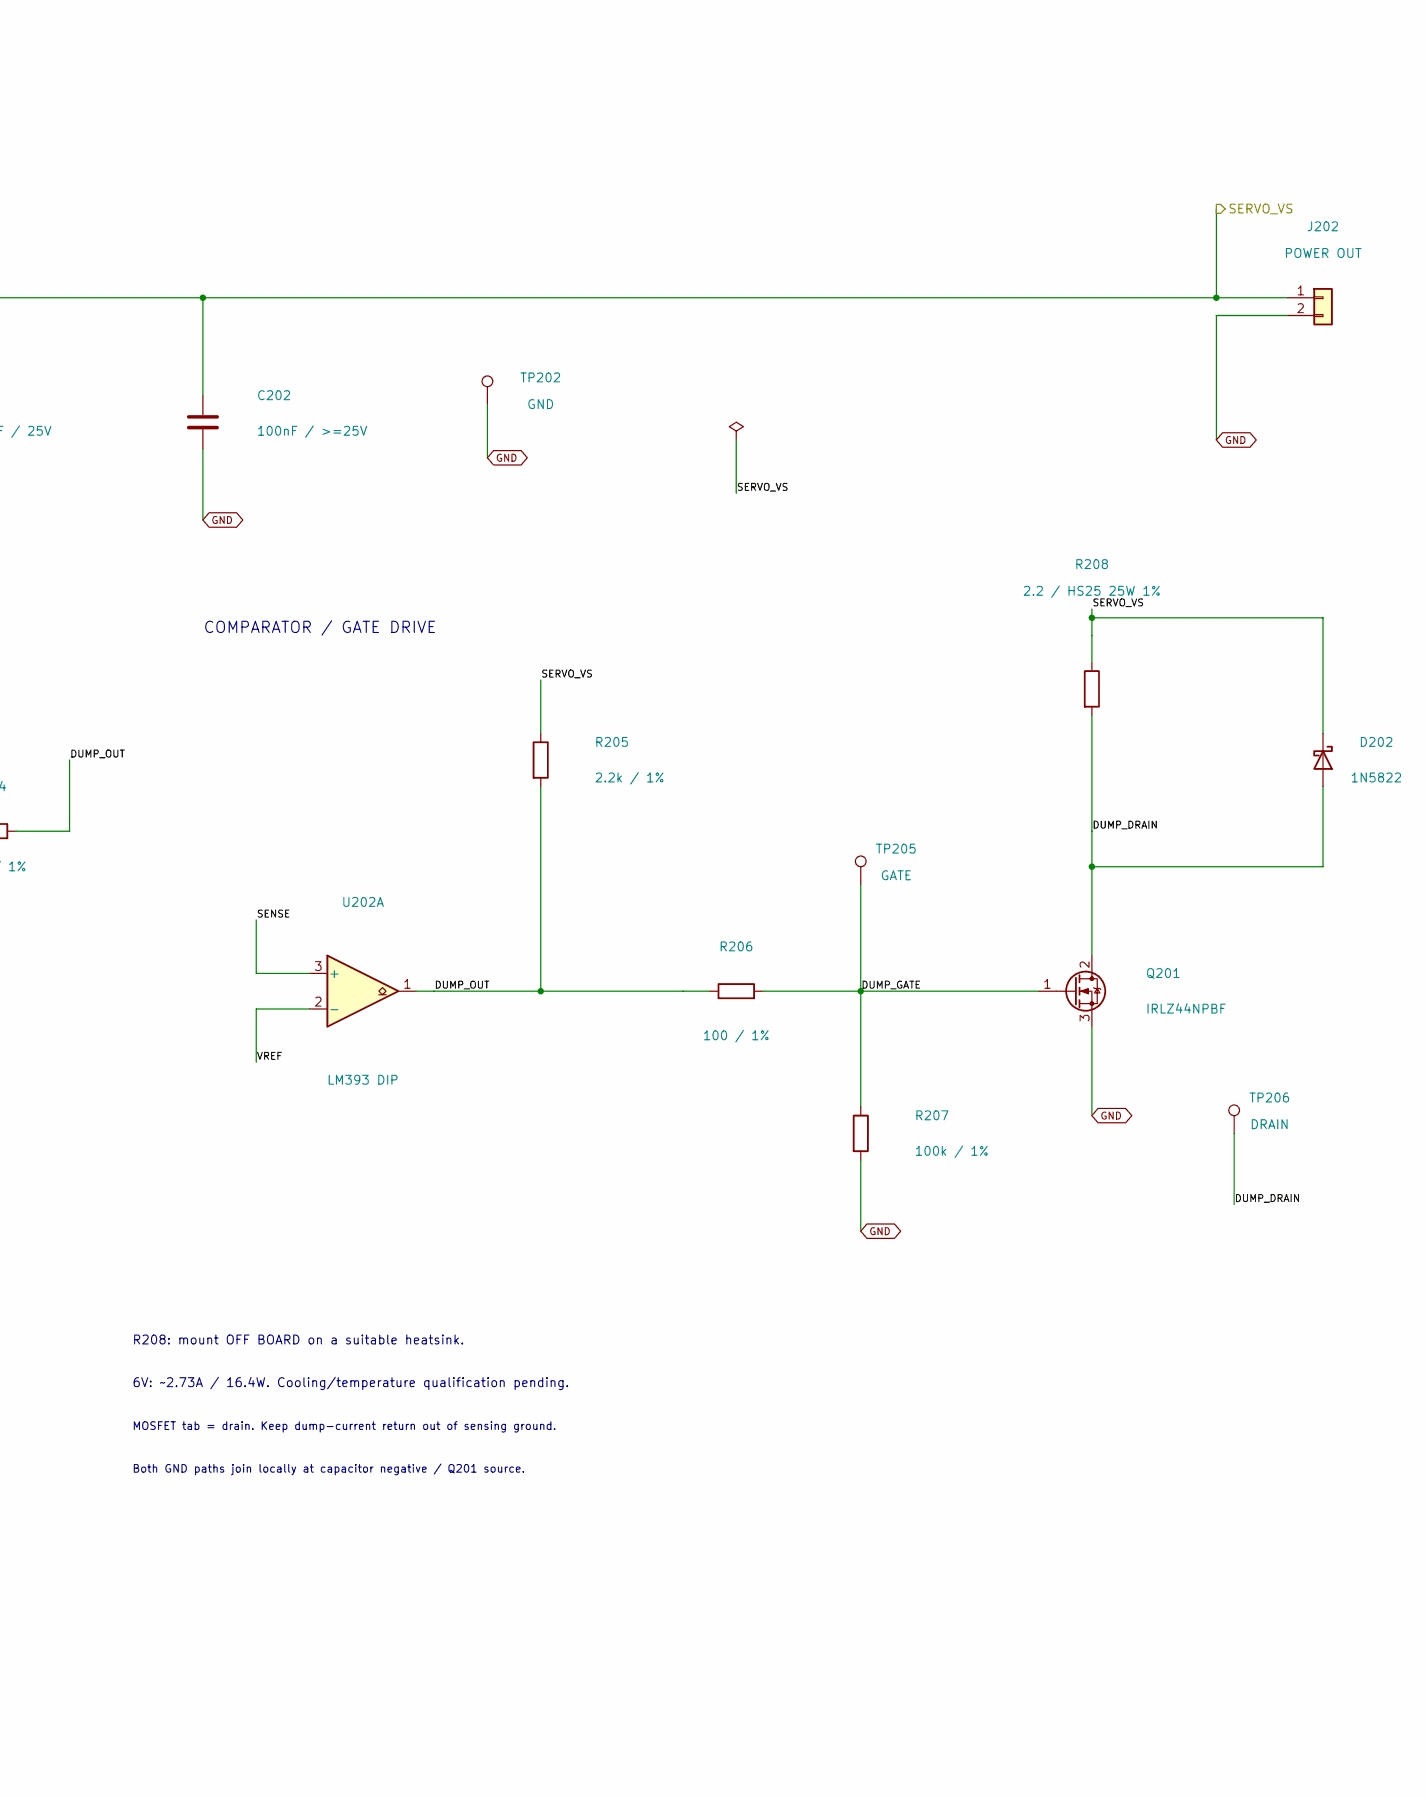
[picture p28: schematic bench-power.kicad_sch, ONE-servo supply - discrete energy dump, part in row 1, column 2]

Parts:
C201: 1000uF / 25V
C202, C203: 100nF / >=25V
D201: SR540
D202: 1N5822
F201: T2.5A provisional
J201: SERVO PSU IN
J202: POWER OUT
Q201: IRLZ44NPBF; TO-220-3_Vertical
R201: 330 / 1%
R202: 13.7k / 1%
R203: 10k / 1%
R204: 270k / 1%
R205: 2.2k / 1%
R206: 100 / 1%
R207: 100k / 1%
R208: 2.2 / HS25 25W 1%
SW201: 5A / 12V DC min.
TP201: SERVO VS
TP202: GND
TP203: VREF
TP204: SENSE
TP205: GATE
TP206: DRAIN
U201: TL431CZ (ST); TO-92_Inline
U202: LM393 DIP; DIP-8_W7.62mm

Connections:
/ONE-SERVO protected supply/DUMP_DRAIN: D202.2 (A), Q201.2 (D), R208.2, TP206.1; also elsewhere on the board
/ONE-SERVO protected supply/DUMP_GATE: Q201.1 (G), R206.2, R207.1, TP205.1
/ONE-SERVO protected supply/DUMP_OUT: R204.2, R205.2, R206.1, U202.1
/ONE-SERVO protected supply/FUSED_POS: F201.2, SW201.1 (A)
/ONE-SERVO protected supply/PSU_POS: F201.1, J201.1
/ONE-SERVO protected supply/SENSE: R202.2, R203.1, R204.1, TP204.1, U202.3 (+)
/ONE-SERVO protected supply/SWITCHED_POS: D201.2 (A), SW201.2 (B)
/ONE-SERVO protected supply/VREF: R201.2, TP203.1, U201.1 (REF), U201.3 (K), U202.2 (-), U202.6 (-)
/SERVO_VS: C201.1, C202.1, C203.1, D201.1 (K), D202.1 (K), J202.1, R201.1, R202.1, R205.1, R208.1, TP201.1, U202.8 (V+); also elsewhere on the board
GND: C201.2, C202.2, C203.2, J201.2, J202.2, Q201.3 (S), R203.2, R207.2, TP202.1, U201.2 (A), U202.4 (V-), U202.5 (+); also elsewhere on the board

Notes on the sheet:
ONE-SERVO BENCH SUPPLY / DISCRETE HYSTERETIC ENERGY DUMP
UNBUILT PROPOSAL: verify startup, clamp response and heating before connecting a servo.
Nominal ~6.03V ON / ~5.76V OFF. Actual limits depend on tolerances and switching dynamics.
REFERENCE / ~2.495V
No capacitor directly across TL431.
SENSE / POSITIVE FEEDBACK
COMPARATOR / GATE DRIVE
U202 SUPPLY / UNUSED COMPARATOR
R208: mount OFF BOARD on a suitable heatsink.
6V: ~2.73A / 16.4W. Cooling/temperature qualification pending.
MOSFET tab = drain. Keep dump-current return out of sensing ground.
Both GND paths join locally at capacitor negative / Q201 source.
PSU ~5.5V before D201; measure ~5.0-5.3V at the servo under load.
Current-limited startup can produce load conduction or a stalled ramp; measure without a servo.
Not a guaranteed 6V clamp or a six-/eighteen-servo power distributor. See discrete-shunt-design.md.

Board: 2 copper layers, 30 parts (0 on the bottom side), 10 nets, no tracks yet.

Other parts of the board:
BD: /ONE-SERVO protected supply/DUMP_DRAIN; TestPoint_THTPad_D2.0mm_Drill1.0mm
BG: GND; TestPoint_THTPad_D2.0mm_Drill1.0mm
BV: /SERVO_VS; TestPoint_THTPad_D2.0mm_Drill1.0mm
GS: GND; TestPoint_THTPad_D2.0mm_Drill1.0mm

Their connections:
/ONE-SERVO protected supply/DUMP_DRAIN: BD.1; also elsewhere on the board
/SERVO_VS: BV.1; also elsewhere on the board
GND: BG.1, GS.1; also elsewhere on the board
