ebe542/hexaroam/hardware/electronics/servo-output-re200-lf/servo-output-re200-lf.kicad_pcb

## KiCad design hardware/electronics/servo-output-re200-lf/servo-output-re200-lf.kicad_pcb (2026-10-27)

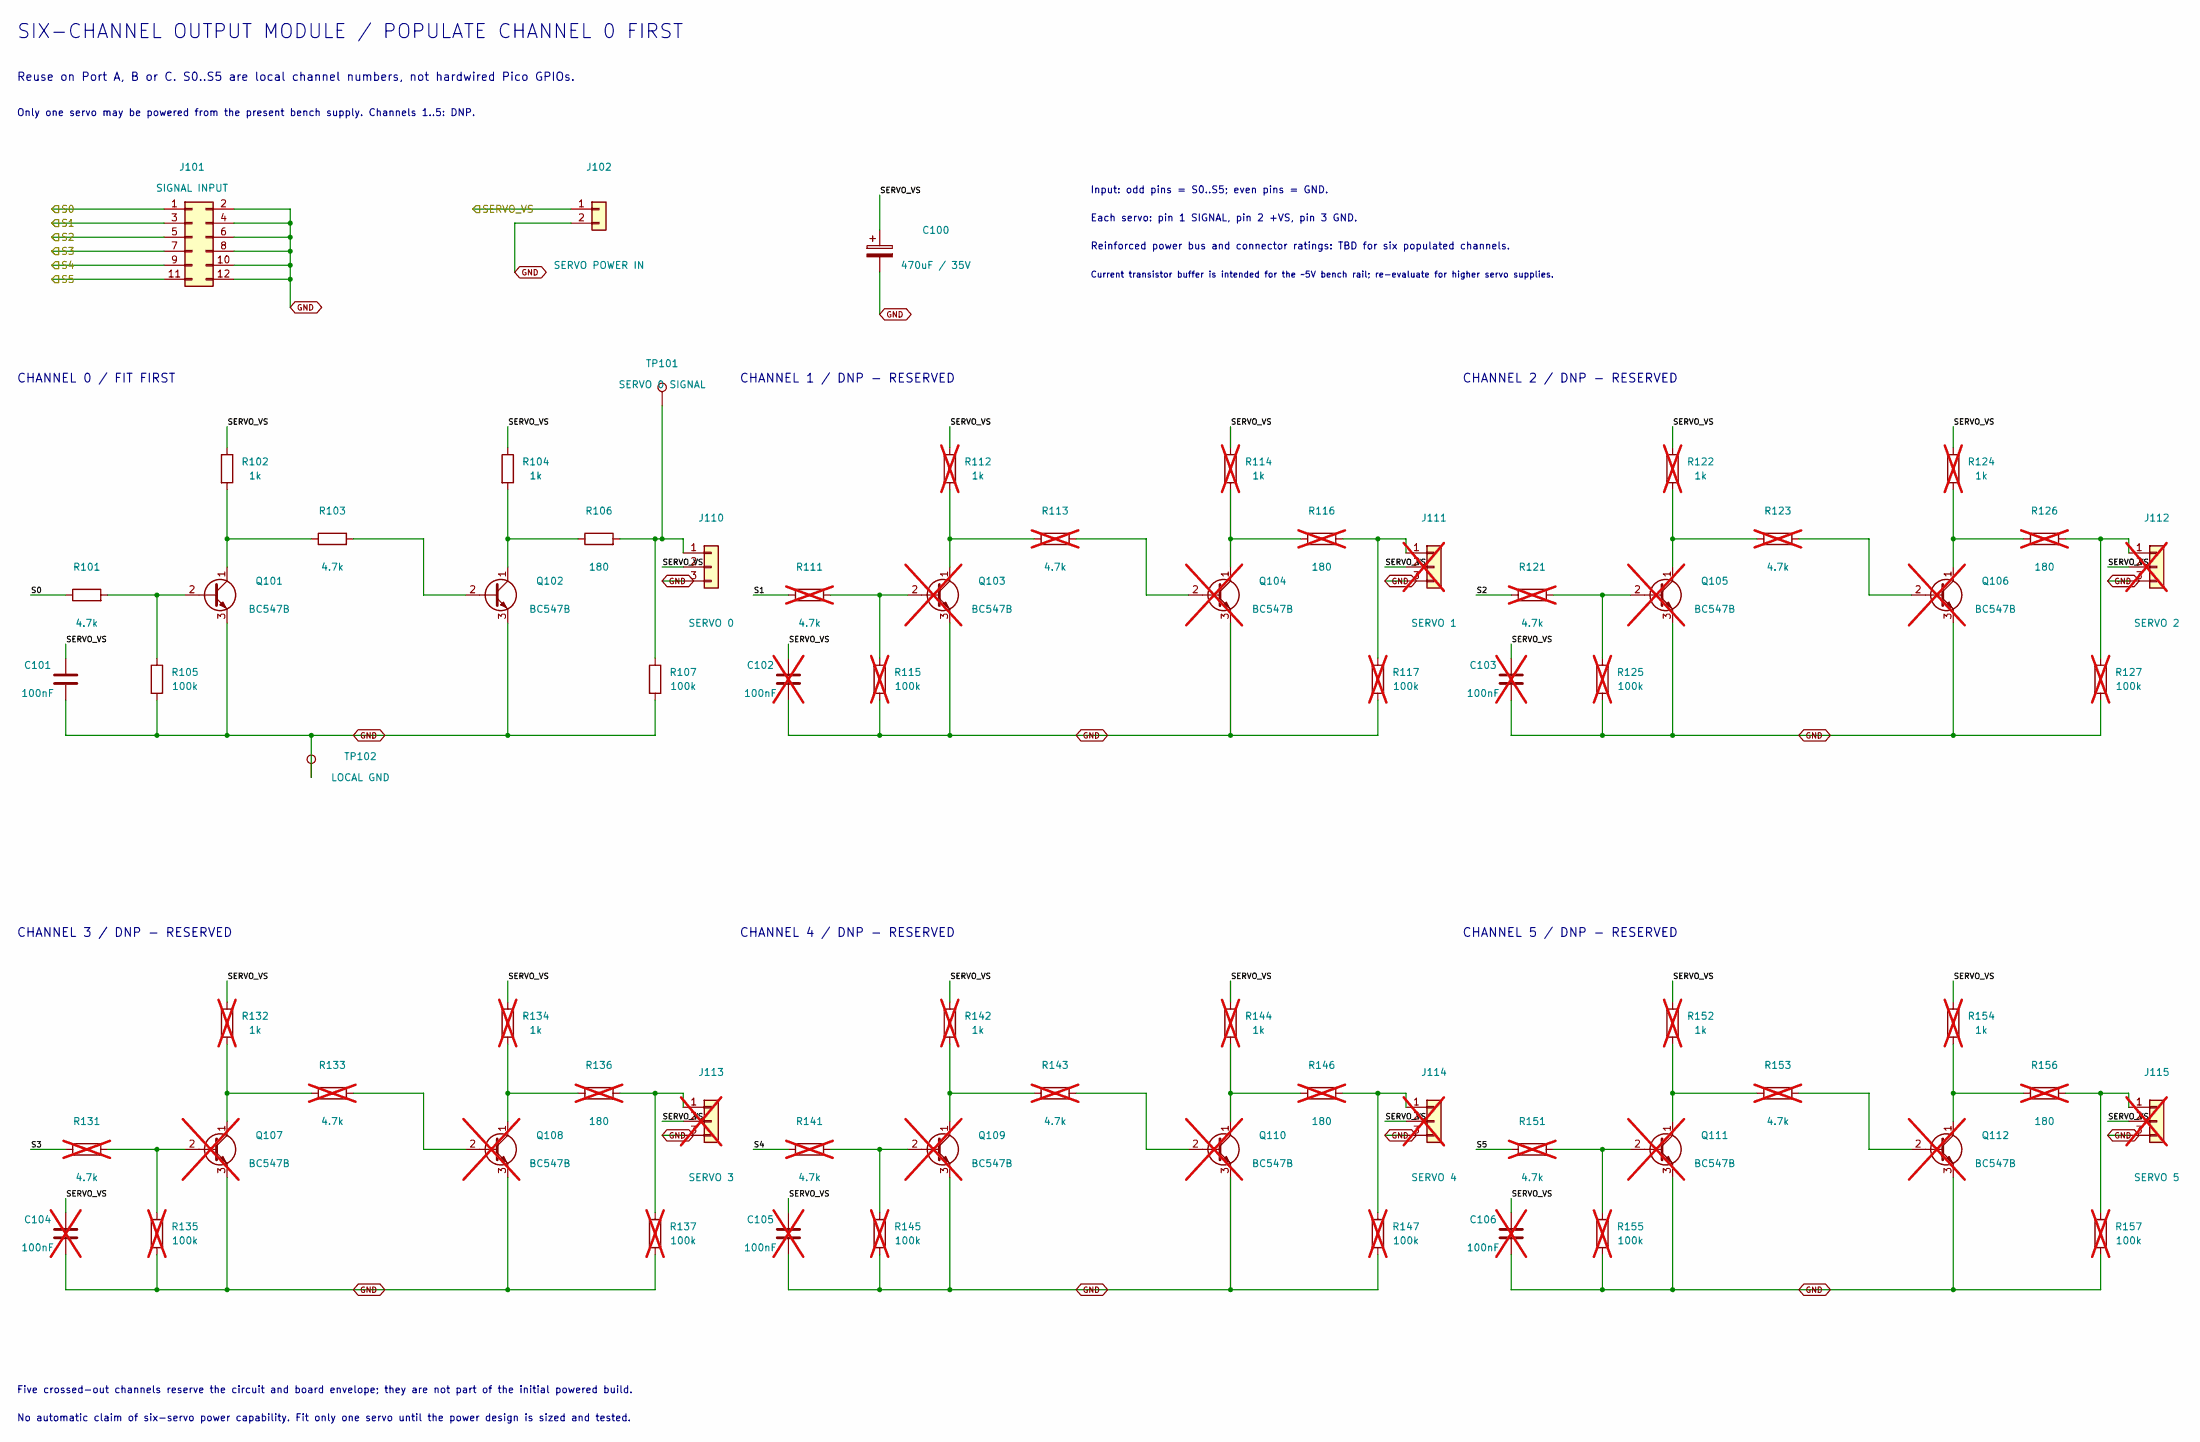
[picture p29: schematic servo-output-module.kicad_sch, Six-channel signal output module]

Parts:
C100: 470uF / 35V
C101: 100nF
C102, C103, C104, C105, C106: 100nF; not fitted
J101: SIGNAL INPUT; IDC-Header_2x06_P2.54mm_Vertical
J102: SERVO POWER IN
J110: SERVO 0
J111: SERVO 1; not fitted
J112: SERVO 2; not fitted
J113: SERVO 3; not fitted
J114: SERVO 4; not fitted
J115: SERVO 5; not fitted
Q101, Q102: BC547B; TO-92_Inline
Q103, Q104, Q105, Q106, Q107, Q108, Q109, Q110, Q111, Q112: BC547B; TO-92_Inline; not fitted
R101, R103: 4.7k
R102, R104: 1k
R105, R107: 100k
R106: 180
R111, R113, R121, R123, R131, R133, R141, R143, R151, R153: 4.7k; not fitted
R112, R114, R122, R124, R132, R134, R142, R144, R152, R154: 1k; not fitted
R115, R117, R125, R127, R135, R137, R145, R147, R155, R157: 100k; not fitted
R116, R126, R136, R146, R156: 180; not fitted
TP101: SERVO 0 SIGNAL
TP102: LOCAL GND

Connections:
/SERVO0_3V3: J101.1, R101.1
/SERVO1_3V3: J101.3, R111.1
/SERVO2_3V3: J101.5, R121.1
/SERVO3_3V3: J101.7, R131.1
/SERVO4_3V3: J101.9, R141.1
/SERVO5_3V3: J101.11, R151.1
/SERVO_VS: C100.1, C101.1, C102.1, C103.1, C104.1, C105.1, C106.1, J102.1, J110.2, J111.2, J112.2, J113.2, J114.2, J115.2, R102.1, R104.1, R112.1, R114.1, R122.1, R124.1, R132.1, R134.1, R142.1, R144.1, R152.1, R154.1; also elsewhere on the board
GND: C100.2, C101.2, C102.2, C103.2, C104.2, C105.2, C106.2, J101.2, J101.4, J101.6, J101.8, J101.10, J101.12, J102.2, J110.3, J111.3, J112.3, J113.3, J114.3, J115.3, Q101.3 (E), Q102.3 (E), Q103.3 (E), Q104.3 (E), Q105.3 (E), Q106.3 (E), Q107.3 (E), Q108.3 (E), Q109.3 (E), Q110.3 (E), Q111.3 (E), Q112.3 (E), R105.2, R107.2, R115.2, R117.2, R125.2, R127.2, R135.2, R137.2, R145.2, R147.2, R155.2, R157.2, TP102.1; also elsewhere on the board
unnamed: J110.1, R106.2, R107.1, TP101.1
unnamed: J111.1, R116.2, R117.1
unnamed: J112.1, R126.2, R127.1
unnamed: J113.1, R136.2, R137.1
unnamed: J114.1, R146.2, R147.1
unnamed: J115.1, R156.2, R157.1
unnamed: Q101.2 (B), R101.2, R105.1
unnamed: Q101.1 (C), R102.2, R103.1
unnamed: Q102.2 (B), R103.2
unnamed: Q102.1 (C), R104.2, R106.1
unnamed: Q103.2 (B), R111.2, R115.1
unnamed: Q103.1 (C), R112.2, R113.1
unnamed: Q104.2 (B), R113.2
unnamed: Q104.1 (C), R114.2, R116.1
unnamed: Q105.2 (B), R121.2, R125.1
unnamed: Q105.1 (C), R122.2, R123.1
unnamed: Q106.2 (B), R123.2
unnamed: Q106.1 (C), R124.2, R126.1
unnamed: Q107.2 (B), R131.2, R135.1
unnamed: Q107.1 (C), R132.2, R133.1
unnamed: Q108.2 (B), R133.2
unnamed: Q108.1 (C), R134.2, R136.1
unnamed: Q109.2 (B), R141.2, R145.1
unnamed: Q109.1 (C), R142.2, R143.1
unnamed: Q110.2 (B), R143.2
unnamed: Q110.1 (C), R144.2, R146.1
unnamed: Q111.2 (B), R151.2, R155.1
unnamed: Q111.1 (C), R152.2, R153.1
unnamed: Q112.2 (B), R153.2
unnamed: Q112.1 (C), R154.2, R156.1

Notes on the sheet:
SIX-CHANNEL OUTPUT MODULE / POPULATE CHANNEL 0 FIRST
Reuse on Port A, B or C. S0..S5 are local channel numbers, not hardwired Pico GPIOs.
Only one servo may be powered from the present bench supply. Channels 1..5: DNP.
Input: odd pins = S0..S5; even pins = GND.
Each servo: pin 1 SIGNAL, pin 2 +VS, pin 3 GND.
Reinforced power bus and connector ratings: TBD for six populated channels.
Current transistor buffer is intended for the ~5V bench rail; re-evaluate for higher servo supplies.
CHANNEL 0 / FIT FIRST
CHANNEL 1 / DNP - RESERVED
CHANNEL 2 / DNP - RESERVED
CHANNEL 3 / DNP - RESERVED
CHANNEL 4 / DNP - RESERVED
CHANNEL 5 / DNP - RESERVED
Five crossed-out channels reserve the circuit and board envelope; they are not part of the initial powered build.
No automatic claim of six-servo power capability. Fit only one servo until the power design is sized and tested.

Board: 2 copper layers, 83 parts (0 on the bottom side), 38 nets, no tracks yet.

Other parts of the board:
BG0, BG1, BG2, BG3, BG4, BG5: GND; TestPoint_THTPad_D2.0mm_Drill1.0mm
BV0, BV1, BV2, BV3, BV4, BV5: /SERVO_VS; TestPoint_THTPad_D2.0mm_Drill1.0mm

Their connections:
/SERVO_VS: BV0.1, BV1.1, BV2.1, BV3.1, BV4.1, BV5.1; also elsewhere on the board
GND: BG0.1, BG1.1, BG2.1, BG3.1, BG4.1, BG5.1; also elsewhere on the board
