ebe542/hexaroam/hardware/electronics/pico-baseboard-re200-lf/pico-baseboard-re200-lf.kicad_pcb

## KiCad design hardware/electronics/pico-baseboard-re200-lf/pico-baseboard-re200-lf.kicad_pcb (2026-10-27)

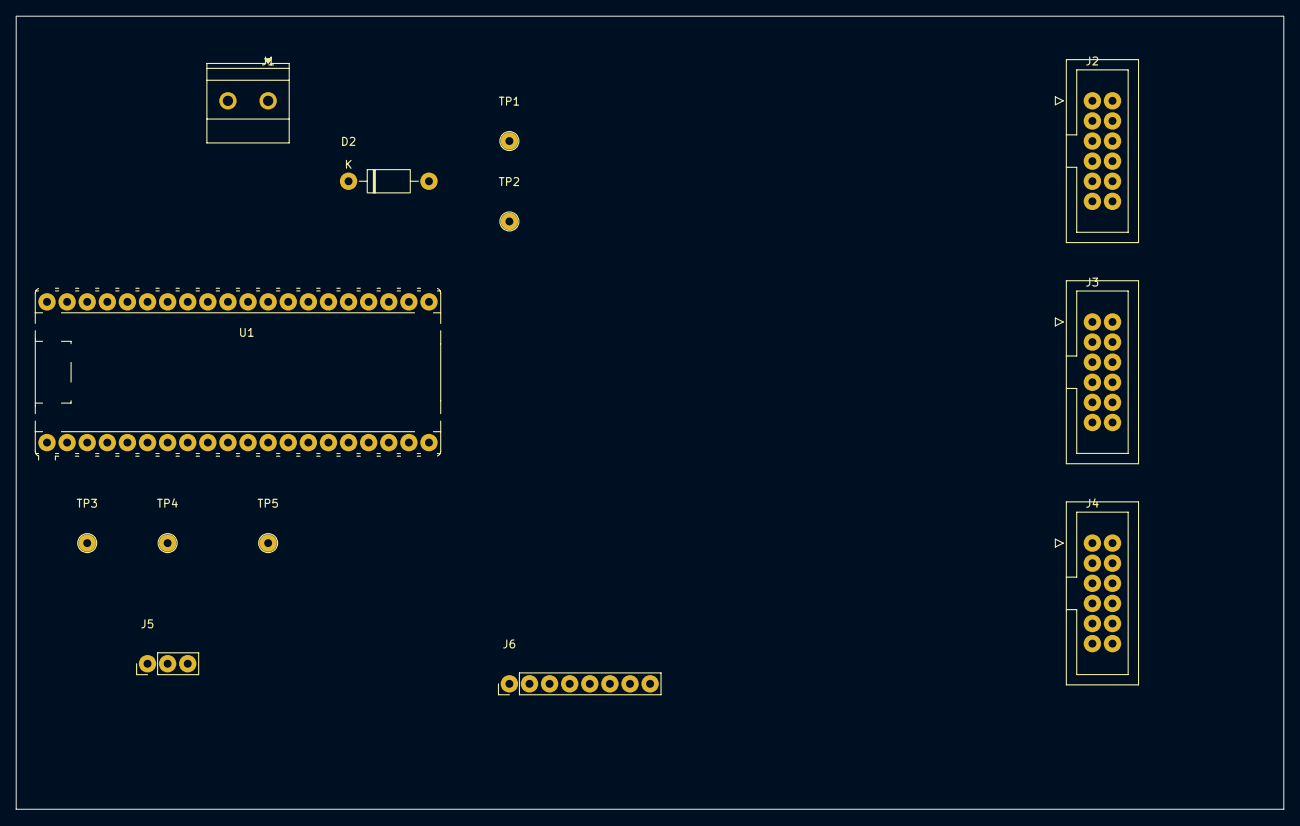
[picture p30: board pico-baseboard-re200-lf.kicad_pcb from above]

Board: 2 copper layers, 160.2 x 100.2 mm, 13 parts (0 on the bottom side), 31 nets, no tracks yet.

Parts:
D2: 1N5819; D_DO-41_SOD81_P10.16mm_Horizontal
J1: PICO 5V IN; TerminalBlock_Phoenix_MKDS-1,5-2-5.08_1x02_P5.08mm_Horizont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
J2: PORT A: 0..5; IDC-Header_2x06_P2.54mm_Vertical
J3: PORT B: 6..11; IDC-Header_2x06_P2.54mm_Vertical
J4: PORT C: 12..17; IDC-Header_2x06_P2.54mm_Vertical
J5: UART 3V3 TTL; PinHeader_1x03_P2.54mm_Vertical
J6: EXPANSION; PinHeader_1x08_P2.54mm_Vertical
TP1: VSYS; TestPoint_THTPad_D2.0mm_Drill1.0mm
TP2: USB VBUS; TestPoint_THTPad_D2.0mm_Drill1.0mm
TP3: GP0; TestPoint_THTPad_D2.0mm_Drill1.0mm
TP4: GP1; TestPoint_THTPad_D2.0mm_Drill1.0mm
TP5: GND; TestPoint_THTPad_D2.0mm_Drill1.0mm
U1: Raspberry Pi Pico; Pico_Socketed_RE200

Connections:
/GP18: J6.1, U1.24
/GP19: J6.2, U1.25
/GP22: J6.3, U1.29
/GP26: J6.4, U1.31
/GP27: J6.5, U1.32
/GP28: J6.6, U1.34
/PICO_3V3: J6.7, U1.36
/PICO_EXT_5V: D2.2, J1.1
/PICO_VSYS: D2.1, TP1.1, U1.39
/SERVO0_3V3: J2.1, TP3.1, U1.1
/SERVO1_3V3: J2.3, TP4.1, U1.2
/SERVO2_3V3: J2.5, U1.4
/SERVO3_3V3: J2.7, U1.5
/SERVO4_3V3: J2.9, U1.6
/SERVO5_3V3: J2.11, U1.7
/SERVO6_3V3: J3.1, U1.9
/SERVO7_3V3: J3.3, U1.10
/SERVO8_3V3: J3.5, U1.11
/SERVO9_3V3: J3.7, U1.12
/SERVO10_3V3: J3.9, U1.14
/SERVO11_3V3: J3.11, U1.15
/SERVO12_3V3: J4.1, U1.16
/SERVO13_3V3: J4.3, U1.17
/SERVO14_3V3: J4.5, U1.19
/SERVO15_3V3: J4.7, U1.20
/SERVO16_3V3: J4.9, U1.21
/SERVO17_3V3: J4.11, U1.22
/UART1_RX: J5.2, U1.27
/UART1_TX: J5.1, U1.26
/USB_VBUS: TP2.1, U1.40
GND: J1.2, J2.2, J2.4, J2.6, J2.8, J2.10, J2.12, J3.2, J3.4, J3.6, J3.8, J3.10, J3.12, J4.2, J4.4, J4.6, J4.8, J4.10, J4.12, J5.3, J6.8, TP5.1, U1.3, U1.8, U1.13, U1.18, U1.23, U1.28, U1.38
