ebe542/hexaroam/firmware/servo-control/src/lib.rs

#![no_std]

//! Hardware-independent servo angles and calibration.

mod angle;

pub use angle::{Angle, AngleError};

mod calibration;

pub use calibration::{Calibration, CalibrationError};

mod servo;

pub use servo::{PulseOutput, Servo, ServoChannel, ServoError};

mod servo_bank;

pub use servo_bank::{
    PulseBankLifecycle, PulseBankOutput, ServoBank, ServoBankError, ServoId,
    ServoTarget,
};

mod servo_signal_output;

pub use servo_signal_output::{
    ServoSignalOutput, ServoSignalOutputError, ServoSignalOutputInitError,
};
