ebe542/hexaroam/(commit log)

2026-10-12 docs: record Pico selection and reference docs
2026-10-12 feat: add Pico LED blink firmware
2026-10-13 feat: add PIO servo pulse driver
2026-10-14 refactor: extract testable servo signal logic
2026-10-14 feat: add two-point servo calibration
2026-10-14 feat: add calibrated servo angle commands
2026-10-15 feat: integrate angle commands into Pico firmware
2026-10-15 feat: support two independent PIO servo channels
2026-10-16 feat: add validated servo bank commands
2026-10-16 feat: add servo signal plan generation
2026-10-16 feat: encode servo signal entries for PIO
2026-10-16 feat: encode complete servo signal plans
2026-10-17 feat: drive fixed servo plans with PIO and DMA
2026-10-17 feat: switch complete servo signal plans
2026-10-17 feat(logging): add UART logs and panic output
2026-10-17 feat(pico): integrate UART logging and panic
2026-10-26 feat(servo): submit complete pulse batches
2026-10-27 feat(servo): add signal plan output adapter
2026-10-27 feat(pico): add servo bank angle hardware test
2026-10-27 test(pio): verify DMA abort timeout recovery
2026-10-27 Add calibration storage format and CRC
2026-10-28 Add calibration journal slot format
2026-10-28 Add calibration journal management
2026-10-28 Reserve flash sectors for calibration journal
2026-10-29 Add read-only Pico calibration storage
2026-10-29 Verify RAM-resident Pico routine
2026-10-29 Verify Pico XIP exit and restoration
2026-10-29 Validate calibration journal address ranges
2026-10-29 Program calibration journal slot from RAM
2026-10-29 Erase calibration journal sector from RAM
2026-10-30 Add Pico flash journal storage backend
2026-10-30 Verify calibration journal persistence on Pico
2026-10-30 Add repeatable Pico journal rotation test
2026-10-31 Add tested servo protocol framing and parser
2026-10-31 Prepare servo targets without signal output
2026-11-01 Stop signal output and retain DMA resources
2026-11-01 Connect servo bank to output lifecycle
2026-11-01 Test servo bank lifecycle on Pico
2026-11-02 Connect register service to servo bank
2026-11-02 Process register frames over byte transport
2026-11-02 Add Pico UART transport and loopback test
2026-11-03 Add UART register hardware test suite
2026-11-03 Accept calibration requests and report busy state
2026-11-04 Shorten UART test response observation
2026-11-04 Persist calibration requests after ACK submission
2026-11-04 Verify UART calibration persistence on Pico
2026-11-05 Add UART throughput benchmark and diagnostics
2026-11-05 Define COBS commands and EEPROM calibration
2026-11-06 Add command service with servo lifecycle control
2026-11-07 Integrate COBS commands with UART and PIO output
2026-11-07 Benchmark COBS commands across UART baud rates
2026-11-07 Add EEPROM driver and calibration storage traits
2026-11-08 Load calibrated servo data from EEPROM slots
2026-11-08 Add verified EEPROM writes and slot rotation
2026-11-08 Add EEPROM and revise controller pin mapping
2026-11-09 Restructure and rename servo controller app
2026-11-09 Add calibration station app and task selection
2026-11-09 Add calibration station single-output test
2026-11-10 Add calibration station command handling
2026-11-10 Add calibration station PIO backend adapter
2026-11-13 Connect calibration station UART and PIO output
2026-11-14 Add interactive servo calibration console
